paulrenzi/drone-detection-research/README.md

# trip/wire — low-cost acoustic drone detection

Published with GitHub Pages: https://paulrenzi.github.io/tripwire/

- `index.md` — overview and feasibility matrix
- `models/` — one page per sensor model (copy `models/_template.md` to add one)
- `research/` — cross-cutting research notes
- `changelog.md` — record rating changes and new research here
- `docs/PLAYBOOK-DRONE-DETECTION.md` — how the tripwire software is built and debugged (not published)

Built with Jekyll and the Just the Docs theme. Preview locally with `bundle exec jekyll serve` (optional) or just push — GitHub Pages builds it.

All content is compiled from public sources.
