paulrenzi/drone-detection-research/_handoff/2026-10-15-gpt61-cad-done.md

# Handoff: GPT-6.1's CAD run finished

Written at the commit that adds this file, whose parent is 6ab2442. 2026-10-15 ~22:40.
Supersedes the "IN PROGRESS" status in `2026-10-15-gpt61-cad-run.md`. Everything else there still holds.

## What happened

- Codex run PID 60296 (`gpt-6.1-sol`, effort `xhigh`, confirmed in `~/.codex/sessions/2026/10/15/rollout-...01a14247...jsonl`) ran 21:15 to 22:34 and ended `turn.completed`.
- `LAST_MESSAGE.md` was never written. Codex resolved `-o cad/gpt61/LAST_MESSAGE.md` against the wrong cwd ("system cannot find the path"). Its final message is the last `agent_message` in `run.jsonl`. **Next time, pass `-o` as an absolute path.**
- Its own report: 74/74 checks, 6/6 printed STEP/STL pairs validated, 17 renders. Dart 158.2 g, harness 183.5 g, 4 darts + harness 816.1 g.
- Paul said mid-run that "6.1 isn't working on this". The live process, log and file writes showed it was working. If he raises it again, ask what he was looking at; a `codex exec` run does not show in the Codex desktop app.

## Committed (explicit paths)

Scripts, `DESIGN.md`, `README.md`, `REVIEW.html`, `renders/` (17) and `out/` except four files over GitHub's 100 MB limit:
`out/assembly_carried.step`, `out/assembly_mid_release.step`, `out/assembly_stood.step` (244 MB each) and `out/bought_x500.step` (189 MB).
They are gitignored and regenerate with `build.py`. They exist only on Paul's PC.
Not committed: `sources/`, `cache/`, `vendor/`, `tmp/`, `run.*`.

## Open

- Paul has not reviewed the renders yet. Show them as they are; don't fix 6.1's work.
- The site is unchanged: `build-hardware.md` §1–2 still show the rejected v3/v2 renders. Ask Paul whether to replace or demote them.
