paulrenzi/drone-detection-research/_handoff/2026-10-15-gpt61-cad-run.md

# Handoff: the 3D models are being redone by GPT-6.1 (Codex agent)

HEAD at the time of writing: see the commit that adds this file (parent e75a807), 2026-10-15 ~21:20.
Supersedes `2026-10-15-build-pages-done.md`. Everything there about the hardware models is now superseded by the verdict below.

## Paul's verdict, settled (do not reopen)

- My CadQuery models (`cad/dart.py`, `harness*.py`, `v2.py`, `v3.py`) and their renders are **"total bullshit; nobody would build models like that."**
- **The concept is fine. The failure is the 3D modelling.** The parts were boxes and cylinders. Bought parts were blocks. The drone was not in the assembly, dimensions were guesses, and the "checks" only tested the model against itself.
- Paul wants **GPT-6.1 doing the CAD,** and said I didn't know how to ask it. The old ask was a single urllib API call, with no tools and my own design in the prompt, and it timed out.
- 🛑 **Don't re-pitch the concept or debate the CAD tool. Don't produce more Claude-built CAD.**

## What's live on the site (paulrenzi.github.io/drone-detection-research)

- `build-hardware.md` §1 is v3: three parts per dart, 15 parts per kit, ≈$50 parts list. It went live at e75a807 and was render-verified.
- §2 is v2 (its harness is still the "current" one), §3–4 are v1, §5 is TL-1, §6 is the parts list and §7 is "not designed yet".
- The renders on that page are the ones Paul rejected. **Nothing has been pulled from the site yet.** Ask Paul whether to demote or replace them once GPT-6.1's model exists.
- On cost, I told Paul honestly that it was cut by a fifth, not half. Cells are $20 of the $50. EVE 35V cells at $2.50 would halve it, but they were sold out at 18650batterystore and imrbatteries on 10-15.

## The GPT-6.1 run (IN PROGRESS at handoff)

- **How it's invoked:** Codex CLI bundled with the desktop app, signed in with Paul's ChatGPT account (not the paid API):
  `C:\Users\paulm\AppData\Local\OpenAI\Codex\bin\2e5e00daee91c61d\codex.exe exec -C C:\Users\paulm\drone-detection-research -c model_reasoning_effort='"xhigh"' -o cad/gpt61/LAST_MESSAGE.md --json "Read cad/gpt61/BRIEF.md and carry it out completely. Work only inside cad/gpt61/."`
  Config is in `~/.codex/config.toml`: model `gpt-6.1-sol`, approval `never`, sandbox `danger-full-access`.
- **The brief** is `cad/gpt61/BRIEF.md` (committed). It fixes the concept and asks for:
  - real bought-part models: X500 V2 frame, props, legs and rails; SG90; Heltec V3; INMP441; 18650;
  - properly modelled printed parts, with snap geometry, FDM clearances, wire channels and a serviceable pod;
  - the drone in the assembly, checked for interference in the carried, releasing and in-soil states;
  - mass and balance, STEP/STL exports and section renders, which it must inspect itself;
  - `DESIGN.md`.
- **Status:** started 21:15 as Codex process **PID 60296** (start time 9:15:44 PM). By 21:20 it had downloaded `x500v2-frame.step`, `heltec-v3-non-exact.step`, `X500-assembly.pdf` and `samsung-25r.pdf` into `cad/gpt61/sources/` (48 MB, gitignored), and had written probe and render scripts.
- **It's done when** `cad/gpt61/LAST_MESSAGE.md` exists, or `run.jsonl` contains `"turn.completed"`, `"turn.failed"` or `"type":"error"`. Progress is in `cad/gpt61/run.jsonl` (gitignored).
- **If the PC session died,** check whether PID 60296 is alive. If it isn't and there's no `LAST_MESSAGE.md`, rerun the command above; it reads the same brief.
- 🛑 **Never kill `codex.exe` by name.** The Codex/ChatGPT desktop app runs its own `codex.exe` backends from the same path. I killed three of them by accident on 10-15, which interrupted any desktop task running at the time; the app respawned them. Target only the PID of your own run.

## Next steps

1. When the run finishes, read `cad/gpt61/DESIGN.md` and **look at every render in `cad/gpt61/renders/`**. Show Paul the renders and the write-up **as they are**: don't polish them, and don't silently fix 6.1's work.
2. Commit 6.1's scripts, `out/` and renders by explicit path (not `sources/` or `run.*`), and push.
3. Ask Paul before touching the site: whether to replace §1–2's renders with 6.1's model, or demote the old ones.

## Still open from earlier (unchanged)

- Measure the X500 rail spacing, the SG90 shaft height above its tabs, the rod's real diameter, the cell's real diameter (25R is 18.4 mm), and the bare Heltec V3's sleep current on battery.
- Batear nonce-fix PR: outward-facing, needs Paul's OK.
- Offered but not done: retrieval and printed-drone cost sections, and stale X500 prices on `research/delivery-drone.md`.

## Rules that bit this session

- Playwright runs from the system `python`, not the cad venv.
- A heading id that starts with a digit needs `document.getElementById`, not a CSS `#` selector.
- kramdown renders `v2's` as `v2’s` (curly), so text checks must use the curly form.
- Pages build check: `gh api repos/paulrenzi/drone-detection-research/pages/builds/latest`. Verify by rendering `?cb=<sha>`.
