paulrenzi/drone-detection-research/cad/gpt61/LAST_MESSAGE-tail-fins.md

Completed inside `cad/gpt61/`; no commit or push. See [REVIEW.html](/C:/Users/paulm/drone-detection-research/cad/gpt61/REVIEW.html) and the rebuilt [print kit](/C:/Users/paulm/drone-detection-research/cad/gpt61/out/print-kit.zip).

- **Fins:** four PETG trapezoids on two bonded, keyed collars; 6.46 in root chord, 0.59 in exposed span, 0.047 in thick. Print without supports.
- **Estimated static margin:** 1.84 in / 1.25 body widths before; **3.06 in / 2.08 widths after**.
- **Mass and balance:** 5.91 oz per dart; balance point **10.891 in from the tip**. Four darts: 1.48 lb; with harness: **1.88 lb**. Dummy matches with 1.30 oz ballast.
- **Carriage:** retained flat at balance. Tilted alternatives interfere with the existing head support.
- **Validation:** **164/164 checks pass**, 14 printed export pairs validated, all 38 PNGs inspected. Updated STEP assemblies, GLBs, manifests and receipts; GLB validators report zero errors or warnings.

Estimated no-drag tilt from vertical:

| Drop | 5 mph | 10 mph | 15 mph |
|---|---:|---:|---:|
| 16 ft | 12.9° | 24.6° | 34.4° |
| 33 ft | 9.0° | 17.7° | 25.5° |
| 49 ft | 7.4° | 14.6° | 21.4° |

All requested CAD/package work is complete. Nothing has been printed, dropped or flown; controlled dummy drops must establish the actual fall behaviour.
