paulrenzi/drone-detection-research/cad/gpt61/LAST_MESSAGE-us-units.md

Completed entirely inside `cad/gpt61/`.

- Regenerated and inspected all **33 PNGs** at full size.
- Converted all requested documents to US units and fixed typography.
- **140/140 geometry checks**, **12/12 export checks** pass; four GLBs validate with zero errors or warnings.
- Rebuilt the print kit and refreshed receipts.

Geometry, cameras, colours and machine-readable values remain unchanged. Only required metric exceptions remain. No commit or push.

[Review gallery](/C:/Users/paulm/drone-detection-research/cad/gpt61/REVIEW.html) · [Print kit](/C:/Users/paulm/drone-detection-research/cad/gpt61/out/print-kit.zip)
