paulrenzi/drone-detection-research/cad/gpt61/LAST_MESSAGE-xiao.md

Completed inside `cad/gpt61/`: redesigned XIAO/Wio pod with USB/BOOT access, adjustable stake adapter, balanced inert dummy, and regenerated CAD, renders, documentation and web models.

- Dart: **147.93 g**, previously 158.16 g.
- Hanger: **254.44 mm from tip**.
- Harness: **183.48 g**; four-dart payload: **775.20 g**.
- Mic height: **500 mm**; dummy ballast: **36.82 g**.

All **140 geometry checks** and **12 STEP/STL export checks** pass. All **33 renders inspected**. Four GLBs validate with zero errors/warnings: dart **3.23 MB**, harness **4.13 MB**, aircraft **18.96 MB**, stake **3.22 MB**.

[Review gallery](C:/Users/paulm/drone-detection-research/cad/gpt61/REVIEW.html) · [Design and sources](C:/Users/paulm/drone-detection-research/cad/gpt61/DESIGN.md) · [Print kit](C:/Users/paulm/drone-detection-research/cad/gpt61/out/print-kit.zip)

Unverified dimensions remain marked **MEASURE**. Nothing printed, dropped or flown; no commit or push.
