paulrenzi/drone-detection-research/tools/laymodel/out/fibre-summary.md

## Fibre trunks and wider coverage (1000 lays each, GPS jammed, confirm)

| Case | Front darts | Relays | Planned | Planned sorties | Whole | Survives any one dart loss | Survives one fibre cut | Darts used | 9 in 10 | Sorties | Hours | Hops home, median / 9 in 10 | Cost of a lay | Worst warning, 10th pct |
|---|---|---|---|---|---|---|---|---|---|---|---|---|---|---|
| Last plan: radio trunks, +/-45 | 13 | 12 | 25 | 7 | 99% | 93% | - | 34.9 | 40 | 9.3 | 2.2 | 10 / 11 | $1309 | 58 s |
| Fibre trunks, +/-45 | 13 | 0 | 13 | 4 | 99% | 91% | 98% | 17.6 | 21 | 5.6 | 1.1 | 6 / 6 | $883 | 58 s |
| Radio trunks, +/-60 | 16 | 12 | 28 | 7 | 98% | 93% | - | 40.2 | 46 | 10.7 | 2.9 | 12 / 13 | $1506 | 58 s |
| **Fibre trunks, +/-60 (the plan)** | 16 | 0 | 16 | 5 | 98% | 91% | 98% | 22.2 | 26 | 7.1 | 1.4 | 7 / 8 | $1067 | 58 s |
| same, judged at +/-45 | 16 | 0 | 16 | 5 | 99% | 92% | 98% | 22.2 | 26 | 7.1 | 1.4 | 7 / 8 | $1067 | 58 s |
| compass 4 deg, not 2 | 16 | 0 | 16 | 5 | 89% | 82% | 97% | 22.7 | 27 | 7.2 | 1.5 | 7 / 8 | $1080 | none (a track no dart hears) |
| radio hop 800 ft, not 980 | 19 | 0 | 19 | 6 | 99% | 91% | 97% | 26.7 | 31 | 8.0 | 1.7 | 9 / 10 | $1236 | 58 s |
| landings 95% upright | 16 | 0 | 16 | 5 | 100% | 93% | 99% | 19.8 | 23 | 6.3 | 1.2 | 7 / 8 | $952 | 58 s |
| 1 fibre in 5 breaks while laid | 16 | 0 | 16 | 5 | 98% | 87% | 93% | 23.3 | 28 | 7.8 | 1.7 | 7 / 8 | $1152 | 58 s |
| 15 mph wind | 16 | 0 | 16 | 7 | 99% | 91% | 97% | 22.1 | 26 | 8.1 | 1.7 | 7 / 8 | $1059 | 58 s |
| Fibre trunks, +/-45, compass 4 deg | 13 | 0 | 13 | 4 | 92% | 83% | 97% | 17.9 | 22 | 5.7 | 1.1 | 6 / 6 | $895 | 56 s |
| Fibre trunks, +/-60, compass 4 deg, judged at +/-45 | 16 | 0 | 16 | 5 | 94% | 86% | 96% | 22.7 | 27 | 7.2 | 1.5 | 7 / 8 | $1080 | 57 s |
| Radio trunks, +/-45, compass 4 deg | 13 | 12 | 25 | 7 | 91% | 87% | - | 35.1 | 40 | 9.3 | 2.2 | 10 / 11 | $1315 | 56 s |
| Radio trunks, +/-60, compass 4 deg | 16 | 12 | 28 | 7 | 90% | 84% | - | 40.3 | 47 | 10.7 | 2.9 | 12 / 13 | $1512 | 54 s |
