paulrenzi/drone-detection-research/research/frontline-kit.md

---
title: What troops have, and what listening adds
parent: Research Notes
nav_order: 0.35
---

# What front-line troops actually have, and what listening adds
{: .no_toc }

<p class="vz-lede">What Ukrainian troops within about 12 mi of the line actually use against drones in 2025–2026, and what a cheap listener adds to each. <strong>Against fibre-optic FPVs, the real baseline is ears, eyes and a firearm.</strong></p>

### Against a fibre-optic FPV, what works

<div class="vz-tiles">
  <div class="vz-tile"><span class="vz-tile-q">Ears and eyes</span><span class="vz-tile-cost">the main detector today; ~5 s</span><span class="vz-chip vz-chip-open">partly</span></div>
  <div class="vz-tile"><span class="vz-tile-q">Radio detectors</span><span class="vz-tile-cost">blind: no radio link to hear</span><span class="vz-chip vz-chip-no">doesn't</span></div>
  <div class="vz-tile"><span class="vz-tile-q">Signature detectors</span><span class="vz-tile-cost">radio-based too</span><span class="vz-chip vz-chip-no">doesn't</span></div>
  <div class="vz-tile"><span class="vz-tile-q">Jammers</span><span class="vz-tile-cost">nothing to jam</span><span class="vz-chip vz-chip-no">doesn't</span></div>
  <div class="vz-tile"><span class="vz-tile-q">Shotguns and rifles</span><span class="vz-tile-cost">short range only</span><span class="vz-chip vz-chip-open">partly</span></div>
  <div class="vz-tile"><span class="vz-tile-q">Shooter teams</span><span class="vz-tile-cost">need to know where</span><span class="vz-chip vz-chip-open">partly</span></div>
  <div class="vz-tile"><span class="vz-tile-q">Net-guns</span><span class="vz-tile-cost">very close range</span><span class="vz-chip vz-chip-open">partly</span></div>
  <div class="vz-tile"><span class="vz-tile-q">AI turret</span><span class="vz-tile-cost">claimed; at the position only</span><span class="vz-chip vz-chip-done">works</span></div>
  <div class="vz-tile"><span class="vz-tile-q">Interceptor drones</span><span class="vz-tile-cost">no verified FPV kill</span><span class="vz-chip ">unknown</span></div>
  <div class="vz-tile"><span class="vz-tile-q">Nets and net tunnels</span><span class="vz-tile-cost">leaky; drones fly under</span><span class="vz-chip vz-chip-open">partly</span></div>
  <div class="vz-tile"><span class="vz-tile-q">Movement discipline</span><span class="vz-tile-cost">night, fog, on foot</span><span class="vz-chip vz-chip-open">partly</span></div>
  <div class="vz-tile"><span class="vz-tile-q">Acoustic sensors</span><span class="vz-tile-cost">makers' claims only</span><span class="vz-chip ">unknown</span></div>
</div>
<p class="vz-bar-note">From first-hand accounts, purchase volumes and our inference. No source ranks these against each other or says what share of units has each. Reviewed 2026-10-15.</p>

<div class="vz-cards">
  <div class="vz-card"><p class="vz-card-num">The gap</p><p>The most common warning device, the radio detector, can't hear a fibre-optic drone. Still open in 2026</p></div>
  <div class="vz-card"><p class="vz-card-num">The money</p><p>goes to interceptor drones, the most-ordered category in 2026, bought against recon drones and Shaheds, not attacking FPVs</p></div>
  <div class="vz-card"><p class="vz-card-num">Where we help most</p><p>Most FPVs fibre-optic, units moving in the open, no turret yet. Only the line gives a minute (inference)</p></div>
</div>

## The details

Each section opens for the full reasoning, numbers and sources.

<button type="button" class="layer-toggle" data-layers-toggle>Open all sections</button>

<details class="layer" id="the-short-version-in-full" markdown="block">
<summary><span class="layer-title">The opening, as first written</span><span class="layer-sub">What the page covers, and why no source ranks these measures</span></summary>

This page covers what Ukrainian troops within about 12 mi of the line actually use against FPV and recon drones in 2025–2026, as opposed to what is in catalogues. For each item, it asks what a cheap acoustic listener adds. Use it with [What the line gains in lives]({{ site.baseurl }}{% link research/lives-model.md %}): that page estimates the lives; this one says what the line is up against. Reviewed 2026-10-15.

{: .warning }
> **No source ranks these measures against each other.**
> - We found no soldier survey and no RUSI, ISW, CNA or IISS comparison of counter-FPV measures.
> - We found no figure for what share of units has any item.
> - The judgements below come from first-hand accounts, purchase volumes and our own inference, labelled as such.

</details>

<details class="layer" id="short-answer" markdown="block">
<summary><span class="layer-title">Short answer</span><span class="layer-sub">Ears and firearms, blind radio detectors, jamming losing ground, interceptors, AI turrets</span></summary>

- **Against fibre-optic FPVs, the real baseline is ears, eyes and a firearm.** A Ukrainian border guard spokesman said fibre-optic drones are detected "by ear and visually" and "You can only shoot it down" ([Gwara Media, Feb 2025](https://gwaramedia.com/en/border-guards-russian-troops-actively-use-fiber-optic-drones-resistant-to-jamming-north-of-kharkiv-oblast/)). A listener at the position competes first with a soldier's hearing, not with a product.
- **The most common warning device is blind to fibre-optic drones.** Radio detectors such as Chuyka and Tsukorok can't hear a drone with no radio link. This gap is still open in 2026.
- **Jamming is losing ground.** A brigade EW company commander: "Jamming no longer works", and against fibre-optic drones "There was, in fact, nothing to counter them" ([Euromaidan Press, Jun 2025](https://euromaidanpress.com/2025/06/26/is-the-electronic-warfare-era-over-a-frontline-ew-officers-story-of-ukraines-drone-tug-of-war)). So cueing jammers (the [MEDUSA]({{ site.baseurl }}{% link research/competitors.md %}#partners-and-the-budget-we-compete-for) pairing) is worth less each year.
- **The money is going to interceptor drones, not detection.** Interceptors were the most-ordered category on Ukraine's Brave1 Market in Jan–Sep 2026, out of more than 590,000 drones ordered. But they are bought against recon drones and Shaheds, not against FPVs attacking a position.
- **The nearest rival at a position is the AI turret.** It detects and tracks fibre-optic drones itself, and "more than 10 military units" had it by May 2026. Where it spreads, it covers the last seconds at the position. It does not give a minute's warning to people about to move.
- **Overall (inference):** the forward line's relative value is highest where three things hold:
  1. most FPVs are fibre-optic;
  2. units must move in the open;
  3. turrets have not arrived.

  A listener at the position adds least once a turret or a good sentry is there. A minute's warning of fibre-optic drones is offered by nothing else we found.

</details>

<details class="layer" id="the-inventory" markdown="block">
<summary><span class="layer-title">The inventory</span><span class="layer-sub">Every measure: how common, whether it works against fibre-optic FPVs, and what a listening line adds</span></summary>

Key: ✅ works, 🟡 partly, ❌ doesn't, ❔ unknown.

| What troops have | How common at the front | Against fibre-optic FPVs | Warning it needs or gives | What a listening line adds |
|---|---|---|---|---|
| **Ears and eyes** (sentries) | Universal | 🟡 the main detector today | Gives ~5 s at ~490 ft (unmeasured) | A position listener competes with this directly. The line gives a minute instead |
| **Radio detectors** (Chuyka, Tsukorok) | The most widely distributed warning device. Tsukorok aimed at "up to 10,000 detectors every month" in 2024 ([Foreign Policy](https://foreignpolicy.com/2024/08/05/ukraine-russia-war-drone-detectors-jamming-tsukorok/)). Share of units equipped: not found | ❌ "commonly used by units to warn them of FPVs", but cannot detect fibre-optic drones ([Kyiv Independent, May 2025](https://kyivindependent.com/as-russias-fiber-optic-drones-flood-the-battlefield-ukraine-is-racing-to-catch-up/)) | Gives ~1.5–2.5 min against radio FPVs | **The fibre-optic half.** A partner, not a rival: the [second box]({{ site.baseurl }}{% link research/competitors.md %}) |
| **Signature-reading detectors** | "the first Ukrainian device capable of distinguishing drone types" was only being tested in Jul 2026; Russian soldiers already carry Chinese "Bulat" detectors ([Euromaidan Press, Jul 2026](https://euromaidanpress.com/2026/07/15/you-cant-jam-what-you-cant-identify-ukraine-just-fielded-its-first-portable-drone-detector/)) | ❌ radio-based. Its tester also complains "the front is already saturated with video transmitters up to 8 GHz" | Radio warning only | Same as above |
| **Jammers** (trench, vehicle, position) | Many makers; EW added to the DOT-Chain Defence marketplace in Nov 2025, with nearly UAH 6 million ordered on the first day ([MoD](https://mod.gov.ua/en/news/frontline-units-to-receive-additional-electronic-warfare-assets-via-dot-chain-defence)) | ❌ "There was, in fact, nothing to counter them". Infantry kits "only partially solved the problem" (EW commander, 56th Brigade) | Needs a cue to switch on | A cue for radio drones that detectors miss. **Shrinking value** as fibre-optic and multi-band drones grow |
| **Shotguns and rifles** | Common. Troops are often issued "shot that is too fine to stop a heavy aerial target" | 🟡 only at short range. With heavier 15-inch FPVs, the safe distance is at least 130–160 ft, firing rifles "while remaining in cover" ([Militarnyi, Jun 2026](https://militarnyi.com/en/news/shotguns-ineffective-15-inch-fpv-drones/)) | Needs seconds | Seconds plus a direction, if a listener can give one ([localization]({{ site.baseurl }}{% link research/localization.md %})). A minute adds little |
| **Mobile shooter teams** | Used by some brigades. "when Russian drone operators spot these teams, they tend to avoid those areas" ([UNITED24, Oct 2025](https://united24media.com/war-in-ukraine/can-fiber-optic-drones-be-stopped-how-ukraine-faces-the-unjammable-threat-12502)) | 🟡 | Needs to know where drones fly | **Inference:** a line's record of where drones cross could show where to send teams. Not tested |
| **Net-guns** | "uncommon", a "last‑resort" weapon (same UNITED24 report) | 🟡 very close range | Needs seconds | ≈0 |
| **AI turret** (Brave1 participant) | "More than 10 military units", May 2026 ([MoD](https://mod.gov.ua/en/news/over-10-military-units-are-now-equipped-with-a-ukrainian-ai-powered-turret-capable-of-destroying-ua-vs-with-a-single-button-press)); no price published | ✅ claimed: it "autonomously detects, tracks, and calculates the flight path" of fibre-optic drones | Brings its own sensor | Little at the position. The line still warns people away from the turret |
| **Interceptor drones** | Most-ordered category on Brave1 Market, Jan–Sep 2026 ([MoD via migflug, Sep 2026](https://migflug.com/afterburner/?p=24873239)) | ❔ we found no verified interception of an attacking FPV | Needs a cue and lead time | A possible cue against recon drones (inference; T11 decides whether we hear them). Unproven against FPVs |
| **Nets, net tunnels, vehicle nets** | At "all positions" (93rd Brigade, UNITED24); 2,500 mi more road planned for 2026 | 🟡 leaky. "They burn and melt. 'Waiting' drones can also hide under the nets"; videos show fibre-optic drones "simply flying underneath the nets to hit Ukrainian vehicles" (Kyiv Independent) | None | Warning for whatever gets through. Nothing against drones already waiting under nets |
| **Movement discipline** (night, fog, on foot) | Universal. Logistics shifted to daytime, and more people move on foot because "Enemy drone operators are currently more focused on targeting vehicles" (UNITED24) | 🟡 | Hours | The go/no-go minute. **This is where the [lives estimate]({{ site.baseurl }}{% link research/lives-model.md %}) puts nearly all the value** |
| **Acoustic sensors** (Zvook NW0, Kara Dag) | Not found in front-line use; maker claims only. Kara Dag notes that most microphones struggle to tell drone noise from ambient sound beyond about 330 ft ([Euromaidan Press, Feb 2025](https://euromaidanpress.com/2025/02/03/russias-fiber-optic-drones-dodge-jamming-but-ukraine-hunts-them-with-infrared-and-sound/)) | ❔ claimed | Seconds at the position | Direct competitors ([competitor analysis]({{ site.baseurl }}{% link research/competitors.md %})) |

</details>

<details class="layer" id="what-this-means-for-listening-tech-inference" markdown="block">
<summary><span class="layer-title">What this means for listening tech (inference)</span><span class="layer-sub">Where a listener adds most and least</span></summary>

1. **There are two different products here.**
   - **A listener at the position** gives about 10 seconds. It competes with sentries' ears, and soon with AI turrets that carry their own sensors. Its edge is cost and never tiring.
   - **A forward line** gives about a minute. Nothing we found gives a minute's warning of fibre-optic FPVs.
2. **The gap is real and still open.** Radio detectors can't hear fibre-optic drones, jamming is failing against them, and nets leak. Every first-hand account ends at ears, eyes and a gun.
3. **Pairing with jammers is a fading benefit.** It still holds against radio FPVs, but the EW commander's verdict means the line should be sold on warning people, not on cueing jammers.
4. **Interceptors are where the budget is.** If a line can cue interceptors against recon drones, it is tied to the fastest-growing purchase. That depends on T11 (can we hear them) and on whether interceptor crews want an acoustic cue. Ask in T18.
5. **The buying route is open.** Brave1 Market averages eight days to deliver stocked items, and 180 brigades have guaranteed budgets on DOT-Chain Defence. Being listed does not guarantee anyone buys.

</details>

<details class="layer" id="what-we-could-not-find" markdown="block">
<summary><span class="layer-title">What we could not find</span><span class="layer-sub">The gaps in the evidence</span></summary>

- What share of units has any of these items.
- Per-brigade counter-drone spend.
- Prices for jammers, the AI turret and small radars.
- Any measured effect of a detector on casualties.
- Any soldier survey ranking what helps most.
- **A demand for small mobile radar.** A drone-unit commander reportedly asked for mobile radar every 1.2–2.5 mi along the line. We saw that only in search snippets. If true, small radar is the nearest rival for forward warning, and it may struggle against low-flying drones.

T18 should ask which of these a unit actually has and which it trusts.

</details>
