paulrenzi/drone-detection-research/research/existing-systems.md

---
title: Existing systems and benchmarks
parent: Research Notes
nav_order: 1
---

# Existing systems and benchmarks
{: .no_toc }

1. TOC
{:toc}

## Fielded low-cost acoustic networks

| System | Origin | Hardware | Scale | Cost per sensor | Notes |
|---|---|---|---|---|---|
| **Sky Fortress** | Ukraine | Phone + mic on ~6.6 ft pole; central fusion; tablets for fire teams | ~10k sensors (2024–25), ~14k by July 2025 | $400–1,000 | Whole network ~$5M. Fuses radar data. Lithuania contracted a pilot. |
| **Zvook** | Ukraine (Lviv) | Microcomputers on radio towers | Not disclosed | Not disclosed | Started as civilian volunteer project. Vehicle version tested at NATO BATT26 with Latvia. |
| **Drone Rada** (Mainline) | Lithuania | Volunteers' Android phones near windows | Target 10,000 participants (June 2026) | ~$0 to operator | Crowd-sourced; privacy-focused, minimal data. |

## Commercial acoustic sensors (comparators)

| Product | Origin | Claim | Notes |
|---|---|---|---|
| **Discovair G2** (Squarehead Technology) | Norway | Detects and tracks small drones up to several hundred yards, no line-of-sight needed | Large patented mic array; sold inside DroneShield and Hensoldt XPELLER counter-UAS systems. |
| Roke acoustic detection | UK | Array-based drone detection | Research/product line from a UK defence firm. |

{: .note }
> Squarehead is likely the "Norway" half of the original framing. A specific open-source Ukraine/Norway drone **sound library** has **not** been found yet — see [Datasets]({{ site.baseurl }}{% link research/datasets.md %}).

## Who is pushing for this

- **Gen. James Hecker, USAFE / NATO Allied Air Command** — publicly urged copying Ukraine's acoustic network (2024) and mentioned tethered aerostats.
- **Lt. Gen. Stephen Gainey, US Army SMDC** — cited as an advocate; evaluations at Ramstein and in Romania.
- **Lithuania, Latvia, Poland, Baltic states** — piloting acoustic networks after airspace violations.

## Sources

- [TWZ — Ukraine's acoustic network eyed by U.S.](https://www.twz.com/air/ukraines-acoustic-drone-detection-network-eyed-by-u-s-as-low-cost-air-defense-option)
- [Euromaidan Press — Lithuania selects Ukrainian tech](https://euromaidanpress.com/2025/07/29/lithuania-to-deploy-ukrainian-drone-detection-system-by-2026-after-russian-airspace-violations/)
- [Startup Estonia — Zvook at BATT26](https://ecosystem.startupestonia.ee/news/note/zvook-tests-vehicle-mounted-acoustic-drone-detector-at-nato-s-batt26)
- [LRT — Drone Rada](https://www.lrt.lt/en/news-in-english/19/2965205/lithuanian-startup-launches-open-source-network-to-detect-shahed-type-drones)
- [Hensoldt — XPELLER adds Squarehead Discovair](https://hensoldt.net/news/hensoldt-expands-xpeller-counter-uav-product-family)
- [DroneDJ — DroneShield + Squarehead](https://dronedj.com/2020/12/07/droneshield-squarehead-to-offer-counter-drone-solutions/)
- [Roke — acoustic drone detection](https://www.roke.co.uk/innovations/acoustic-drone-detection)
