paulrenzi/drone-detection-research/research/index.md

---
title: Research Notes
nav_order: 3
has_children: true
permalink: /research/
---

# Research Notes

Background that applies across all the sensor models: what already exists, the physics of range and cost, how positions are computed, parts, training data, military integration, and the rules that apply.

Add a new note by creating a Markdown file in `research/` with `parent: Research Notes` in its front matter.
