paulrenzi/drone-detection-research/assets/images/kit/camera-drone.jpg

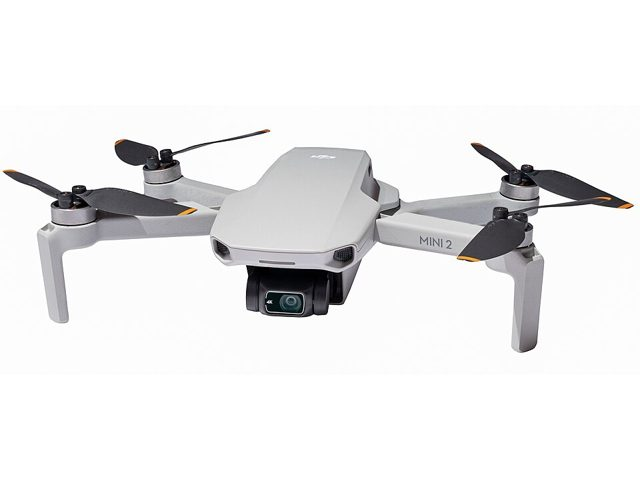
assets/images/kit/camera-drone.jpg
