paulrenzi/drone-detection-research/assets/images/kit/esp32-s3.jpg

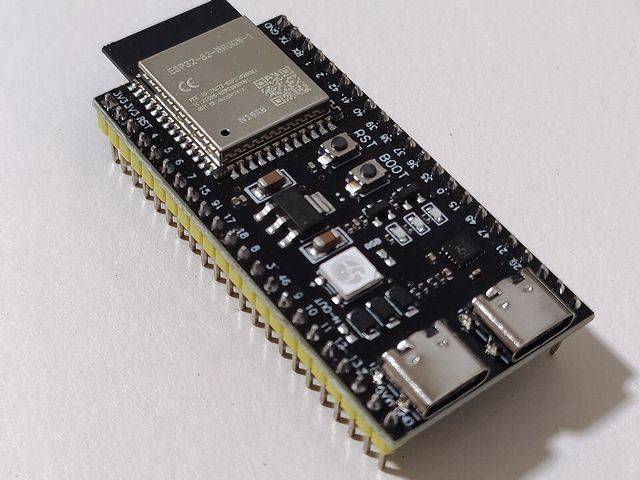
assets/images/kit/esp32-s3.jpg
