paulrenzi/drone-detection-research/assets/images/kit/fpv-drone.jpg

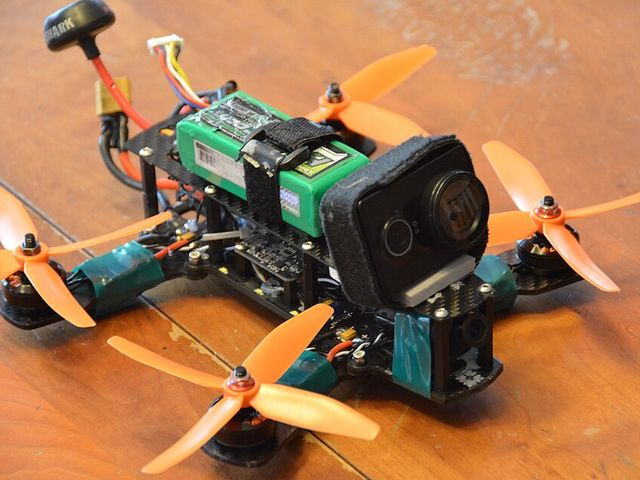
assets/images/kit/fpv-drone.jpg
