paulrenzi/drone-detection-research/assets/images/kit/lora-board.jpg

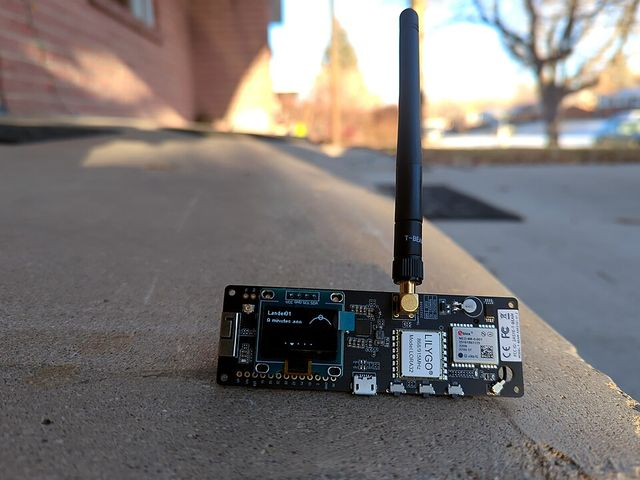
assets/images/kit/lora-board.jpg
