paulrenzi/drone-detection-research/assets/images/kit/microsd.jpg

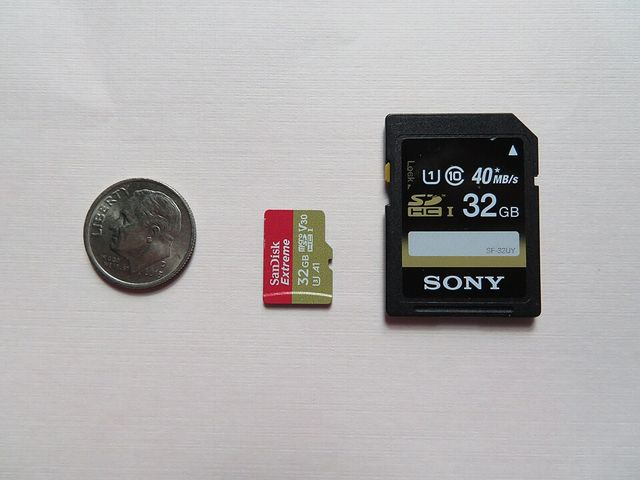
assets/images/kit/microsd.jpg
