paulrenzi/drone-detection-research/assets/images/kit/mics-breadboard.jpg

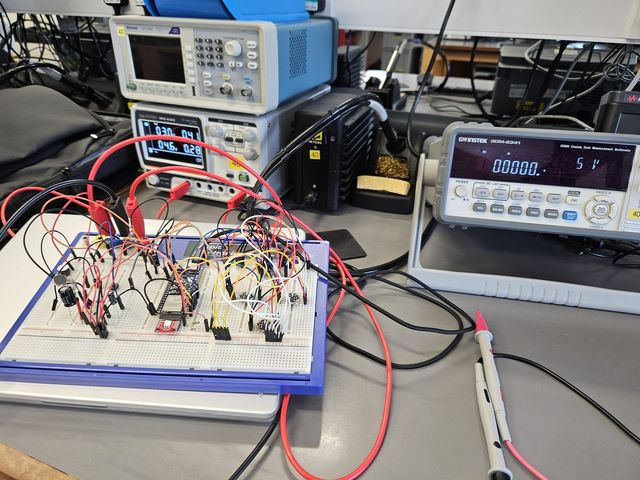
assets/images/kit/mics-breadboard.jpg
