paulrenzi/drone-detection-research/assets/images/kit/power-bank.jpg

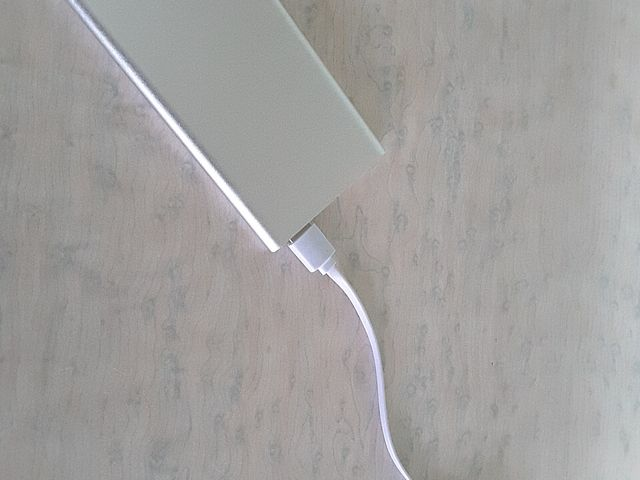
assets/images/kit/power-bank.jpg
