paulrenzi/drone-detection-research/assets/images/kit/tripod.jpg

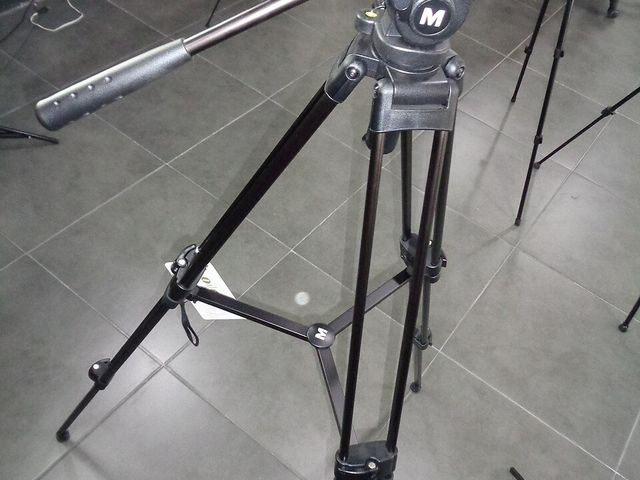
assets/images/kit/tripod.jpg
