paulrenzi/drone-detection-research/assets/images/kit/windscreen.jpg

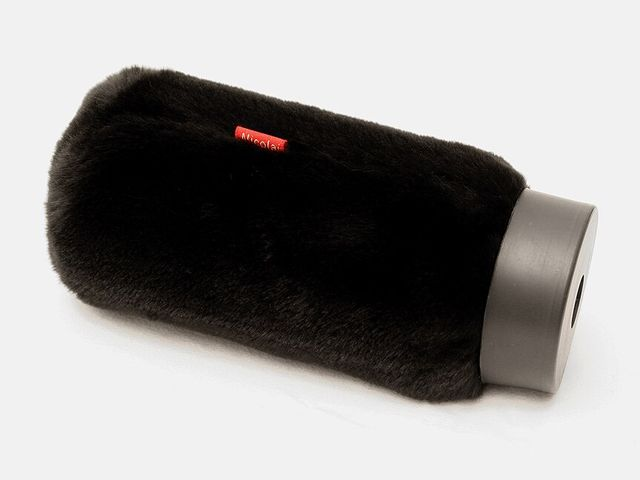
assets/images/kit/windscreen.jpg
