paulrenzi/drone-detection-research/assets/video/lay-net-poster.png

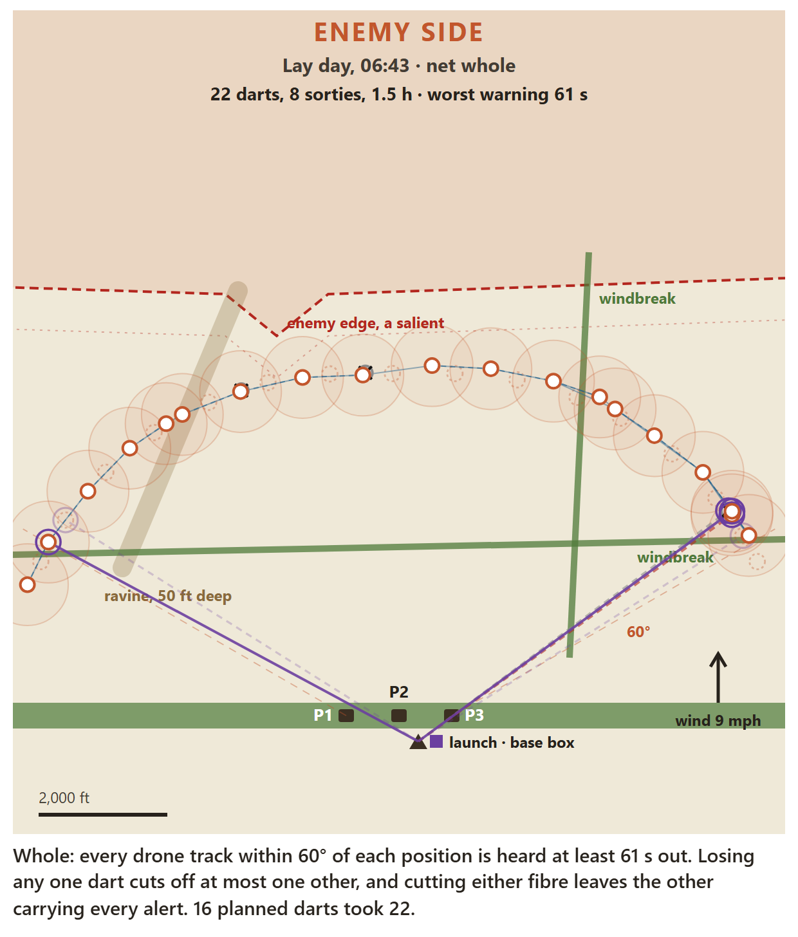
assets/video/lay-net-poster.png
