paulrenzi/drone-detection-research/cad/gpt61/renders/aircraft_exploded.png

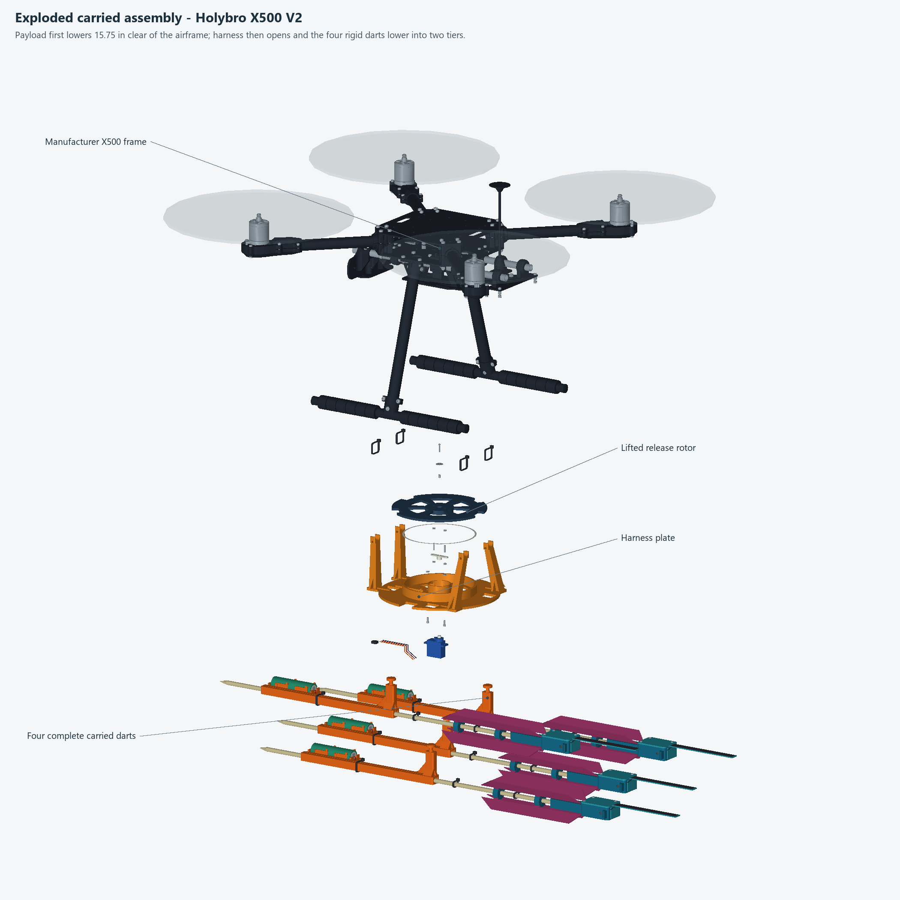
cad/gpt61/renders/aircraft_exploded.png
