paulrenzi/drone-detection-research/cad/gpt61/renders/bought_servo.png

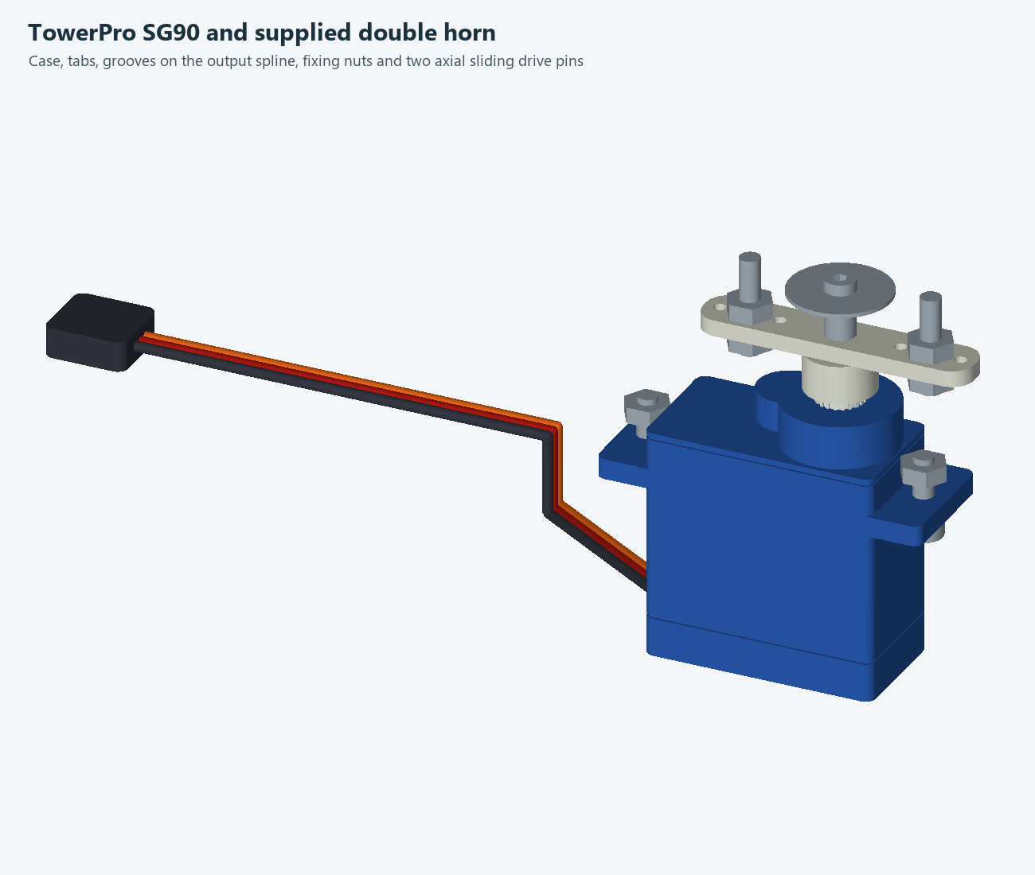
cad/gpt61/renders/bought_servo.png
