paulrenzi/drone-detection-research/cad/gpt61/renders/bought_xiao_wio.png

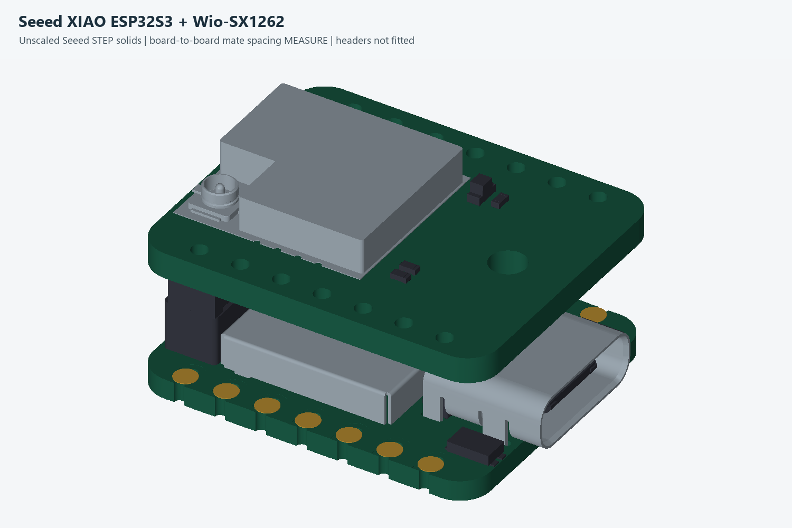
cad/gpt61/renders/bought_xiao_wio.png
