paulrenzi/drone-detection-research/cad/gpt61/renders/dart_exploded.png

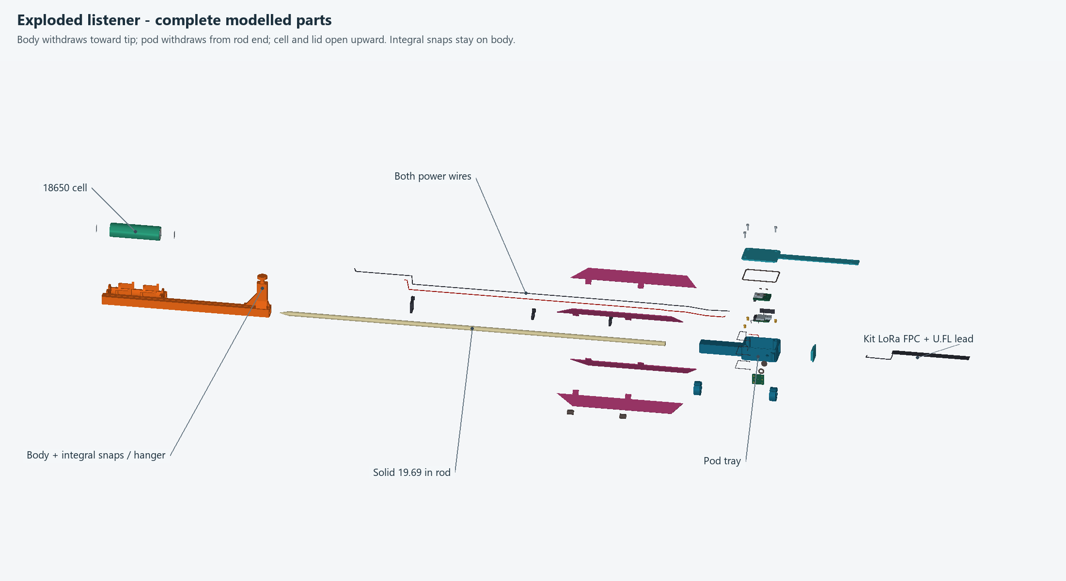
cad/gpt61/renders/dart_exploded.png
