paulrenzi/drone-detection-research/cad/gpt61/renders/dart_exploded_pod.png

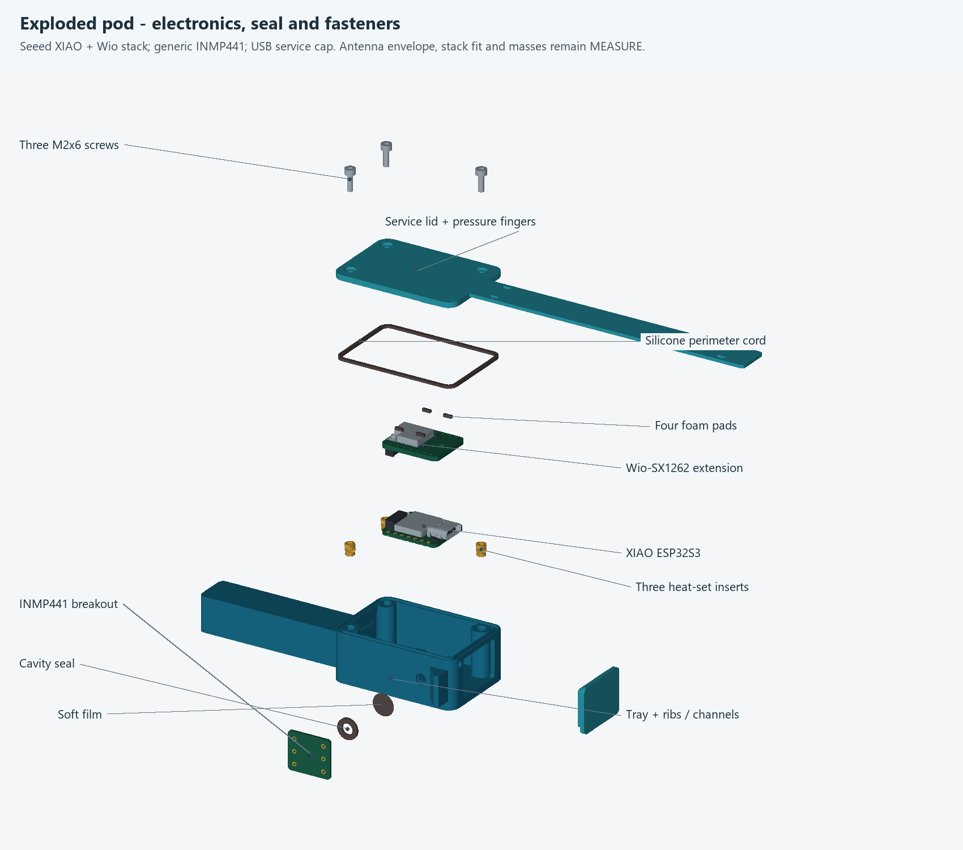
cad/gpt61/renders/dart_exploded_pod.png
