paulrenzi/drone-detection-research/cad/gpt61/renders/dart_fins_detail.png

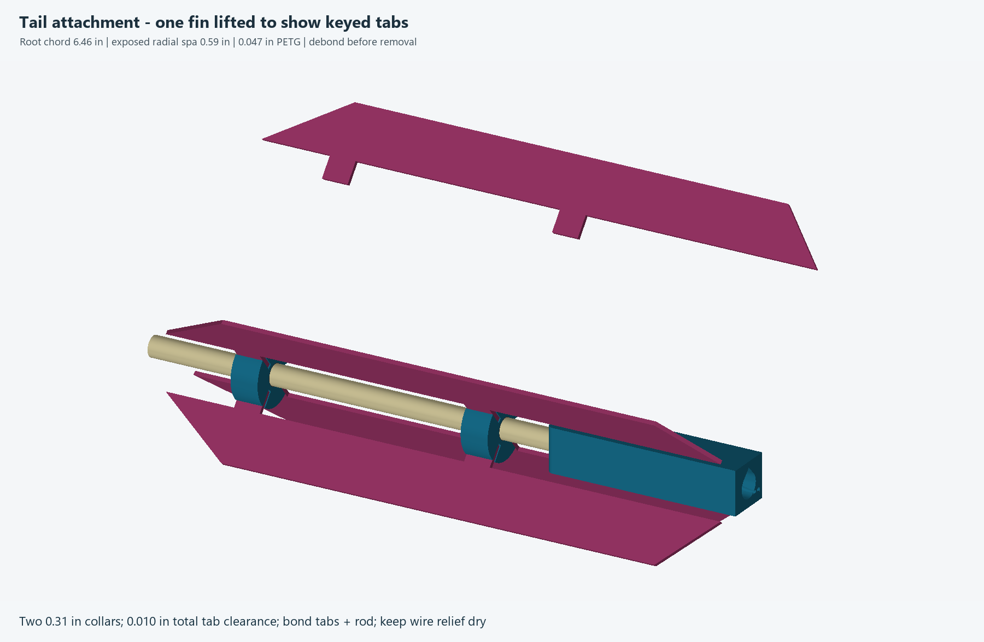
cad/gpt61/renders/dart_fins_detail.png
