paulrenzi/drone-detection-research/cad/gpt61/renders/dart_stood.png

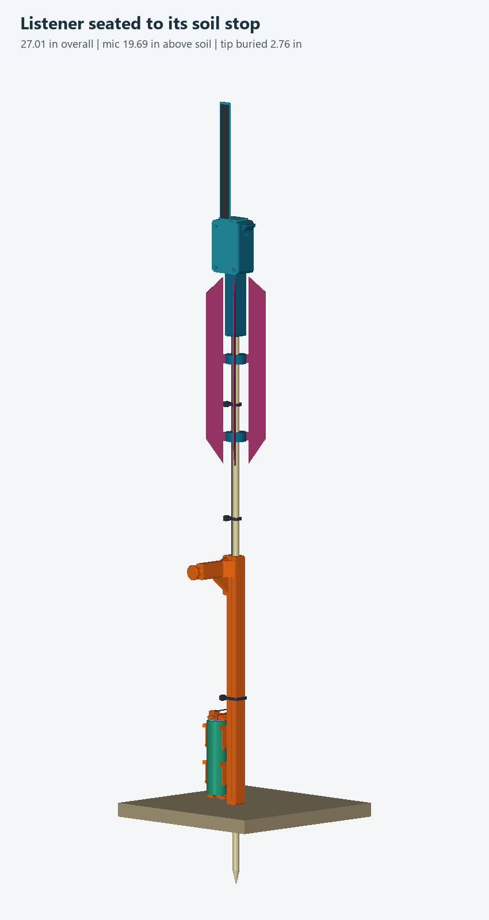
cad/gpt61/renders/dart_stood.png
