paulrenzi/drone-detection-research/cad/gpt61/renders/dummy_ballast_detail.png

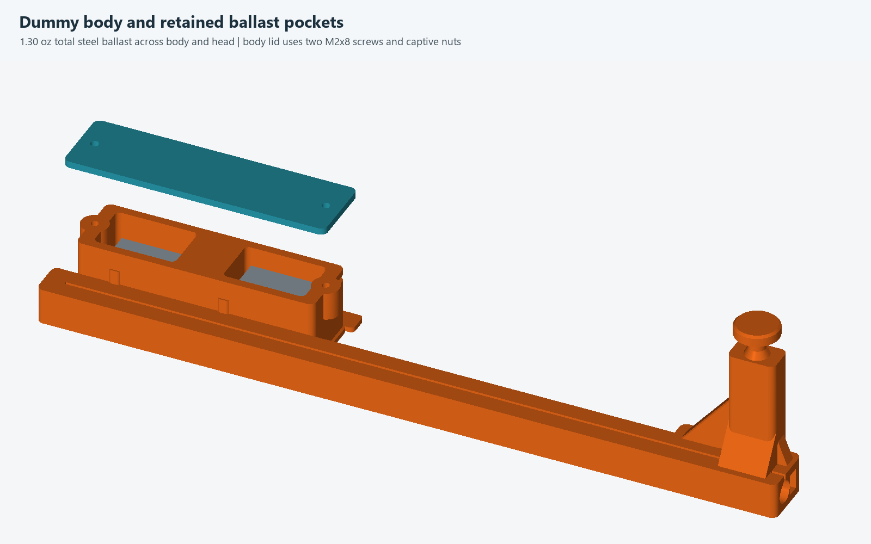
cad/gpt61/renders/dummy_ballast_detail.png
