paulrenzi/drone-detection-research/cad/gpt61/renders/harness_exploded.png

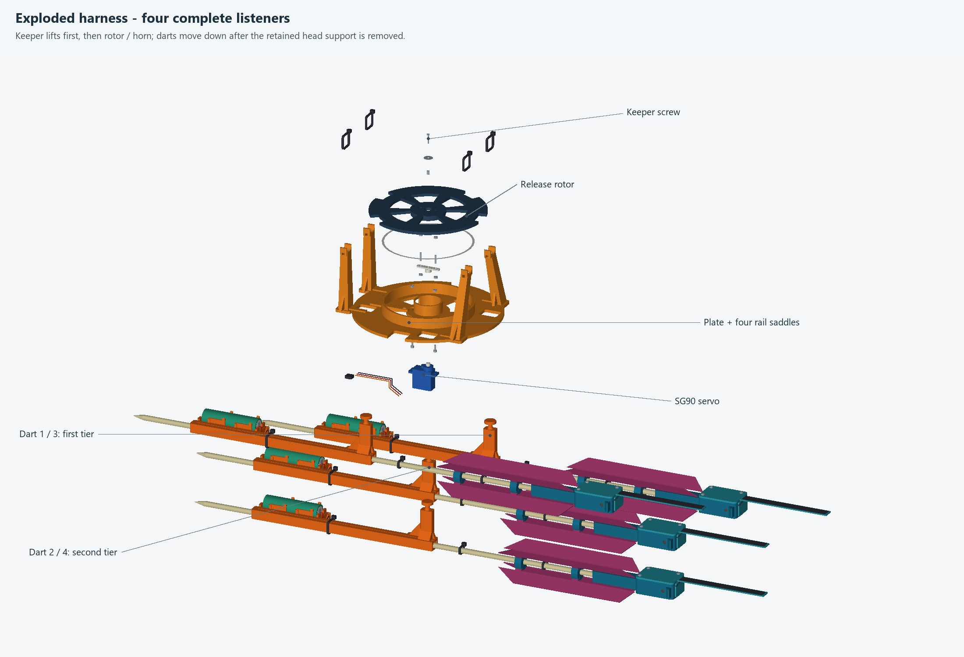
cad/gpt61/renders/harness_exploded.png
