paulrenzi/drone-detection-research/cad/gpt61/renders/harness_exploded_detail.png

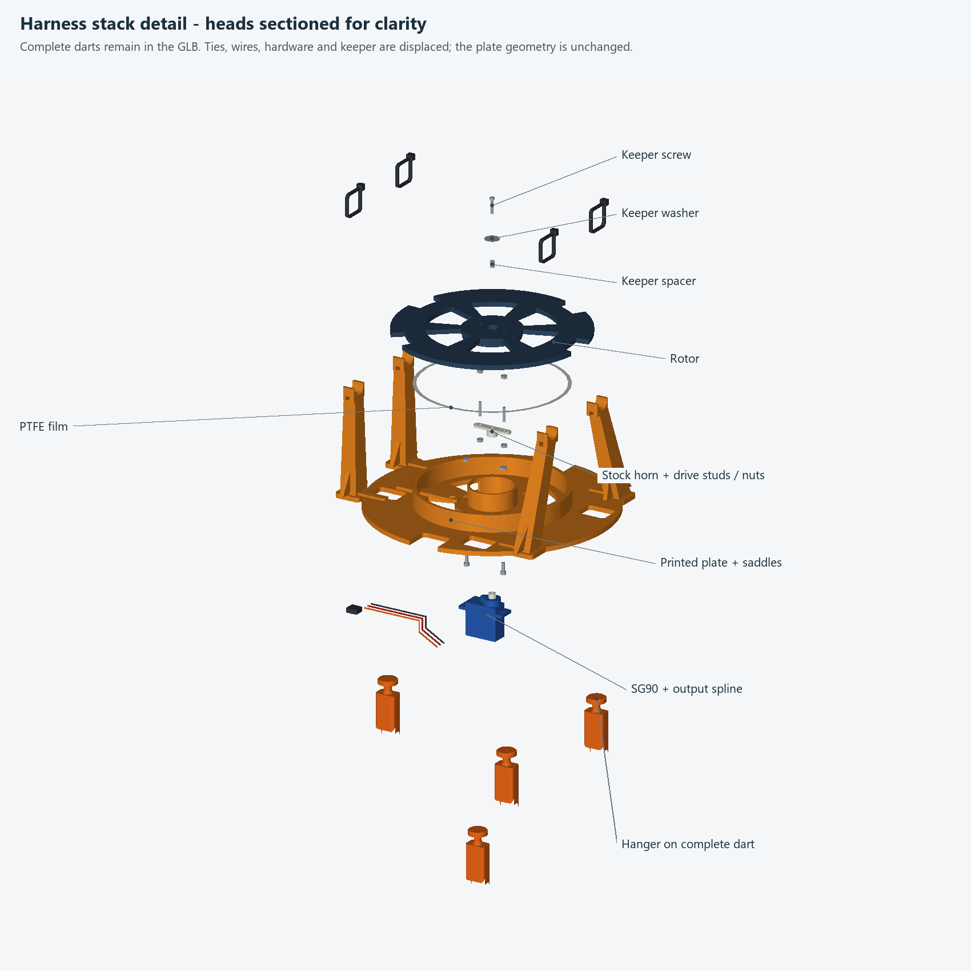
cad/gpt61/renders/harness_exploded_detail.png
