paulrenzi/drone-detection-research/cad/gpt61/renders/pod_exploded.png

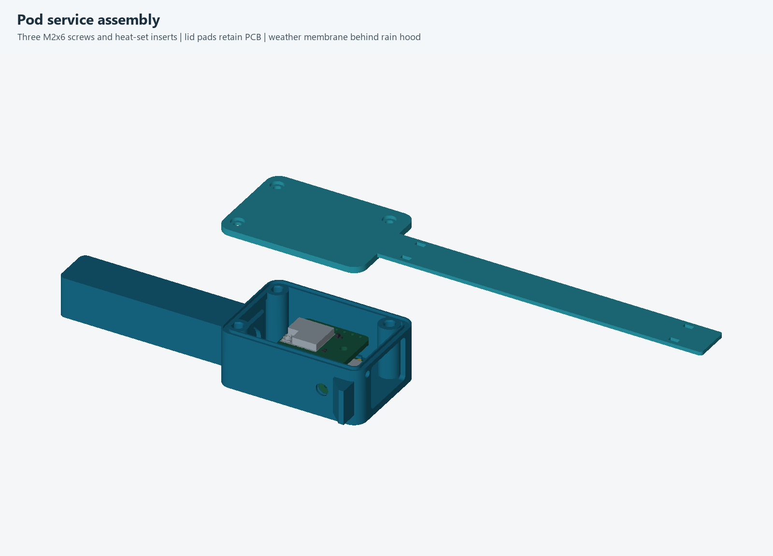
cad/gpt61/renders/pod_exploded.png
