paulrenzi/drone-detection-research/cad/gpt61/renders/pod_usb_access.png

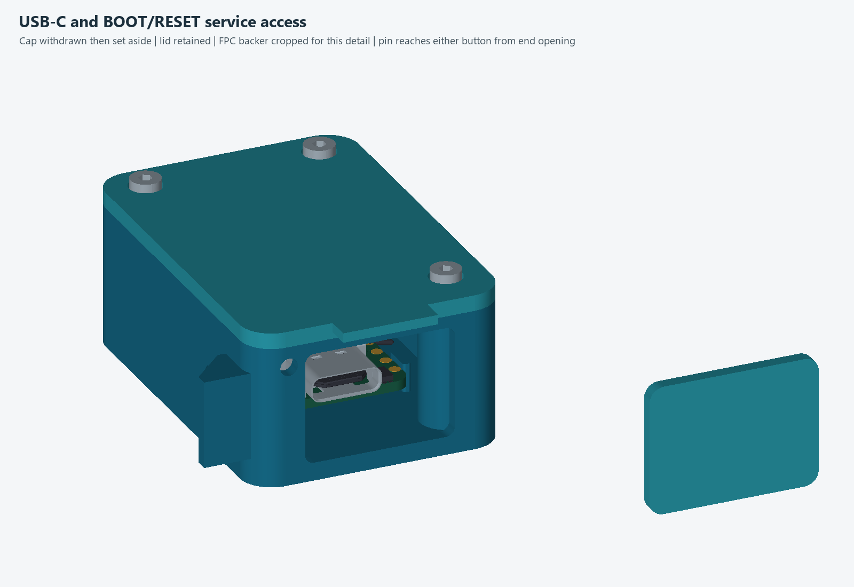
cad/gpt61/renders/pod_usb_access.png
