paulrenzi/drone-detection-research/cad/gpt61/renders/release_detail.png

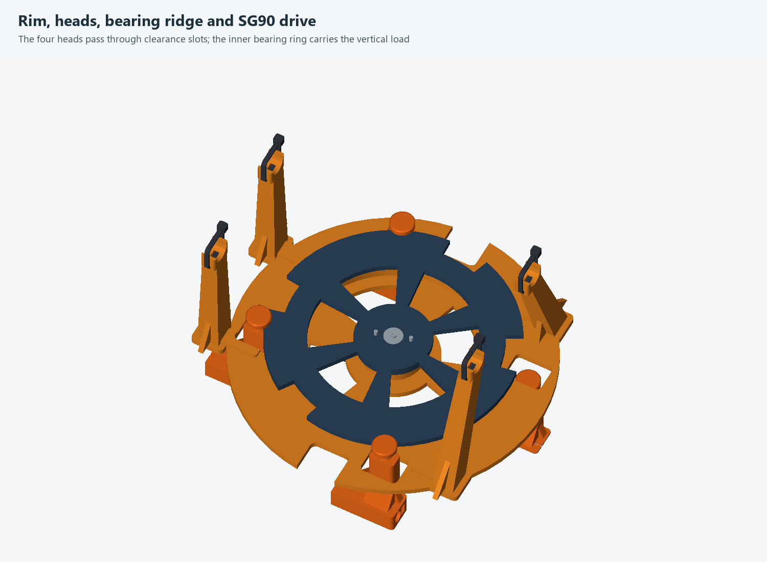
cad/gpt61/renders/release_detail.png
