paulrenzi/drone-detection-research/cad/gpt61/renders/section_body.png

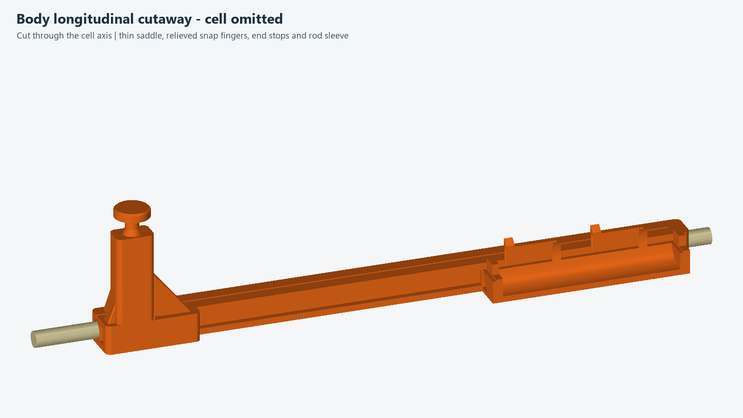
cad/gpt61/renders/section_body.png
