paulrenzi/drone-detection-research/cad/gpt61/renders/section_body_snap.png

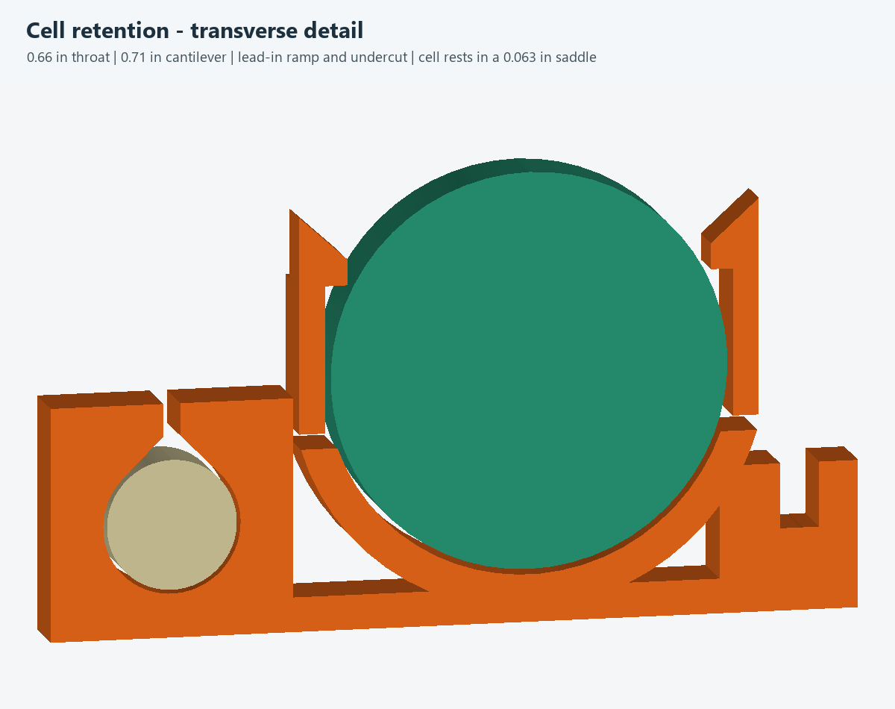
cad/gpt61/renders/section_body_snap.png
