paulrenzi/drone-detection-research/cad/gpt61/renders/section_pod.png

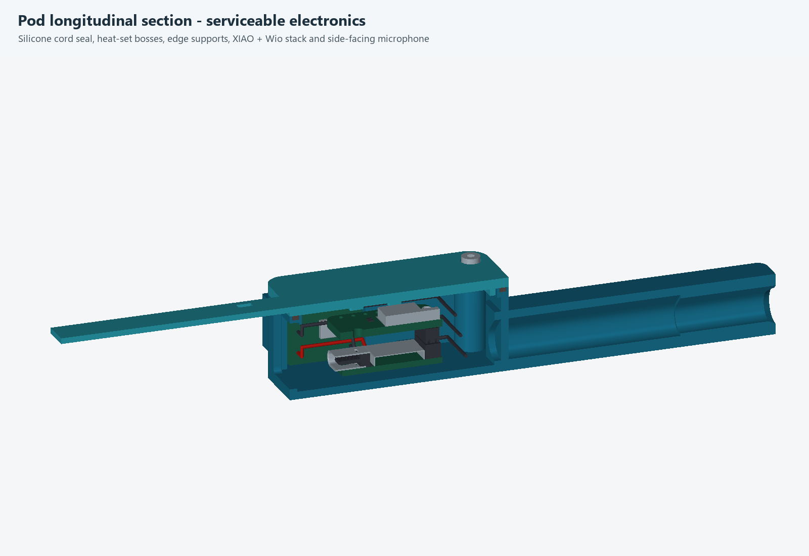
cad/gpt61/renders/section_pod.png
