paulrenzi/drone-detection-research/cad/gpt61/renders/stake_clamp_detail.png

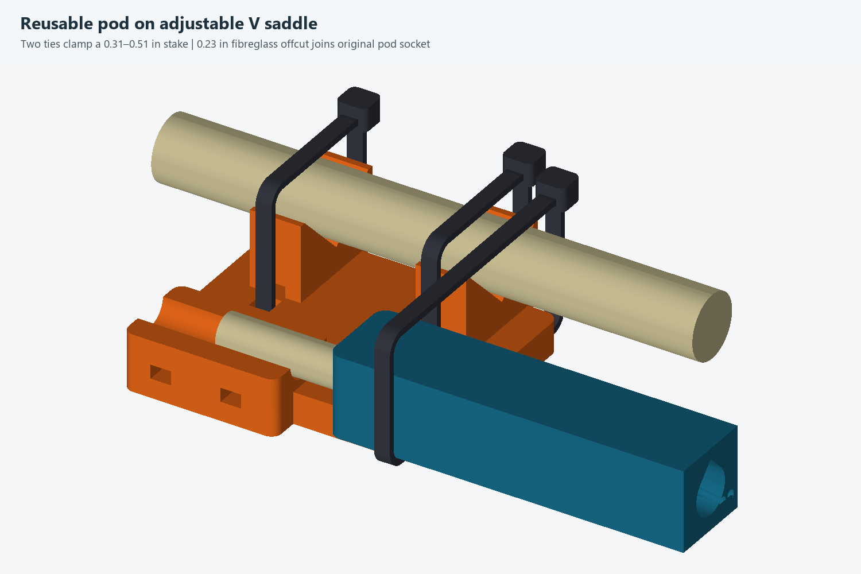
cad/gpt61/renders/stake_clamp_detail.png
