paulrenzi/drone-detection-research/costs.md

---
title: Projected costs
nav_primary: 2.2
---

# Projected costs
{: .no_toc }

<p class="vz-lede">What one unit's package costs us at three scales, what it costs to keep up, and what it sells for with our markup. <strong>The drone is about half the package; solar sets the yearly bill.</strong></p>

<div class="stats">
  <div class="stat"><p class="stat-num">$2,900</p><p class="stat-label">one unit's package, small batch (est.); $3,510 at today's prices</p></div>
  <div class="stat"><p class="stat-num">22</p><p class="stat-label">darts used per lay, 4 of them tips with fibre</p></div>
  <div class="stat"><p class="stat-num">$1.6–6.3k</p><p class="stat-label">a year to keep it up with solar: 2–4 winter re-lays (est.)</p></div>
  <div class="stat"><p class="stat-num">$6.3–7.8k</p><p class="stat-label">the package's price: darts +200–300%, the drone kit +30%</p></div>
</div>

### What's in the package

<div class="vz-bars">
  <div class="vz-bar-row"><span class="vz-bar-label">Prototype</span><span class="vz-bar-track"><span class="vz-bar vz-seg-darts" style="width:33.2%" title="$1,166"></span><span class="vz-bar vz-seg-tips" style="width:16.9%" title="$592"></span><span class="vz-bar vz-seg-box" style="width:5.1%" title="$180"></span><span class="vz-bar vz-seg-drone" style="width:44.8%" title="$1,573"></span></span><span class="vz-bar-val">$3,510</span></div>
  <div class="vz-bar-row"><span class="vz-bar-label">Small batch (est.)</span><span class="vz-bar-track"><span class="vz-bar vz-seg-darts" style="width:23.5%" title="$825"></span><span class="vz-bar vz-seg-tips" style="width:14.6%" title="$512"></span><span class="vz-bar vz-seg-box" style="width:4.8%" title="$170"></span><span class="vz-bar vz-seg-drone" style="width:39.8%" title="$1,397"></span></span><span class="vz-bar-val">$2,900</span></div>
  <div class="vz-bar-row"><span class="vz-bar-label">Production (est.)</span><span class="vz-bar-track"><span class="vz-bar vz-seg-darts" style="width:15.0%" title="$528"></span><span class="vz-bar vz-seg-tips" style="width:11.1%" title="$388"></span><span class="vz-bar vz-seg-box" style="width:3.4%" title="$120"></span><span class="vz-bar vz-seg-drone" style="width:29.2%" title="$1,024"></span></span><span class="vz-bar-val">$2,060</span></div>
  <p class="vz-bar-note vz-legend"><span class="vz-key vz-seg-drone"></span>delivery drone and kit <span class="vz-key vz-seg-darts"></span>22 darts <span class="vz-key vz-seg-tips"></span>4 tip darts <span class="vz-key vz-seg-box"></span>base box and wire</p>
</div>

### A year of upkeep, per unit

<div class="vz-bars">
  <div class="vz-bar-row"><span class="vz-bar-label">Solar, 4 winter re-lays <em>(the plan)</em></span><span class="vz-bar-track"><span class="vz-bar vz-bar-us" style="width:7.9%"></span><span class="vz-bar vz-bar-us-light" style="width:7.5%"></span></span><span class="vz-bar-val">$3.3–6.3k</span></div>
  <div class="vz-bar-row"><span class="vz-bar-label">Solar, 2 winter re-lays</span><span class="vz-bar-track"><span class="vz-bar vz-bar-them" style="width:3.9%"></span><span class="vz-bar vz-bar-them-light" style="width:3.7%"></span></span><span class="vz-bar-val">$1.6–3.2k</span></div>
  <div class="vz-bar-row"><span class="vz-bar-label">Solar and a second cell, 0–1 re-lays <em>(option)</em></span><span class="vz-bar-track"><span class="vz-bar vz-bar-them" style="width:2.1%"></span><span class="vz-bar vz-bar-them-light" style="width:2.0%"></span></span><span class="vz-bar-val">$0–1.7k</span></div>
  <div class="vz-bar-row"><span class="vz-bar-label">No solar, 4-week cells</span><span class="vz-bar-track"><span class="vz-bar vz-bar-them" style="width:25.6%"></span><span class="vz-bar vz-bar-them-light" style="width:24.4%"></span></span><span class="vz-bar-val">$10.6–20.6k</span></div>
  <div class="vz-bar-row"><span class="vz-bar-label">No solar, 2-week cells</span><span class="vz-bar-track"><span class="vz-bar vz-bar-them" style="width:51.3%"></span><span class="vz-bar vz-bar-them-light" style="width:48.7%"></span></span><span class="vz-bar-val">$21.2–41.3k</span></div>
  <p class="vz-bar-note">Darts aren't recovered: a net is re-laid when its cells run flat, about 22 darts and 7 sorties. Dark: production prices; light: up to prototype prices. Repairs between re-lays aren't included. Winter sunlight (T12) is the biggest unknown in the budget.</p>
</div>

<p class="vz-done"><span class="vz-chip vz-chip-done">checked</span> prototype prices are real listings · <span class="vz-chip vz-chip-open">est.</span> small-batch and production prices are our estimates until a supplier quotes</p>

## The details

Each section opens for the full reasoning, numbers and sources.

<button type="button" class="layer-toggle" data-layers-toggle>Open all sections</button>

<details class="layer" id="the-short-version-in-full" markdown="block">
<summary><span class="layer-title">The opening, as first written</span><span class="layer-sub">What the package covers, and which prices are checked</span></summary>

What one unit's package costs us at three scales, what it costs to keep up, and what it sells for once our markup is added. The package is everything a unit needs to lay and run the net on [How it works]({{ site.baseurl }}{% link models/line-layout.md %}), a front row of darts with two FPV fibres home: the darts, the tip darts, the base box and its wire, and the drone that lays them, outfitted as the [lay model]({{ site.baseurl }}{% link models/line-layout.md %}#laying-the-net) requires.

**Prototype prices are checked listings.** Small-batch and production prices are our estimates, marked "est.", until a supplier quotes.

</details>

<details class="layer" id="short-answer" markdown="block">
<summary><span class="layer-title">Short answer</span><span class="layer-sub">The package, fibre, the price, solar, roads and the next lever, in six bullets</span></summary>

- **One unit's package costs us about $3,510 today,** about $2,900 in a small batch and about $2,060 in production. That is 22 darts, 4 tip darts with their fibre, a base box wired to the positions, and a delivery drone with its navigation and confirm kit, 6 packs and a 2-channel charger. Every dart carries a small solar panel and a 4-mic array that takes its own bearing.
- **Fibre made it smaller.** A lay takes about 22 darts, against about 35 on radio trunks: 16 planned on real ground, plus about 6 for bad landings, short hops and broken fibres. The drone is now about half the package.
- **The price is our cost plus our markup:** +200–300% on the darts, tip darts, base box and wire, which are ours, and +30% on the off-the-shelf drone kit. The package sells for about $6,340–7,840 in a small batch, about $2,110–2,610 per position.
- **Solar makes re-lays a winter job.** A dart's panel covers its daily use from March to October, so cells run flat only in midwinter. We plan on 4 winter re-lays a year, 2 if winters are kind: about $1,600–6,300 a year per unit at our cost, against about $10,600–20,600 at four-week cells without solar. A second cell in every dart might cut winter re-lays to 0–1 ([below](#keeping-it-up)). How much a panel collects in a Ukrainian winter (T12) is now the biggest number in the budget.
- **A road costs more than a position.** Guarding 4 mi of supply road takes a package of about $6,500–7,900 and about $20–30k a year with solar, $5,000–7,300 a mile ([below](#guarding-a-road)).
- **Landing reliability (T10) is the next lever:** at 95% upright instead of 85%, each lay uses about 2 fewer darts.

</details>

<details class="layer" id="per-component" markdown="block">
<summary><span class="layer-title">Per component</span><span class="layer-sub">Every part of a dart, a tip dart, the base box and the drone, priced at three scales</span></summary>

| Component | Prototype: retail, hand-built | Small batch: ~500 darts (est.) | Production: 5,000+ darts, custom board (est.) |
|---|---|---|---|
| Processor and radio | XIAO ESP32S3 + Wio-SX1262 kit, [$15.97](https://store.rokland.com/products/seeed-studio-xiao-esp32s3-wio-sx1262-kit-for-meshtastic-lora) | $13–15, bulk kits | $8–12: one board with an ESP32-S3 ($4–10) and an SX1262 ([Hardware]({{ site.baseurl }}{% link research/hardware.md %})) |
| Microphone array: 4 analog MEMS mics on the fin tips, about 4 in apart, an ES7210 4-channel audio chip and a compass chip, so each dart takes its own bearing (est.) | ~$20: a JLCPCB-assembled audio board and 4 mic boards, about $15 (est.), and a QMC5883L compass breakout, [$4.95](https://www.digikey.co.uk/en/products/detail/canaduino/26656/21737038) | ~$6–8: ES7210 [$0.86](https://www.lcsc.com/product-image/C365743.html), mics about $0.15–0.36 each ([Goertek S15OT421, LCSC](https://datasheet.lcsc.com/lcsc/2101201914_Goertek-S15OT421-005_C2684419.pdf)), compass [$1.28](https://lcsc.com/product-detail/Hall-Sensor_QST-QMC5883L_C976032.html), plus leads to the fins and assembly | ~$3–4: the same chips at 1,000+ (ES7210 $0.43, compass $0.66, mics under $0.20), on the board |
| Tilt sensor: a 3-axis accelerometer | ~$5, a LIS3DH breakout (est.) | ~$2 | ~$1, on the board |
| 18650 cell | $4.99 ([Samsung 25R](https://www.18650batterystore.com/products/samsung-25r-18650)) | $3–4 | $2.50–3.50: EVE cells at $2.50, when in stock |
| Rod, printed body and fins | $2.60: rod $1.10 ([10-pack, $11](https://www.amazon.com/dp/B0FNZQLH1P)) plus about $1.50 of PETG, wire and screws | $2 | $1–1.50, moulded |
| Windscreen, foam | $0.50 ([10-pack, $4.99](https://www.amazon.com/dp/B07X4VKKQ7)) | $0.50 | $0.30–0.50 |
| Solar: a 2.4 × 2.4 in epoxy panel facing up on the pod, and a charger chip that stops charging below 32°F (est.) | ~$4: panel about $1.30–3.30 ([Kunkune, £1–2.55](https://kunkune.co.uk/shop/uncategorized/small-solar-epoxy-panel-polycrystalline-solar-panel)), charger chip about $0.50 | ~$3 | ~$2 |
| Assembly and test | not counted: our time | $5: 15 minutes at $20 an hour | $2–3 |
| **Dart** (every dart now has the mic array, a tilt sensor and a solar panel, so any dart can stand in anywhere) | **~$53** | **~$35–40** | **~$20–28** |
| Tip dart's extra: about 1.2 mi of FPV fibre on a spool, a small laser and its driver (est.) | ~$95: fibre about $65–95 at $55–80 a mile, spool, laser and driver ~$10 | ~$90 | ~$75 |
| **Tip dart** (a dart plus the above, about 10 oz) | **~$148** | **~$128** | **~$97** |
| *Option, not in the totals:* a second 18650 cell and holder in every dart, for the winter (est.) | ~$5.50 | ~$4 | ~$3 |
| **Base box** (a dart's board receiving only, two light detectors, box and two fibre connectors, est.) | ~$70 | ~$60 | ~$40 |
| **Wire to the positions** (about 2,300 ft of twisted pair, a serial line chip at each end, a USB adapter for each phone or tablet, est.) | ~$110 | ~$110 | ~$80 |
| Delivery drone: X500 V2 with Pixhawk 6X, GPS and telemetry radio | [$946](https://pyrodrone.com/products/holybro-x500-v2-pixhawk-development-kit-with-the-pixhawk-6x-standard-m10-gps-915mhz-telemetry-radio) | ~$850, a dealer discount | ~$550: a smaller printed ArduPilot quad with the same electronics ($400–700) |
| Harness for 4 darts: printed plate and rotor, one release servo | ~$5 ([servo 2-pack, $4.99](https://www.amazon.com/dp/B0DFKPVRC2), plus filament) | ~$5 | ~$5 |
| Optical flow and 39 ft lidar in one sensor: terrain following, release height, navigation with GPS jammed | [MicoAir MTF-01P, $41.99](https://pyrodrone.com/collections/all-products/products/micoair-mtf-01p-optical-flow-12m-range-2in1-sensor) | ~$40 | ~$35 |
| Confirm radio: a receive-only dart board on a Pixhawk serial port | ~$20: the dart kit plus an antenna | ~$22 | ~$14 |
| Flight packs, 4S 5,000 mAh, six | ~$420 (~$70 each, est.) | ~$360 | ~$300 |
| Chargers: two channels | ~$120: two [ISDT 608AC at $59.99](https://www.buddyrc.com/products/isdt-608ac-ac-battgo-smart-battery-charger) | ~$100 | ~$100 |
| Insulated pack bag | ~$20 (est.) | ~$20 | ~$20 |

**Fibre is now the tip's biggest cost,** and its price is rising. Bare bend-insensitive single-mode fibre (G.657.A2), the kind FPV spools use, was quoted at $33–35 a km in March 2026, about $53–56 a mile. Ready-wound 50 km spools went from about $300 to about $2,500 over the year, about $80 a mile, as AI data centres took the same fibre ([DroneXL](https://dronexl.co/2026/05/11/ukraine-fiber-optic-spool-price-ai-data-center-demand/)). Retail 10 km FPV spools are listed at about €200 ([Elfcams](https://www.elfcams.com/us/product/29204)), about $37 a mile. We plan on $55–80 a mile. **The laser is cheap:** the 1310 nm laser in fibre-to-the-home modems comes already joined to a lead of the same fibre, and is listed at $5–9, buy-one minimum ([GoldSupplier](https://www.goldsupplier.com/provide/p100619675.html), one listing, unconfirmed).

The small batch costs about the same per dart as the prototype because it pays for assembly. Bulk pricing saves about what the labour adds. The phone or tablet that shows the alarm is the unit's own Android phone, so it is not in the package. The tip dart, the base box and the wire are a design, not yet built ([the fibres and the base box]({{ site.baseurl }}{% link models/line-layout.md %}#the-fibres-and-the-base-box)); their prices are estimates in every column.

</details>

<details class="layer" id="one-units-package" markdown="block">
<summary><span class="layer-title">One unit's package</span><span class="layer-sub">Darts planned and used, the package at three scales, and what solar and fibre changed</span></summary>

The lay model plans **16 darts** on its example sector, all in the front row, 2 of them tips. That is 1 more than open ground needs, because a hop that crosses a windbreak is shorter. Laying them takes **about 22 darts, and 26 in 9 lays out of 10**, because the drone confirms every link and re-drops darts that land badly or out of reach, and a tip whose fibre breaks is laid again. The package carries 22 darts and 4 tip darts.

| Part of the package | Prototype | Small batch (est.) | Production (est.) |
|---|---|---|---|
| 22 darts | $1,166 | $825 | $528 |
| 4 tip darts | $592 | $512 | $388 |
| Base box and the wire to the positions | $180 | $170 | $120 |
| Delivery drone, harness, navigation and confirm kit, 6 packs, 2 chargers, pack bag | $1,573 | $1,397 | $1,024 |
| **Package: our total cost** | **~$3,510** | **~$2,900** | **~$2,060** |

Darts are costed at the middle of each range. **What the lay model added to the drone:** the flow-and-lidar sensor ($42), the confirm radio ($20), 4 more packs and a second charger ($340) and a pack bag ($20), about $420 in all. A unit that already flies an ArduPilot quad can take the package without the drone and its packs: darts, tip darts, base box and wire, harness, flow sensor and confirm radio, about $1,570 in a small batch.

**What solar and the fibre price changed:** solar adds about $3 a dart in a small batch, and the fibre's rise adds about $28 a tip dart. Together they put about $180 on the package, and they cut the yearly bill by two-thirds ([below](#keeping-it-up)).

**What the mic array changed:** four mics, an audio chip and a compass in place of one mic add about $5.50 a dart in a small batch and about $2 in production, about $145 on a small-batch package. At prototype prices it is about $18 a dart, because the audio board is ordered a few at a time. The three extra mics wake only when the first hears a drone, so the daily power budget is unchanged (est.).

**What fibre changed:** the last plan, radio trunks, carried 40 darts and 3 receivers for about $2,620 in a small batch, and still needed about $60–100 of forward roots on fibre to survive the unit's own jammers. Fibre to the front row drops 12 relay darts and the receivers, adds 4 tip darts, a base box and a wire, and needs nothing more for our own jammers.

</details>

<details class="layer" id="keeping-it-up" markdown="block">
<summary><span class="layer-title">Keeping it up</span><span class="layer-sub">Re-lays, solar through a Donetsk winter, repairs, and what T10 and T12 decide</span></summary>

Darts aren't recovered. Every net is re-laid when its cells run down, and darts lost to shelling are replaced. **A re-lay is about 22 darts and 7 sorties:** about 20 darts and 2.6 tip darts on average. The drone comes home, except about 0.15 times a lay, at the model's guess of 2% lost per sortie. The base box and the wire stay.

**Solar sets how often.** A dart listens all the time to relay its neighbours, about 105 mAh a day. A 2.4 in panel lying flat on its pod collects about that much in November and more from March to October, but only about half of it in December and two-thirds in January (PVGIS sunlight records for Donetsk oblast, 2015–2020, est.). Over November to January a dart falls about 3,200 mAh short, more than its cell holds, so the net still goes flat in midwinter. Snow, shade in tree belts and frost, when the charger must not charge, make it worse.

| Power | Re-lays a year | Our cost at prototype (~$1,590 a re-lay) | Our cost in production (~$810 a re-lay, est.) |
|---|---|---|---|
| **Solar, 4 winter re-lays (the plan)** | 4 | **~$6,350** | **~$3,260** |
| Solar, 2 winter re-lays | 2 | ~$3,170 | ~$1,630 |
| Solar and a second cell in every dart (option) | 0–1 | ~$0–1,710 | ~$0–880 |
| No solar, 4-week cells | 13 | ~$20,600 | ~$10,600 |
| No solar, 2-week cells | 26 | ~$41,300 | ~$21,200 |

A re-lay's cost is about 22 darts, plus 0.15 of a drone (about $140 at prototype prices, $80 in production), plus about $2 of pack wear. **Repairs between re-lays** cost one dart each, about $35–40, or one tip dart, about $128, plus about $0.30 of pack wear a sortie; up to 4 darts go on one sortie ([When it breaks]({{ site.baseurl }}{% link models/line-layout.md %}#when-it-breaks)). With solar, losses to shelling are a bigger share of the bill than before.

**A second cell could end winter re-lays (an option, not in the package).** Over November to January a dart falls about 3,200 mAh short, and one 18650 holds about 2,500. A second cell and holder, about $3–5.50 a dart and 1.6 oz, doubles that to about 5,000 mAh, or about 3,500–4,000 mAh if the cells keep 70–80% of their capacity in the cold (est.). That just covers the shortfall on paper, so the net might need 0–1 winter re-lays, and the yearly bill becomes mostly darts lost to shelling, which this table doesn't price for a position. It adds about $80–145 to a package. Not yet checked: the heavier dart (4.5 oz to about 6.1 oz) in the lay model, its fit in the 3D model, and whether the margin holds through a real winter.

None of this is measured. T12 now has two halves: how long a cell lasts, and how much a panel collects through a winter, with the cold-charging cutoff. It is the biggest number in the whole budget. **T10 is next:** each dart that lands upright instead of tilted saves one re-drop, and at 95% upright a lay uses about 20 darts instead of 22, about $300 a year at small-batch prices and 4 re-lays.

</details>

<details class="layer" id="guarding-a-road" markdown="block">
<summary><span class="layer-title">Guarding a road</span><span class="layer-sub">A road's package and a year's bill, posts alone or with the fence</span></summary>

From the [route model]({{ site.baseurl }}{% link models/route-guard.md %}), run on two invented 4 mi roads. Small-batch costs to us (est.). A **post** is about $49 and keeps a single mic, since it only has to hear a landing close by: the dart's board, 4 cells, a 2 ft whip, a stake and a 1 W solar panel tilted toward the sun. The drone is the position package's, with 6 more packs and 2 more charger channels so a fence goes in in a day. The fence comes home on FPV fibre: every 2 mi a **tip dart** (about $122) sends its alerts down a fibre to a post, which carries a **fibre end** (a light detector, connector and box, about $20, est.).

| | Road along the front | Road toward the front |
|---|---|---|
| **Package:** 25 posts, 50 or 80 air-dropped darts, 9 or 11 tip darts, 5 or 7 fibre ends, 14 receivers (12 vehicles, 2 checkpoints), the outfitted drone with 12 packs and 4 charger channels | **~$6,520** | **~$7,940** |
| Cable and a hooded lamp on every post (proposed, [why]({{ site.baseurl }}{% link models/route-guard.md %}#jamming-and-a-wire-along-the-road)) | ~$800 | ~$800 |
| One re-lay of the fence: about 46 or 76 darts (6 or 9 of them tip darts), 0.3–0.6 of a lost drone, pack wear | ~$2,550 | ~$4,140 |
| **A year with solar, 4 winter re-lays:** no post cell swaps, repairs between re-lays and cut fibres | **~$20,100** | **~$29,600** |
| A year with solar, 2 winter re-lays | ~$15,000 | ~$21,300 |
| A year without solar, four-week cells: 13 re-lays, post cells every 16 weeks | ~$46,400 | ~$70,200 |
| **A mile a year with solar, 4 winter re-lays** | **~$5,000** | **~$7,300** |
| Package at our markup: +200–300% on ours, +30% on the drone kit | ~$16,400–21,100 | ~$20,700–26,700 |

- **Solar cut the bill by more than half.** Re-lays fall from 13 a year to 2–4, and posts stop needing cell swaps: a post's tilted 1 W panel collects about twice its daily use even in December, and its 4 cells hold about 100 days in reserve (est.).
- **Repairs are now half the bill,** about $9,900–13,100 a year: darts and posts lost to shelling, and cut fibres. Battery life no longer dominates; losses do, and those guesses (0.5% of darts and 1% of posts a day) are now the numbers to check.
- **The fence is 81–87% of the bill.** Lost posts are the rest.
- **Fibre made it cheaper.** Each fibre replaces about 5 relay darts. Its price rose in 2026, but at $55–80 a mile it is still the cheaper trunk.
- **Cut fibres are a running cost:** at a guessed 1% of days each, about 18–26 new tip darts a year, about $2,600–3,800.
- **The drone is the hidden cost again:** at 2% lost per sortie, a re-lay loses about $270–500 of drone.
- **Posts only,** with no fence: about $1,530 for 25 posts and 14 receivers, and about $3,800 a year, all of it posts lost (about $940 a mile). It hears drones land by the road but gives only 4–9 s of warning of a strike.
- **Zvook's NW0** is pitched for roads at 1,300–2,000 ft spacing, which is about 11–17 sensors on 4 mi, about $9–16k before power, with no fence ([competitors]({{ site.baseurl }}{% link research/competitors.md %})).

</details>

<details class="layer" id="pricing-our-cost-plus-markup" markdown="block">
<summary><span class="layer-title">Pricing: our cost plus markup</span><span class="layer-sub">Darts at +200–300%, the drone kit at +30%: the package, a re-lay pack and a first year</span></summary>

**Two markups.** The darts, tip darts, base box and wire are ours, and nothing cheap on sale does what they do, so they carry **+200–300%**: two-thirds to three-quarters of their price is margin. The drone kit is an off-the-shelf X500 with its packs and chargers, which a buyer can price-check at $946, so it carries **+30%**.

| What a unit buys | Our cost, small batch | Price at +200% | Price at +300% |
|---|---|---|---|
| **Package:** 22 darts, 4 tip darts, base box and wire, outfitted drone | ~$2,900 | **~$6,340** | **~$7,840** |
| Per position, 3 to a package | ~$970 | ~$2,110 | ~$2,610 |
| Package without the drone and packs | ~$1,570 | ~$4,610 | ~$6,120 |
| **Re-lay pack:** 20 darts and 3 tip darts | ~$1,130 | **~$3,400** | **~$4,540** |
| One dart / one tip dart | ~$35–40 / ~$128 | ~$105–120 / ~$384 | ~$140–160 / ~$512 |

| What a unit buys | Our cost, production | Price at +200% | Price at +300% |
|---|---|---|---|
| **Package** | ~$2,060 | **~$4,440** | **~$5,480** |
| Package without the drone and packs | ~$1,090 | ~$3,180 | ~$4,210 |
| **Re-lay pack:** 20 darts and 3 tip darts | ~$770 | **~$2,310** | **~$3,080** |

**What the market charges, for comparison** (all from [the competitor analysis]({{ site.baseurl }}{% link research/competitors.md %})):

- **DroneAlert:** about $211 per LoRa acoustic module (seller's claims, out of stock).
- **Chuyka 3.0 radio detector:** $584 for defence buyers, $701 with VAT. Its maker calls it the most-requested item units buy with e-points.
- **Zvook NW0:** about $834–950 per sensor, plus 15–18 W of power.

At these markups the package is about $2,110–2,610 per position, two to three NW0s, for about a minute of warning instead of seconds. A dart at $105–160 still sells for less than one DroneAlert module. We have no figures for what any competitor's parts cost, so their margins are unknown.

**A unit's first year** with solar is the package plus 3 winter re-lays, with about half a replacement drone in them: about **$17,100 at +200% and $22,000 at +300%** (small batch). If winters need only 2 re-lays (the package plus 1), about $9,900–12,500. With a second cell in every dart, if it ends winter re-lays, about $6,650–8,260 plus repairs; with one re-lay, about $10,500–13,300. Without solar, at four-week cells, about $49,000–64,000. **At these markups re-lays are most of what a unit pays**, so the second cell and T12 matter more to a buyer than they did at 50%. Quote the range, as [the competitor analysis]({{ site.baseurl }}{% link research/competitors.md %}#how-to-position) recommends.

**Sell like Chuyka:** a defence price without VAT with an end-user certificate, a Brave1 Market listing, then e-point eligibility.

Every cost here except the prototype column is an estimate, and every yearly figure rests on an unmeasured battery life and winter solar harvest, an assumed landing rate, and guessed loss rates for darts, posts, fibres and drones.

</details>
