paulrenzi/drone-detection-research/cad/gpt61/out/dummy_assembled.step

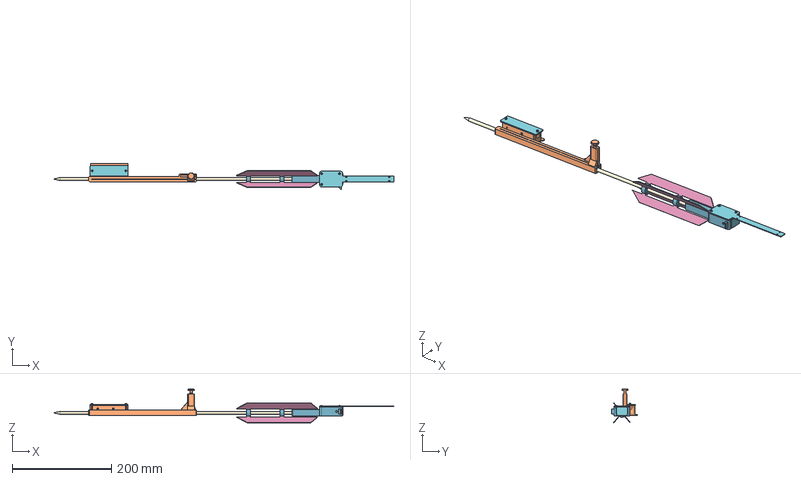
[picture p29: CAD file, 2026-10-21]
cad/gpt61/out/dummy_assembled.step
686.0 x 53.1 x 68.3 mm
dummy_body
dummy_lid
dummy_head_insert
rod
pod_shell
pod_lid
usb_cap
tail_fin_1
tail_fin_2
tail_fin_3
tail_fin_4
tail_collar_1
tail_collar_2
tail_bond
pod_insert_0
pod_M2x6_0
pod_insert_1
pod_M2x6_1
pod_insert_2
pod_M2x6_2
perimeter_silicone_seal
dummy_nut_77
dummy_M2x8_77
dummy_nut_145
dummy_M2x8_145
ballast_body_front
ballast_body_rear
ballast_head_front
ballast_head_rear
