paulrenzi/drone-detection-research/cad/gpt61/out/plate.step

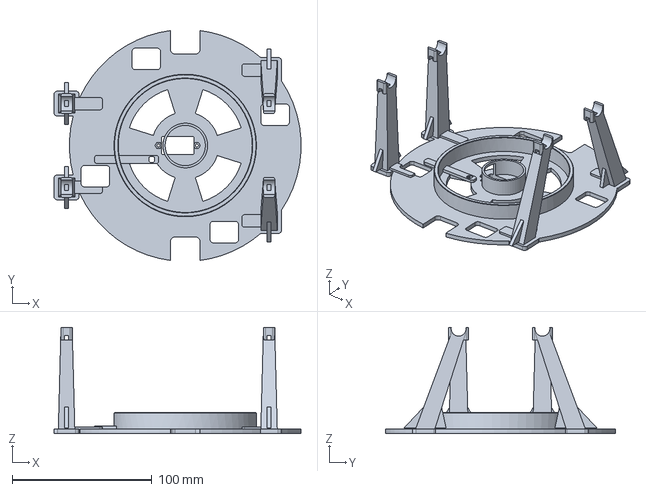
[picture p30: CAD file, 2026-10-21]
cad/gpt61/out/plate.step
176.9 x 164.7 x 76.2 mm
