paulrenzi/drone-detection-research/cad/out/v3_dart_body.step

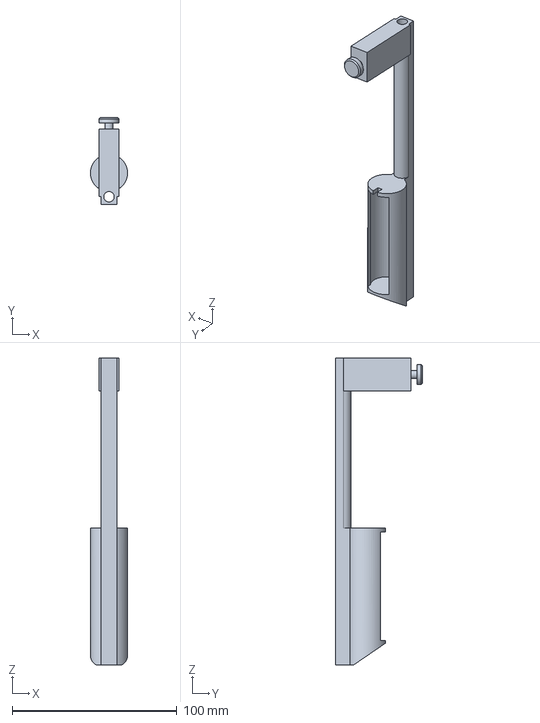
[picture p31: CAD file, 2026-10-16]
cad/out/v3_dart_body.step
22.6 x 52.9 x 186.4 mm
