paulrenzi/drone-detection-research/cad/gpt61/out/dummy_lid.step

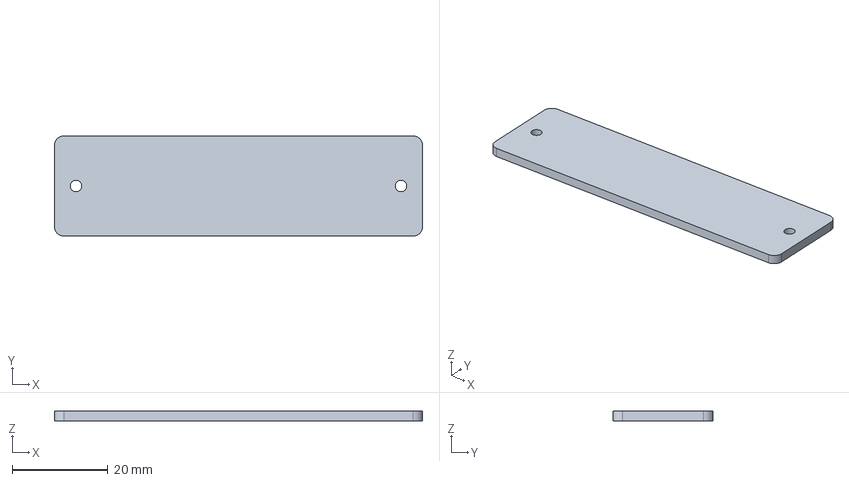
[picture p32: CAD file, 2026-10-21]
cad/gpt61/out/dummy_lid.step
77.0 x 21.0 x 2.00 mm
