paulrenzi/drone-detection-research/cad/out/v3_dart_pod.step

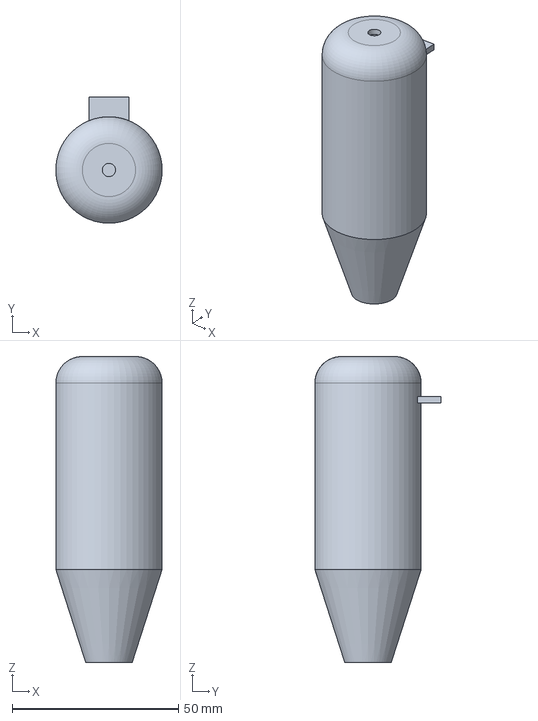
[picture p33: CAD file, 2026-10-16]
cad/out/v3_dart_pod.step
32.0 x 38.0 x 92.0 mm
