paulrenzi/drone-detection-research/cad/gpt61/out/usb_cap.step

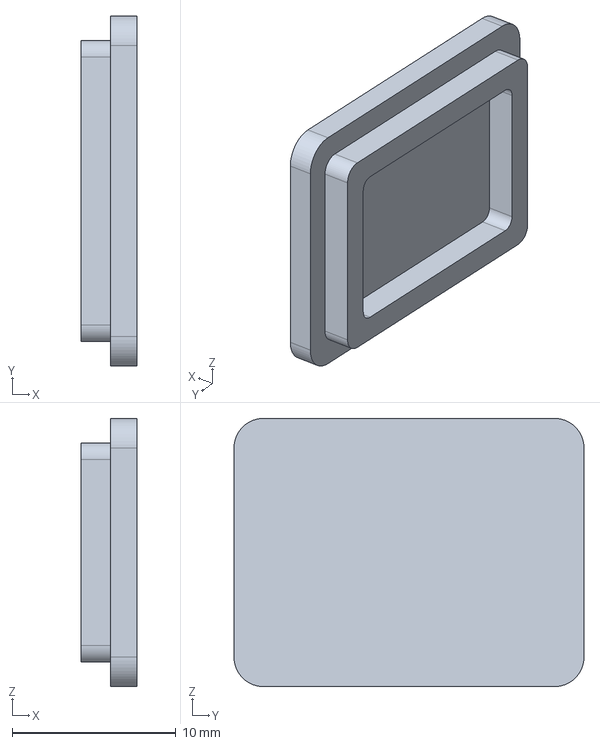
[picture p34: CAD file, 2026-10-21]
cad/gpt61/out/usb_cap.step
3.40 x 21.4 x 16.4 mm
