paulrenzi/drone-detection-research/cad/out/v2_dart_clip.step

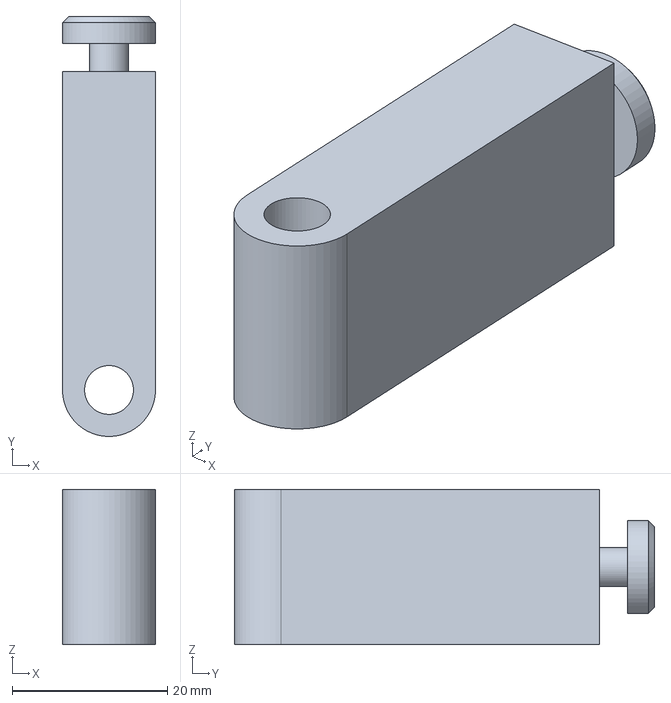
[picture p35: CAD file, 2026-10-16]
cad/out/v2_dart_clip.step
12.0 x 54.1 x 20.0 mm
