paulrenzi/drone-detection-research/cad/gpt61/out/bought_rod.step

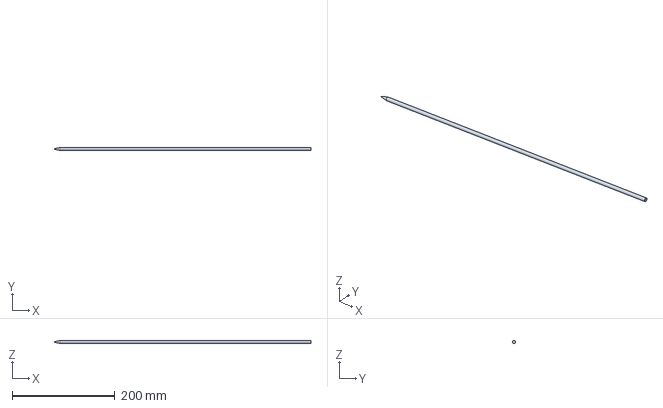
[picture p36: CAD file, 2026-10-21]
cad/gpt61/out/bought_rod.step
500.0 x 6.00 x 5.99 mm
