paulrenzi/drone-detection-research/cad/gpt61/out/bought_SG90.step

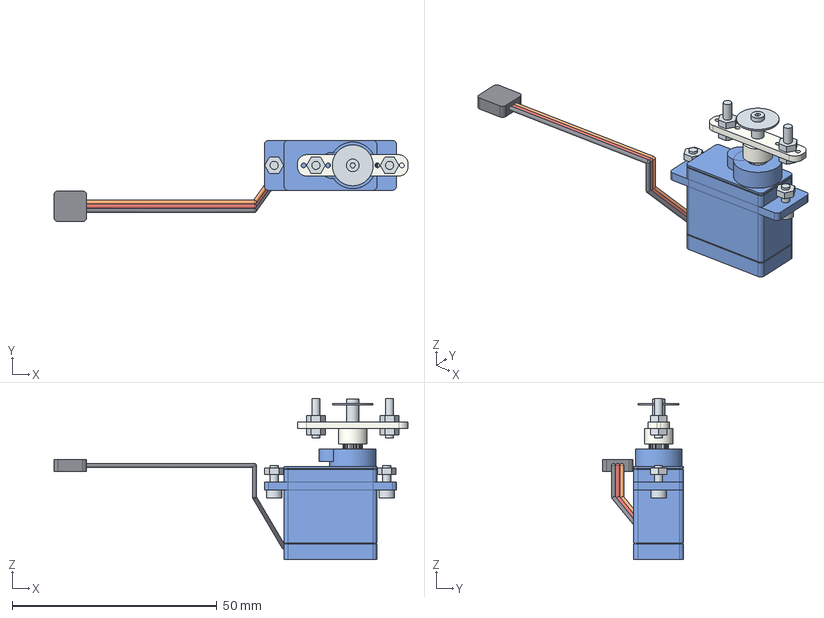
[picture p37: CAD file, 2026-10-21]
cad/gpt61/out/bought_SG90.step
86.5 x 19.9 x 39.4 mm
SG90_case_tabs
SG90_output_spline
SG90_stock_double_horn
SG90_spline_screw
rotor_keeper_spacer
rotor_keeper_washer
drive_pin_-9.0
drive_pin_lower_nut_-9.0
drive_pin_upper_nut_-9.0
drive_pin_9.0
drive_pin_lower_nut_9.0
drive_pin_upper_nut_9.0
servo_mount_nut_-1
servo_M2x6_-1
servo_mount_nut_1
servo_M2x6_1
servo_lead_0
servo_lead_1
servo_lead_2
servo_JR_plug
