paulrenzi/drone-detection-research/cad/out/v2_plate.step

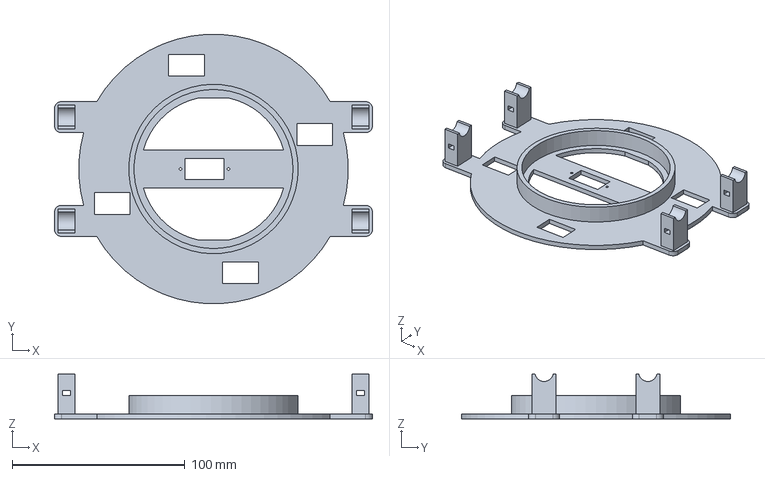
[picture p38: CAD file, 2026-10-16]
cad/out/v2_plate.step
184.0 x 155.8 x 26.0 mm
