paulrenzi/drone-detection-research/cad/gpt61/out/pod_shell.step

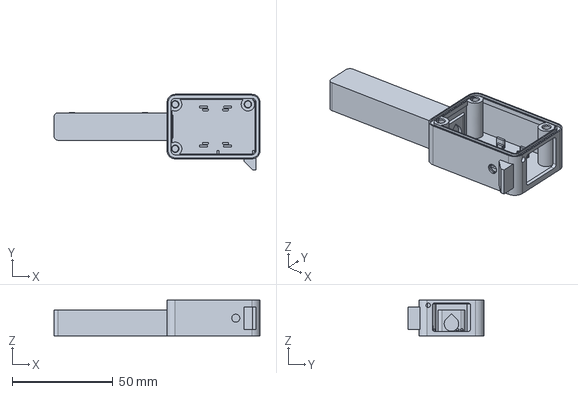
[picture p39: CAD file, 2026-10-21]
cad/gpt61/out/pod_shell.step
102.0 x 37.4 x 17.8 mm
