paulrenzi/drone-detection-research/cad/gpt61/out/bought_inmp441.step

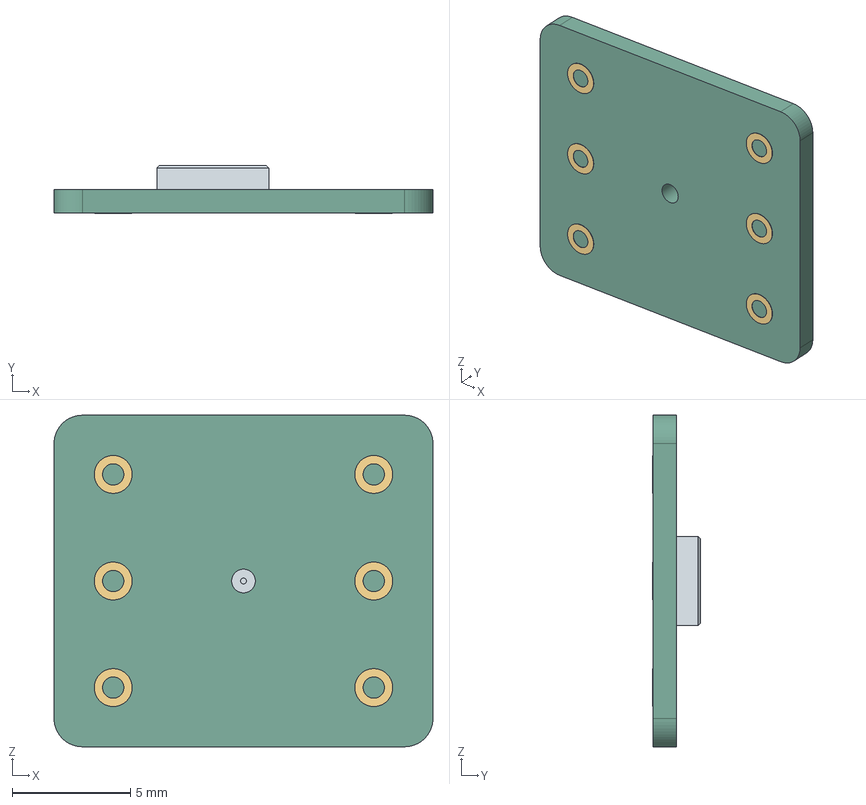
[picture p40: CAD file, 2026-10-21]
cad/gpt61/out/bought_inmp441.step
16.0 x 2.02 x 14.0 mm
mic_pcb
INMP441_can
mic_pad_-5.5_-4.5
mic_pad_-5.5_0
mic_pad_-5.5_4.5
mic_pad_5.5_-4.5
mic_pad_5.5_0
mic_pad_5.5_4.5
