paulrenzi/drone-detection-research/cad/out/v2_rotor.step

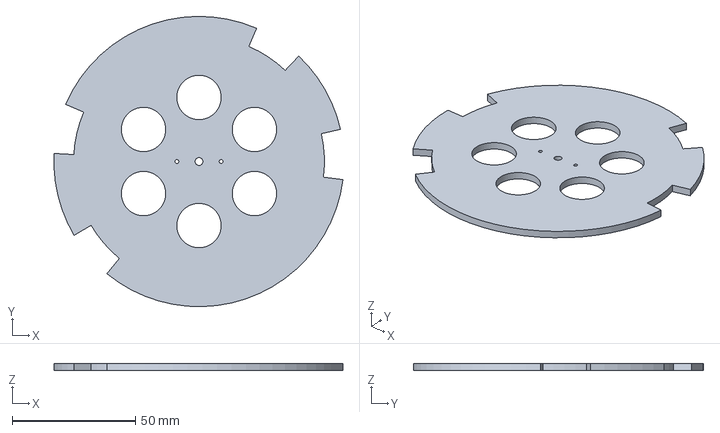
[picture p41: CAD file, 2026-10-16]
cad/out/v2_rotor.step
117.3 x 117.8 x 3.00 mm
