paulrenzi/drone-detection-research/cad/gpt61/out/body.step

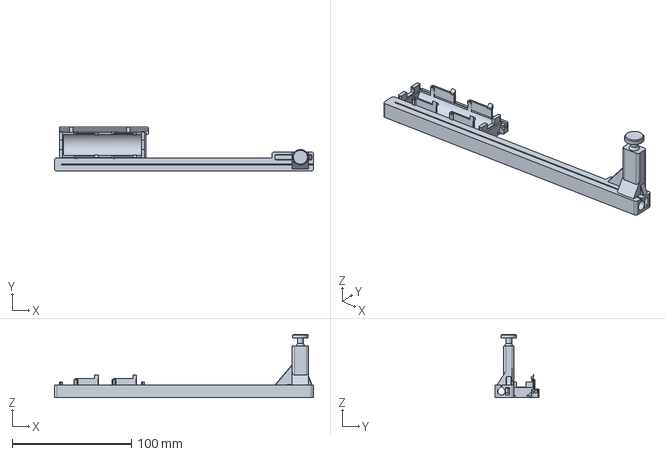
[picture p42: CAD file, 2026-10-21]
cad/gpt61/out/body.step
217.6 x 37.3 x 53.2 mm
