paulrenzi/drone-detection-research/cad/out/harness_simple_plate.step

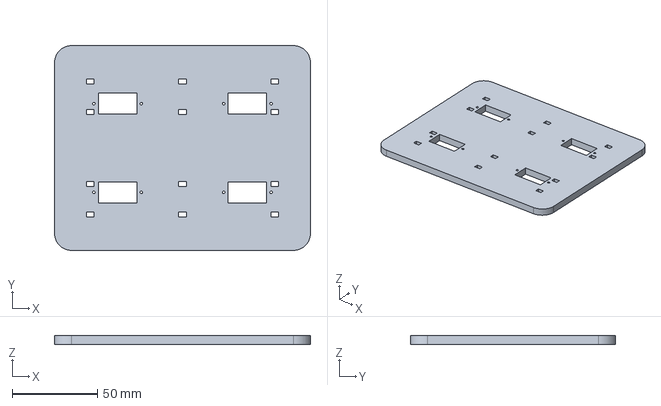
[picture p43: CAD file, 2026-10-16]
cad/out/harness_simple_plate.step
150.0 x 120.0 x 5.00 mm
