paulrenzi/drone-detection-research/cad/out/dart_cap.step

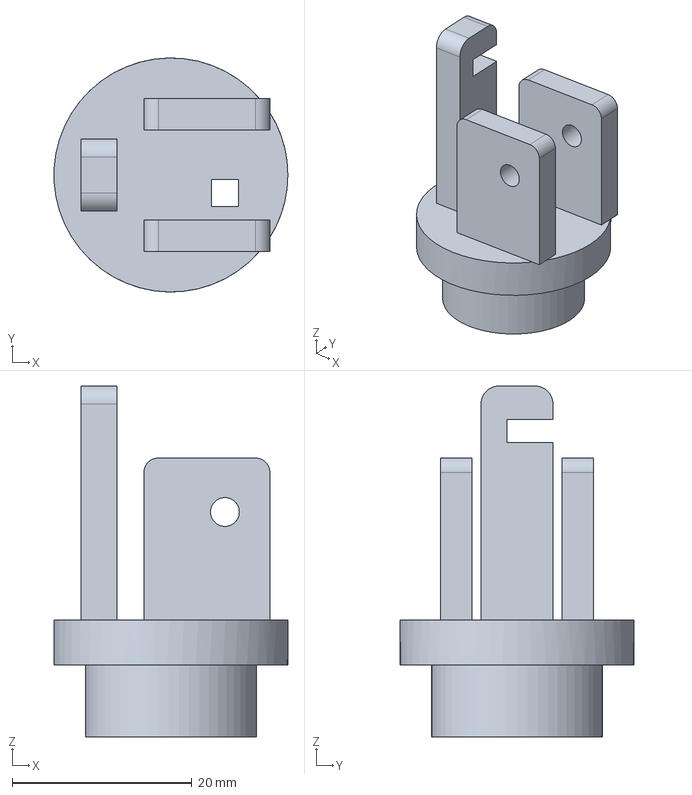
[picture p44: CAD file, 2026-10-16]
cad/out/dart_cap.step
26.0 x 26.0 x 39.0 mm
