paulrenzi/drone-detection-research/cad/gpt61/out/pod_lid.step

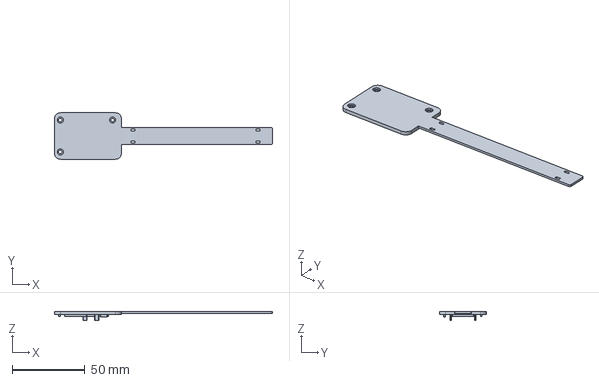
[picture p45: CAD file, 2026-10-21]
cad/gpt61/out/pod_lid.step
150.0 x 32.0 x 5.90 mm
