paulrenzi/drone-detection-research/cad/out/harness_plate.step

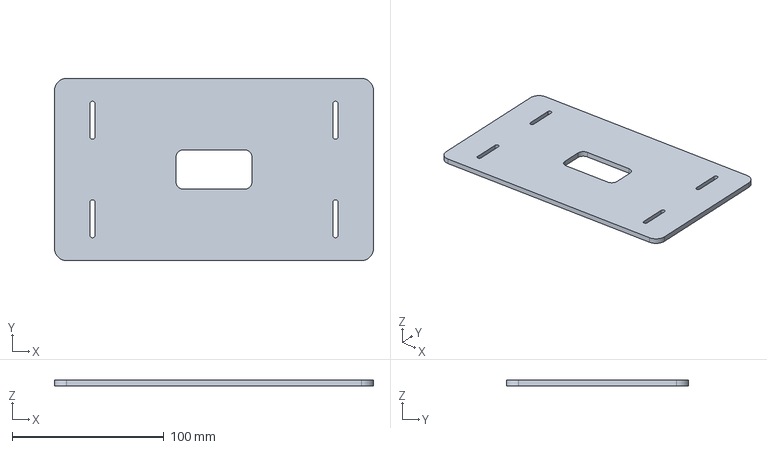
[picture p46: CAD file, 2026-10-15]
cad/out/harness_plate.step
210.0 x 120.0 x 4.00 mm
