paulrenzi/drone-detection-research/cad/gpt61/out/tail_collar.step

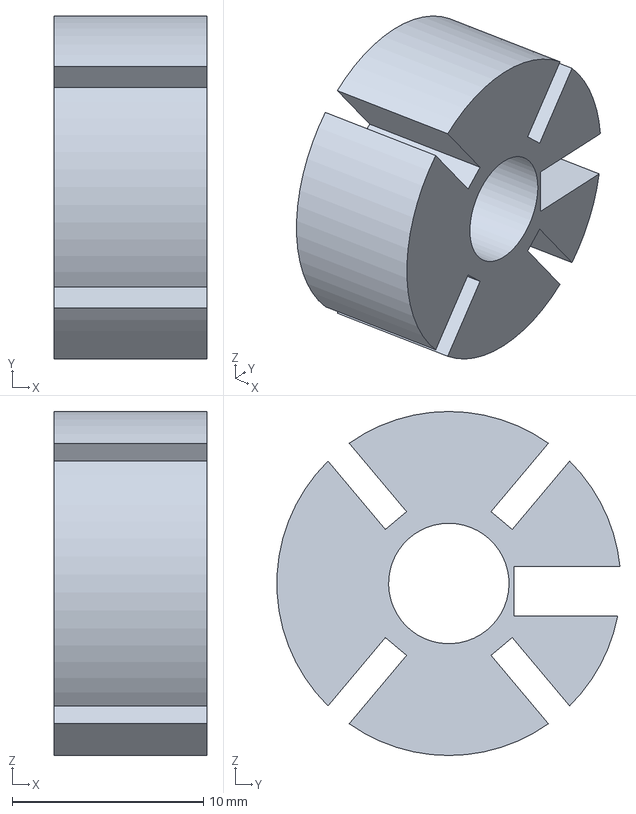
[picture p47: CAD file, 2026-10-21]
cad/gpt61/out/tail_collar.step
8.00 x 17.9 x 18.0 mm
