paulrenzi/drone-detection-research/cad/out/dart_hinge.step

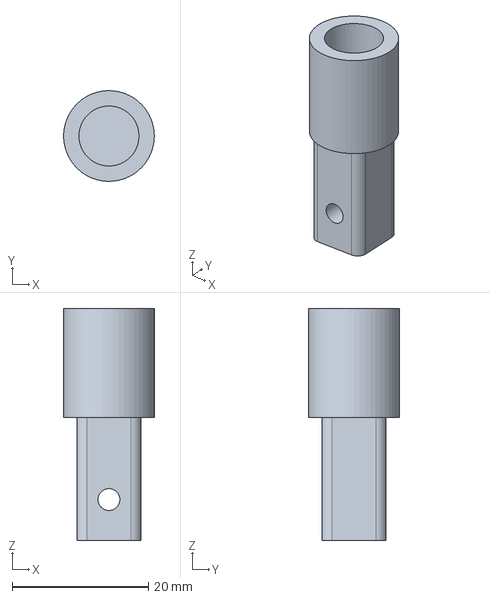
[picture p48: CAD file, 2026-10-15]
cad/out/dart_hinge.step
13.3 x 13.3 x 34.0 mm
