paulrenzi/drone-detection-research/cad/gpt61/out/fit_coupon.step

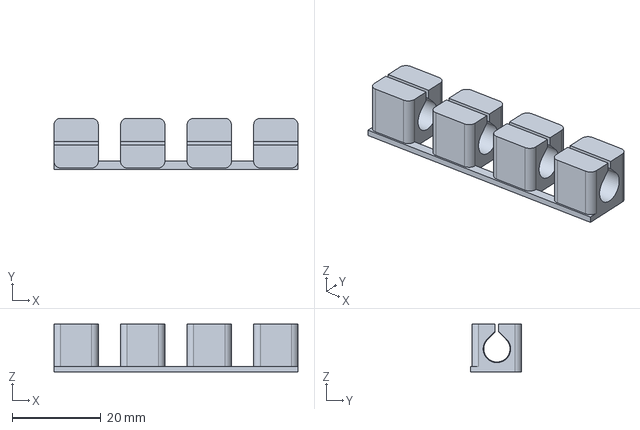
[picture p49: CAD file, 2026-10-21]
cad/gpt61/out/fit_coupon.step
55.0 x 11.6 x 10.8 mm
