paulrenzi/drone-detection-research/cad/out/harness_saddle.stl

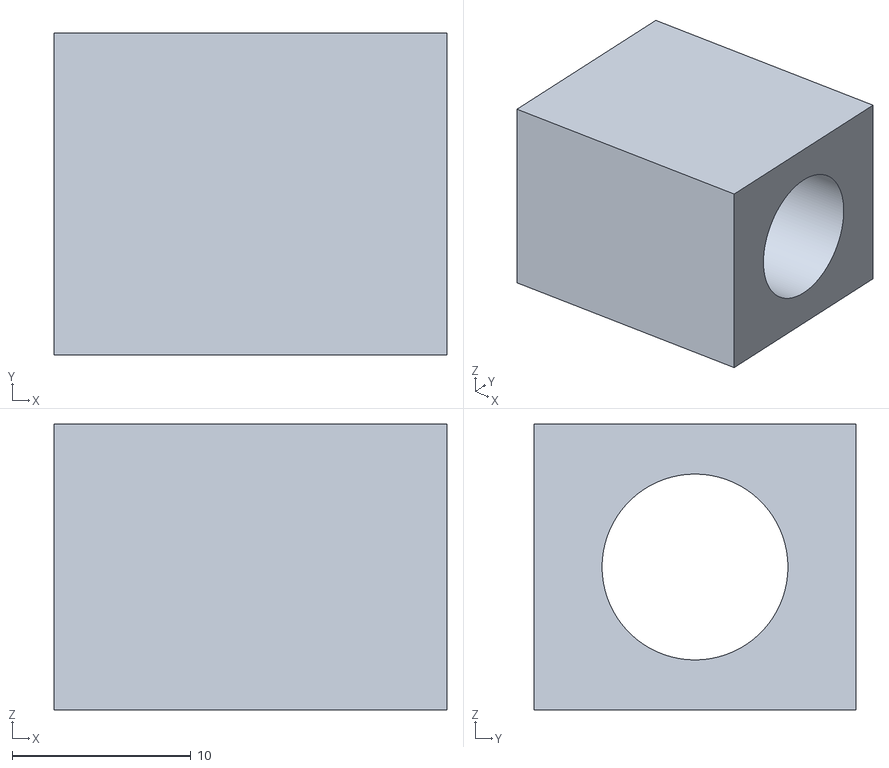
[picture p50: CAD file, 2026-10-15]
cad/out/harness_saddle.stl
22.0 x 18.0 x 16.0
