paulrenzi/drone-detection-research/cad/gpt61/out/bought_18650.step

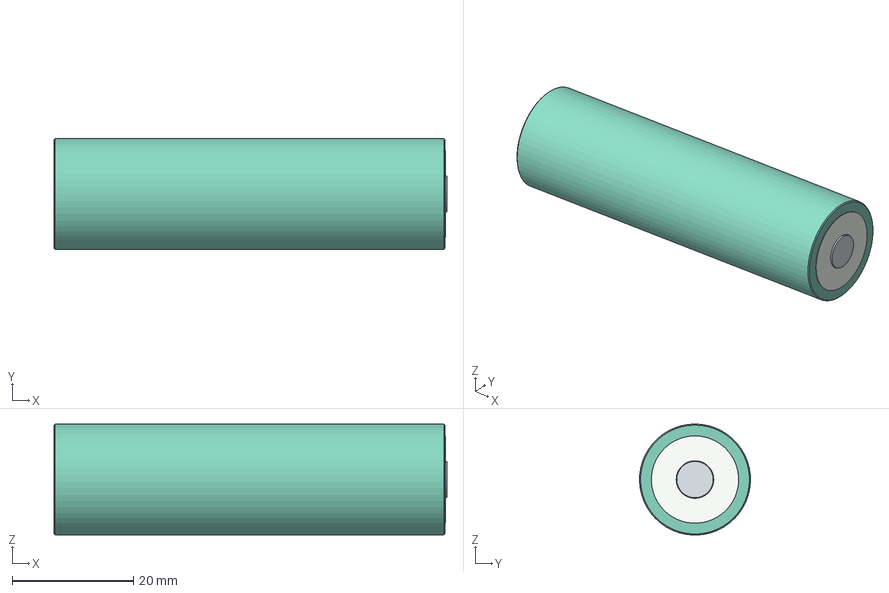
[picture p51: CAD file, 2026-10-21]
cad/gpt61/out/bought_18650.step
64.8 x 18.3 x 18.3 mm
cell_wrap
positive_terminal
positive_insulator
