paulrenzi/drone-detection-research/cad/out/quad_hull.step

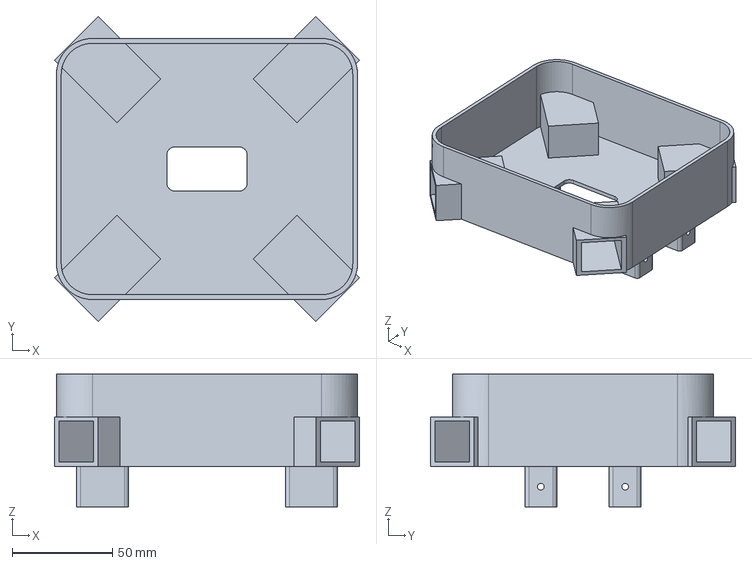
[picture p52: CAD file, 2026-10-15]
cad/out/quad_hull.step
151.9 x 151.9 x 66.0 mm
