paulrenzi/drone-detection-research/cad/out/harness_release_block.stl

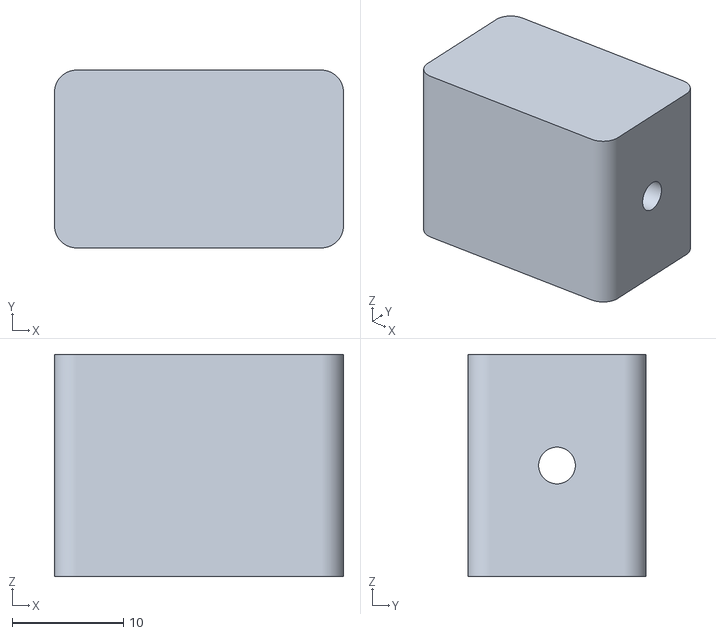
[picture p54: CAD file, 2026-10-15]
cad/out/harness_release_block.stl
26.0 x 16.0 x 20.0
