paulrenzi/drone-detection-research/cad/gpt61/out/tail_fin.step

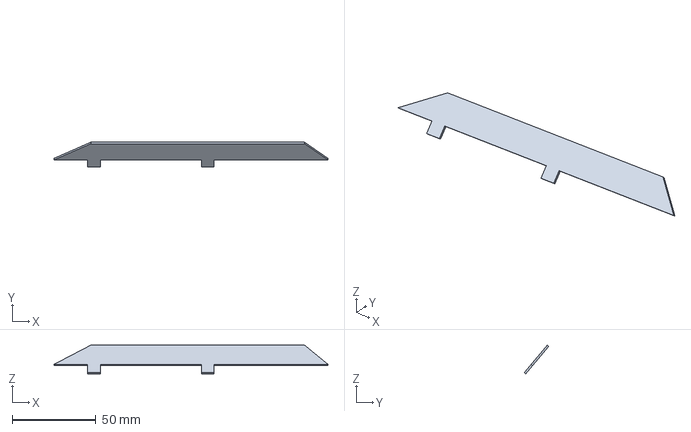
[picture p55: CAD file, 2026-10-21]
cad/gpt61/out/tail_fin.step
164.0 x 14.7 x 17.2 mm
