paulrenzi/drone-detection-research/cad/out/dart_body.step

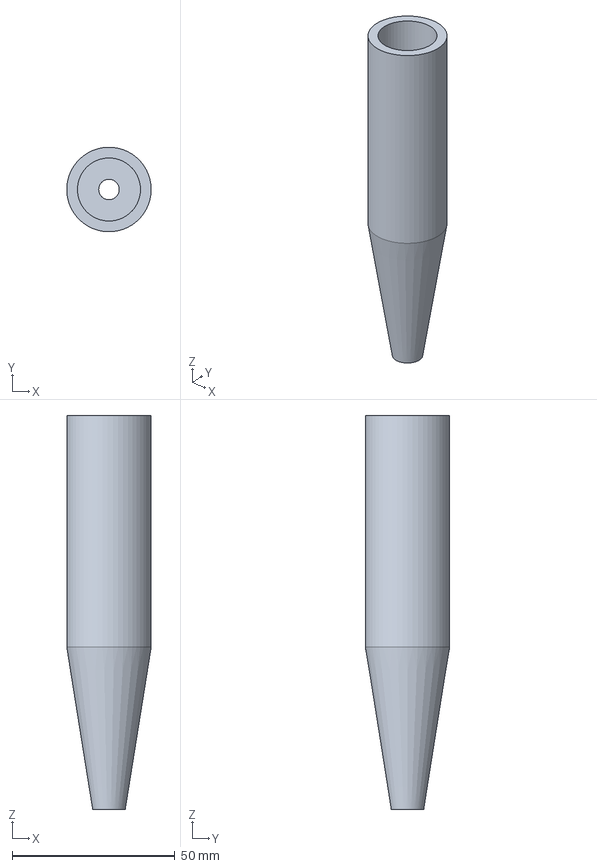
[picture p56: CAD file, 2026-10-15]
cad/out/dart_body.step
26.0 x 26.0 x 121.2 mm
