paulrenzi/drone-detection-research/cad/gpt61/out/rotor.step

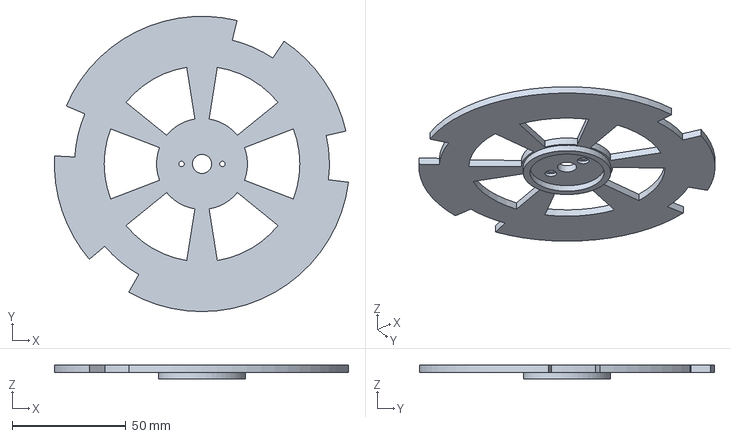
[picture p57: CAD file, 2026-10-21]
cad/gpt61/out/rotor.step
129.2 x 129.8 x 6.00 mm
