paulrenzi/drone-detection-research/cad/out/quad_arm.step

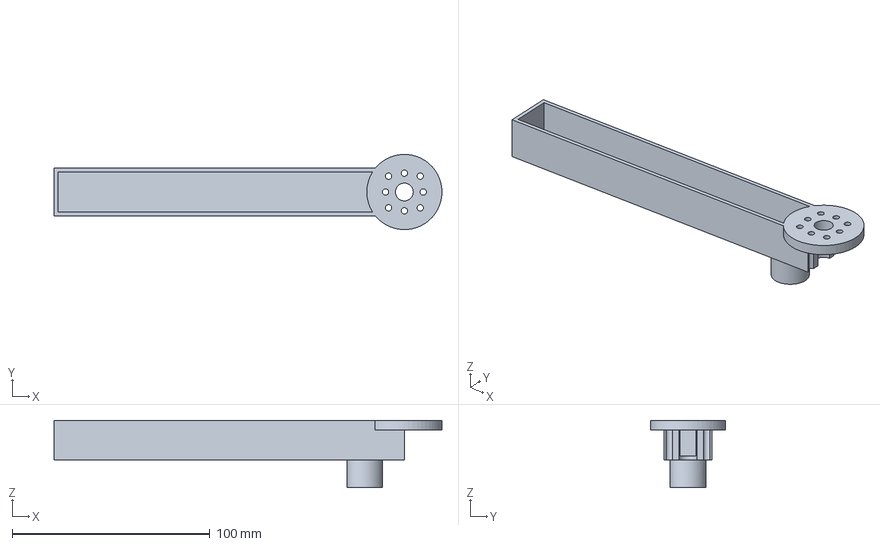
[picture p58: CAD file, 2026-10-15]
cad/out/quad_arm.step
196.0 x 38.0 x 34.0 mm
