paulrenzi/drone-detection-research/cad/gpt61/out/dummy_head_insert.step

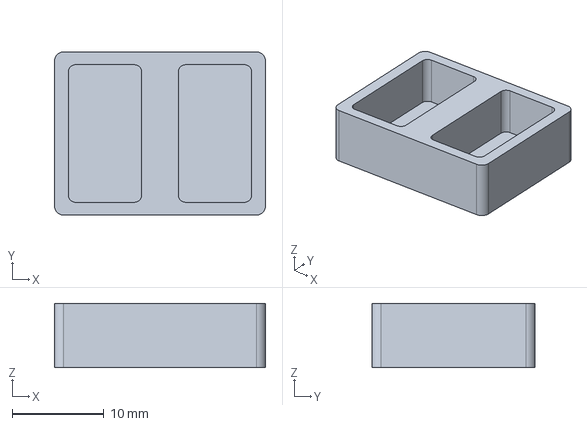
[picture p59: CAD file, 2026-10-21]
cad/gpt61/out/dummy_head_insert.step
23.0 x 17.8 x 7.00 mm
