paulrenzi/drone-detection-research/cad/out/quad_leg.step

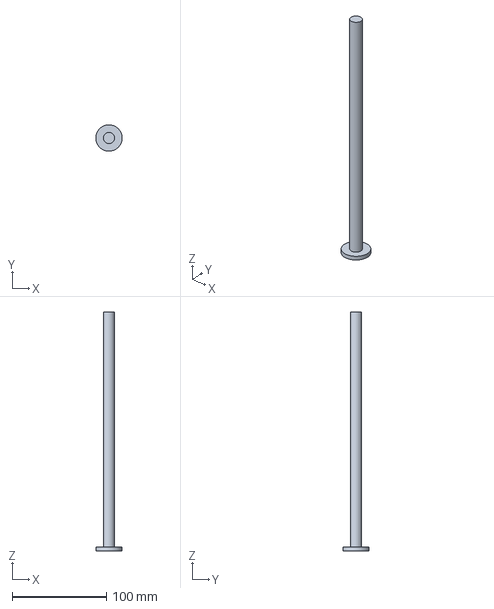
[picture p60: CAD file, 2026-10-15]
cad/out/quad_leg.step
28.0 x 28.0 x 254.0 mm
