paulrenzi/drone-detection-research/cad/gpt61/out/bought_xiao_wio_stack.step

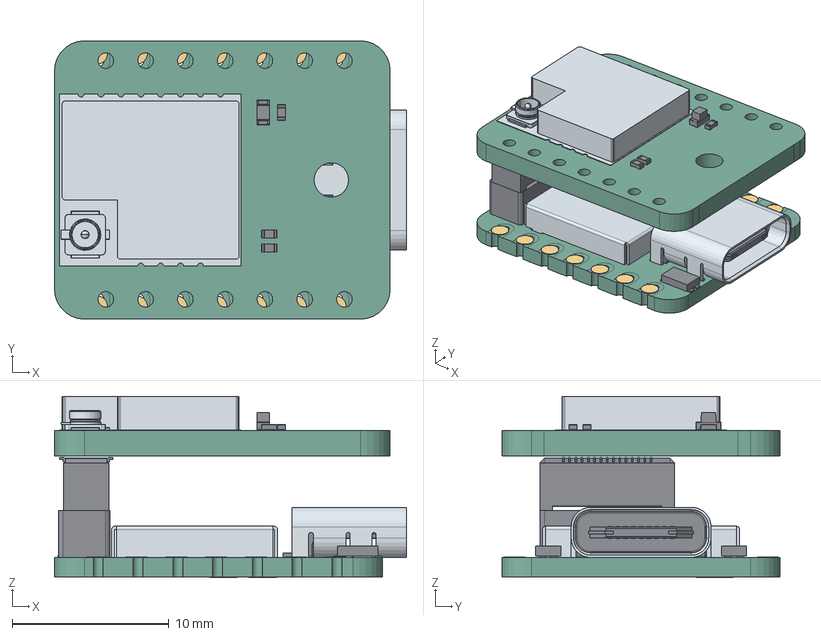
[picture p61: CAD file, 2026-10-21]
cad/gpt61/out/bought_xiao_wio_stack.step
22.5 x 17.8 x 11.6 mm
xiao_oem_00
xiao_oem_01
xiao_oem_02
xiao_oem_03
xiao_oem_04
xiao_oem_05
xiao_oem_06
xiao_oem_07
xiao_oem_08
xiao_oem_09
xiao_oem_10
xiao_oem_11
xiao_oem_12
xiao_oem_13
xiao_oem_14
xiao_oem_15
xiao_oem_16
xiao_oem_17
xiao_oem_18
xiao_oem_19
xiao_oem_20
xiao_oem_21
xiao_oem_22
xiao_oem_23
xiao_oem_24
xiao_oem_25
xiao_oem_26
xiao_oem_27
xiao_oem_28
xiao_oem_29
xiao_oem_30
xiao_oem_31
xiao_oem_32
xiao_oem_33
xiao_oem_34
xiao_oem_35
xiao_oem_36
wio_oem_00
wio_oem_01
wio_oem_02
wio_oem_03
wio_oem_04
wio_oem_05
wio_oem_06
wio_oem_07
wio_oem_08
xiao_B2B_mate
xiao_castellation_-8.1_0
xiao_castellation_-8.1_1
xiao_castellation_-8.1_2
xiao_castellation_-8.1_3
xiao_castellation_-8.1_4
xiao_castellation_-8.1_5
xiao_castellation_-8.1_6
xiao_castellation_8.1_0
xiao_castellation_8.1_1
xiao_castellation_8.1_2
xiao_castellation_8.1_3
xiao_castellation_8.1_4
xiao_castellation_8.1_5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
