paulrenzi/drone-detection-research/cad/out/dart_pod.step

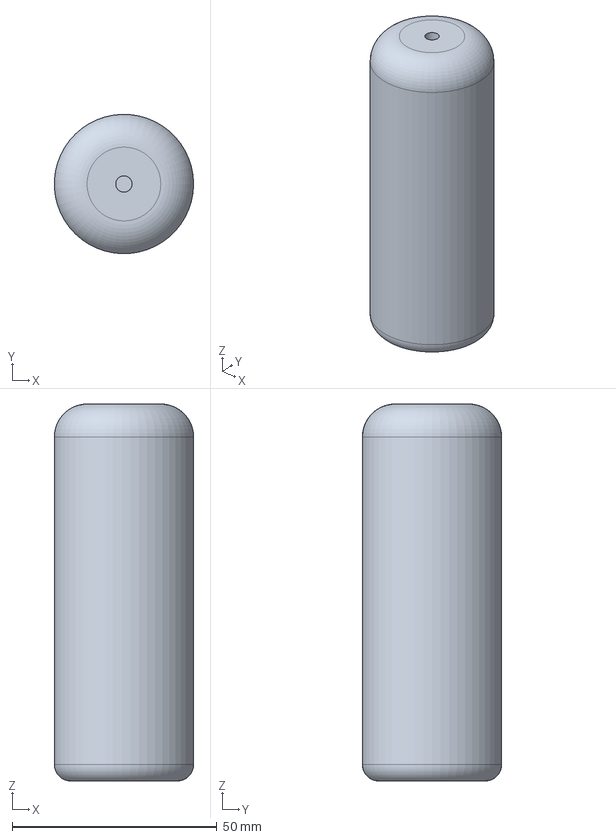
[picture p62: CAD file, 2026-10-15]
cad/out/dart_pod.step
34.0 x 34.0 x 92.0 mm
