paulrenzi/drone-detection-research/cad/gpt61/out/stake_cell_holder.step

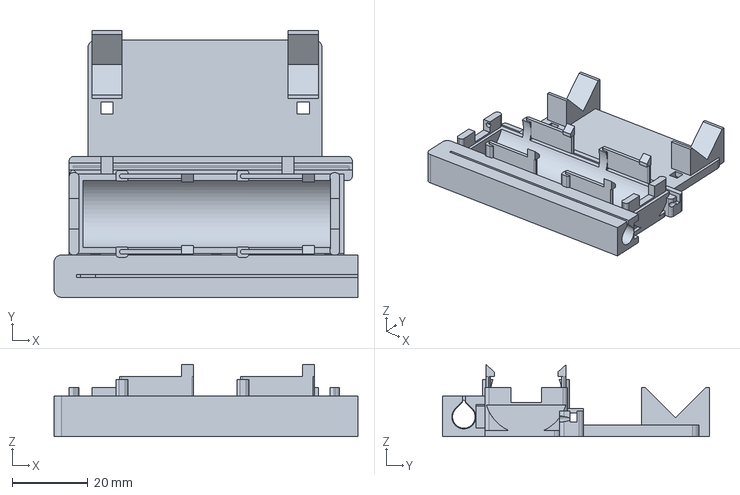
[picture p63: CAD file, 2026-10-21]
cad/gpt61/out/stake_cell_holder.step
80.5 x 70.6 x 19.1 mm
