paulrenzi/drone-detection-research/cad/gpt61/out/stake_adapter.step

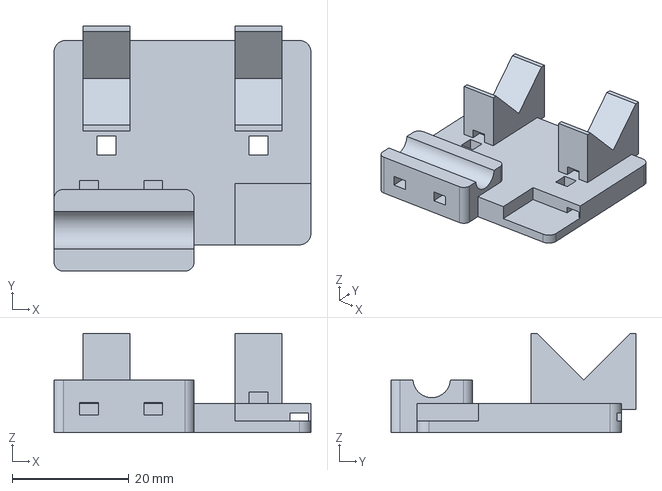
[picture p64: CAD file, 2026-10-21]
cad/gpt61/out/stake_adapter.step
44.0 x 42.0 x 17.0 mm
