paulrenzi/drone-detection-research/(list of files, cad)

Other CAD files:
cad/gpt61/out/dummy_body.step
cad/gpt61/out/body.stl
cad/gpt61/out/dummy_body.stl
cad/gpt61/out/dummy_head_insert.stl
cad/gpt61/out/dummy_lid.stl
cad/gpt61/out/fit_coupon.stl
cad/gpt61/out/plate.stl
cad/gpt61/out/pod_lid.stl
cad/gpt61/out/pod_shell.stl
cad/gpt61/out/rotor.stl
cad/gpt61/out/stake_adapter.stl
cad/gpt61/out/stake_cell_holder.stl
cad/gpt61/out/tail_collar.stl
cad/gpt61/out/tail_fin.stl
cad/gpt61/out/usb_cap.stl
cad/out/dart_body.stl
cad/out/dart_cap.stl
cad/out/dart_hinge.stl
cad/out/dart_pod.stl
cad/out/harness_plate.stl
cad/out/harness_simple_plate.stl
cad/out/quad_arm.stl
cad/out/quad_hull.stl
cad/out/quad_leg.stl
cad/out/v2_dart_body.step
cad/out/v2_dart_body.stl
cad/out/v2_dart_clip.stl
cad/out/v2_dart_pod.step
cad/out/v2_dart_pod.stl
cad/out/v2_plate.stl
cad/out/v2_rotor.stl
cad/out/v3_dart_body.stl
cad/out/v3_dart_pod.stl
