paulrenzi/drone-detection-research/build-hardware.md

---
title: "Build: hardware"
nav_order: 1.6
nav_tripwire: 6
---

# Build: hardware, the dart, the harness and a printed carrier
{: .no_toc }

<p class="vz-lede">Printable designs for the <a href="{{ site.baseurl }}{% link models/tripwire.md %}">tripwire</a>: <strong>a dart of three parts</strong> that sticks point-first in soil, and a <strong>one-servo harness</strong> that drops four of them from an X500.</p>

<figure class="vz-figure">
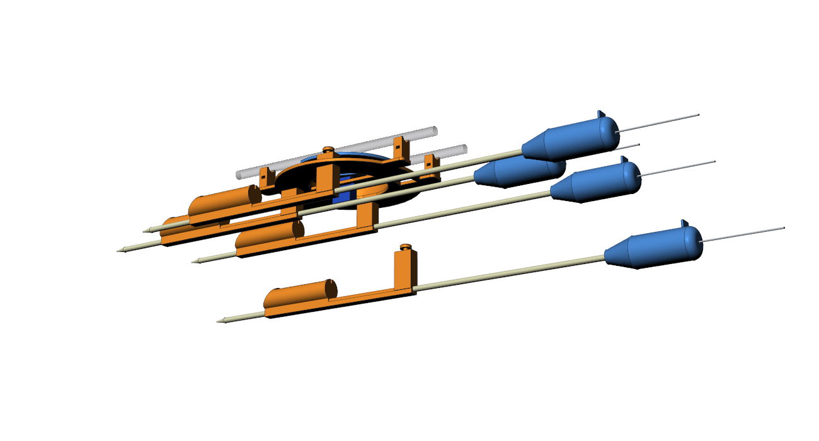
[picture p65: assets/images/build/v3-harness.png]
Four v3 darts under the X500's rails on the v2 plate and rotor; one dart is falling

<figcaption>Four v3 darts on the harness under an X500, the first one falling. A render from the CAD; never printed or flown.</figcaption>
</figure>

<div class="stats">
  <div class="stat"><p class="stat-num">3 parts</p><p class="stat-label">a dart: fibreglass rod, printed body, head pod</p></div>
  <div class="stat"><p class="stat-num">≈ $50</p><p class="stat-label">parts for 4 darts and the harness, prices checked 2026-10-15</p></div>
  <div class="stat"><p class="stat-num">~1.7 mi</p><p class="stat-label">out with 4 darts on an X500 (est.)</p></div>
  <div class="stat"><p class="stat-num">0</p><p class="stat-label">printed or flown yet: version 0 designs</p></div>
</div>

### The dart, standing in soil

<div class="vz-cards vz-2">
  <div class="vz-card" style="display:flex;gap:14px;align-items:flex-start">
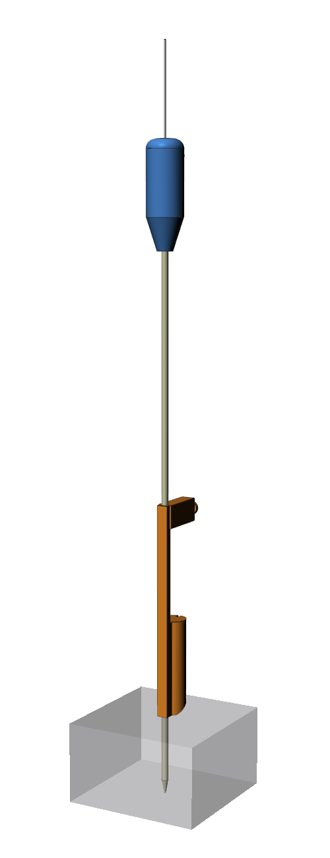
[picture p66: assets/images/build/v3-dart.png]
v3 dart standing in soil: rod tip in the ground, orange body up to the hanger post, blue head pod with its whip at the top
    
    <div>
      <p class="vz-card-num">~4.5 oz</p>
      <p><strong>Rod</strong> is spike, spine and mast. <strong>Body</strong> holds the cell near the tip and the hanger post at the balance point. <strong>Head pod</strong> holds the board, mic and whip about 20 in up.</p>
    </div>
  </div>
  <div class="vz-card">
    <p class="vz-card-num">Which design is current</p>
    <p><span class="vz-chip vz-chip-done">current</span> <strong>v3 dart</strong>: 3 parts, a 4-dart kit is 15 parts</p>
    <p><span class="vz-chip vz-chip-done">current</span> <strong>v2 harness</strong>: one plate, one rotor, one servo</p>
    <p><span class="vz-chip vz-chip-open">option</span> <strong>TL-1</strong>: a fully printed quad, about 8 oz lighter</p>
    <p><span class="vz-chip">superseded</span> <strong>v1</strong>: folding mast, four servos; kept as a fallback</p>
  </div>
</div>

<p class="vz-done">A newer, detailed model built from manufacturer CAD, with a 3D viewer, is on <a href="{{ site.baseurl }}{% link build-3d.md %}">Build: 3D models</a>. Software: <a href="{{ site.baseurl }}{% link build-software.md %}">Build: software</a>.</p>

## The details

Each section opens for the full reasoning, numbers and sources.

<button type="button" class="layer-toggle" data-layers-toggle>Open all sections</button>

<details class="layer" id="the-short-version-in-full" markdown="block">
<summary><span class="layer-title">The designs, as first listed</span><span class="layer-sub">The page's original opening, the 3D-model note and the version-0 warning</span></summary>

Printable designs for the [tripwire]({{ site.baseurl }}{% link models/tripwire.md %}):

- **v3, the current design:** each dart is a fibreglass rod, one printed body and a head pod: 3 parts. It hangs from v2's one-servo harness unchanged. A 4-dart kit has 15 parts against v2's 27, and the parts list is about $50 against $63.
- **v2:** the one-rod dart with a separate clip, a zip tie and foam. Its harness is still the current one.
- **v1, superseded:** a folding-mast dart and a four-servo harness, kept below for its drop-test questions and as a fallback.
- **A fully printed carrier quad (TL-1):** built round the X500's electronics.

{: .note }
> **A newer, detailed model of the dart and harness** is on [Build: 3D models]({{ site.baseurl }}{% link build-3d.md %}): built by GPT-6.1 from manufacturer CAD and datasheets, with a 3D viewer and exploded views. It is built round the Seeed XIAO ESP32S3 + Wio-SX1262 kit we bought, and adds a hand-placed stake mount and a weighted drop-test dummy. It keeps this page's concept. The renders below are the earlier hand-built models.

Software: [Build: software]({{ site.baseurl }}{% link build-software.md %}).

{: .warning }
> **Version 0 designs, never printed or flown.** Dimensions from datasheets are sourced; masses, flight times and impact figures are estimates from the models and labelled as such. Parts marked *measure* in [`cad/params.py`](https://github.com/paulrenzi/tripwire/blob/main/cad/params.py) must be checked with calipers before printing.

</details>

<details class="layer" id="short-answer" markdown="block">
<summary><span class="layer-title">Short answer</span><span class="layer-sub">v3 dart, v2 harness and TL-1 side by side: parts, mass, hover, reach</span></summary>

| | v3 dart | v2 X500 harness | Printed TL-1 quad |
|---|---|---|---|
| Printed parts | 2 (body, head pod) | 2 (plate, rotor) | Hull, 4 arms, 4 legs |
| Mass (est.) | ~4.5 oz each, with an 18650 cell | ~2.8 oz with its one servo | ~13.4 oz frame, against 1.3 lb for the X500 frame ([Holybro](https://holybro.com/products/px4-development-kit-x500-v2)) |
| Hover time with 4 darts (est.) | n/a | **11.3–11.8 min** (v1: 9–10) | 11.5–12 min with v1 darts |
| Reach with 4 darts (est.) | n/a | **~1.68–1.74 mi out** (v1: 2.2–2.3) | ~1.7–1.8 mi out with v1 darts |
| Fits the Vyper's 9.6 × 9.6 × 10.2 in bed | Yes | Yes | Yes, every part |

- **An X500 carries four v3 darts about 1.7 mi out,** the same as v2: the dart weighs about the same. Lines 1.9–2.5 mi out need fewer darts per sortie, a bigger pack, or a fixed-wing. That is T13's question, now with numbers to test against.
- **The printed quad wins on mass, not money.** The frame cost saving is small, as [the tripwire says]({{ site.baseurl }}{% link models/tripwire.md %}#why-3d-print-the-drones-and-the-nodes). But an estimated ~8.1 oz lighter frame is worth about 2.5 more minutes of hover with four darts, and the dart bay is built into the hull.
- **Print the dart first.** It is needed for T10 (drop test), T11 (range at 1.6–3.3 ft) and T12 (battery), whichever drone carries it.

</details>

<details class="layer" id="the-printer-and-the-cad" markdown="block">
<summary><span class="layer-title">The printer and the CAD</span><span class="layer-sub">An Anycubic Vyper printing PETG, and CadQuery scripts for every part</span></summary>

- **Printer: Anycubic Vyper.** Build volume 9.6 × 9.6 × 10.2 in, nozzle up to 500 °F, bed up to 230 °F. Officially it prints PLA, PETG, TPU, ABS and wood fill ([spec, via 3DSourced](https://www.3dsourced.com/3d-printer-reviews/anycubic-vyper-test-review-specs/)). It has no enclosure, so print in **PETG**: it tolerates sun and heat better than PLA and prints well without an enclosure (inference). Carbon-filled nylon and ASA, the usual next step for arms, warp without an enclosure and need a hardened nozzle. That is a second printer, needed only after the prototype stage.
- **CAD: CadQuery,** text-based and in Python. Every model is a script in [`cad/`](https://github.com/paulrenzi/tripwire/tree/main/cad) that reads its dimensions from one file, `cad/params.py`, so a change shows up as a readable diff. Each run writes STL (for slicing), STEP (for any other CAD tool) and the PNG renders on this page, and prints bed-fit checks, masses and the flight-time table. Install: `python -m venv cad-env` then `cad-env/Scripts/pip install cadquery`. Run `python v2.py`, `dart.py`, `harness_simple.py` or `quad.py` from `cad/`.

</details>

<details class="layer" id="1-v3-three-parts-per-dart" markdown="block">
<summary><span class="layer-title">1. v3: three parts per dart</span><span class="layer-sub">Rod, body and pod; what changed from v2, and what to check</span></summary>

Four v3 darts under the X500's rails on the v2 plate and rotor: each dart is a fibreglass rod with one long orange printed body, holding the cell near the tip and the hanger post at the balance point, and a blue head pod at the back; one dart is falling

<p style="display:flex;gap:1rem;align-items:flex-end;flex-wrap:wrap">
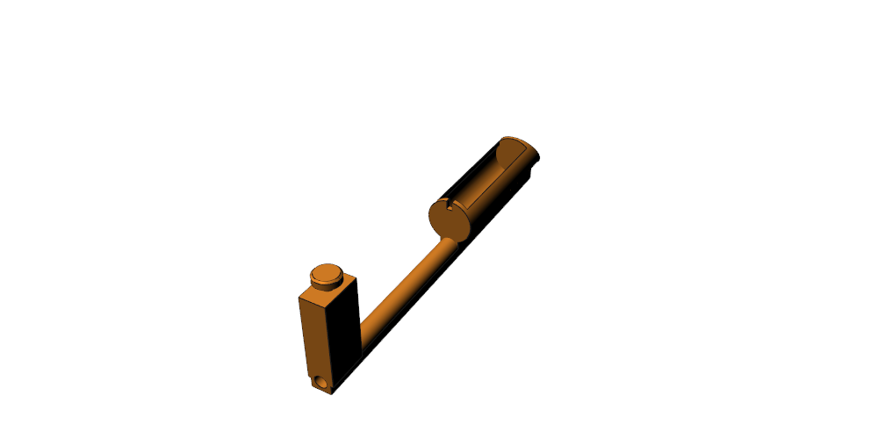
[picture p67: assets/images/build/v3-body.png]
The v3 body as printed, lying on its flat underside: an open cell cradle at one end, a sleeve along the rod, and the hanger post with its round head at the other end

v3 dart standing in soil: bare rod tip in the ground, the orange body from the surface up to the hanger post, and the blue head pod with its whip at the top
</p>

*Top: four darts on v2's harness, with the first one falling. Left: the body as it prints, cradle open on top. Right: a dart in soil.*

**v3 changes only the dart.** v2's plate, rotor and servo carry it as they are: the hanger head is the same round head on the same radius. The model reruns v2's checks with v3 darts: each dart stays on the rim until its own step, drops at it, and nothing collides at any angle.

**Each dart is a rod, one printed body and the head pod.**

- **The body is one print: nose, cell cradle, sleeve and hanger.** The 18650 presses down into an open cradle whose lips are 0.62 in apart, narrower than the 0.73 in cell, so it snaps in and the cradle wraps 251° round it. That replaces v2's zip tie. A sleeve runs back along the rod to the hanger post, which the model places at the balance point, 9.7 in from the tip. That replaces v2's separate clip, which had to be glued at a measured spot.
- **No foam.** The mic looks out of a side port under a small printed hood on the pod.
- **It prints lying on its flat underside,** post and cradle opening up, with no supports. It is 7.3 in long and weighs about 0.78 oz (estimate).

| | v2 | **v3** |
|---|---|---|
| Parts per dart | 6 (rod, body, clip, pod, foam, zip tie) | **3 (rod, body, pod)** |
| Parts in a 4-dart kit with the harness | 27 | **15** |
| Glue joints set at a measured spot | 1 per dart (clip at the balance point) | **0** |
| Dart mass (est.) | ~4.4 oz | ~4.5 oz |
| Parts to buy for 4 darts and the harness | ≈ $63 | **≈ $50** |

**What it costs in performance:**

- **It still rides flat and must turn point-down as it falls** (T10). The balance point is 44% of the length from the tip, against v2's 45%.
- **No windscreen** means more wind noise. T11 should measure with and without foam. If foam is needed, it's $0.50 a dart and one part back.
- **The balance point is fixed in the print.** If the real board and wiring weigh more or less than the estimates, the dart hangs slightly nose- or tail-low; the plate slot keeps the post upright. The fix is to weigh one assembled dart, put the masses into `v3.py` and reprint the body.
- **The cradle has to hold the cell at landing.** The impact pushes the cell into the solid nose wall, not out through the snap, but T10 should check it.
- **Samsung 25R cells hold 2,500 mAh against the P28A's 2,800,** about 11% less battery, for $1 less each. The Samsung 35E holds 3,500 mAh for $5.99.

**Why the cost fell by a fifth, not by half.** The cells are $20 of the $50, and filament, rods and servos come in packs bigger than one kit needs. Per 4-dart re-lay, the bill is about $26.50: cells $20, rods $4.40 and about $2 of filament (estimates from the model's masses), against about $33 for v2. **The rest of the cost is the cells.** EVE 35V cells (3,500 mAh) were listed at $2.50–2.99 but were sold out on 2026-10-15 at both [18650 Battery Store](https://18650batterystore.com/products/eve-35v-18650-3500mah-10a-battery) and [IMR Batteries](https://imrbatteries.com/products/eve-35v-18650-3500mah-10a-battery). In stock, they would bring a re-lay to about $16.50 (half of v2's) and the parts list to about $40.

**Wiring and mission:** as v2: Pixhawk AUX 1, one `DO_SET_SERVO` step per dart.

*Measure before printing:* as v2, plus the cell's real diameter. The snap needs the lips narrower than the cell, and the 25R measures 0.72 in, not 18.6.

</details>

<details class="layer" id="2-v2-one-rod-one-servo" markdown="block">
<summary><span class="layer-title">2. v2: one rod, one servo</span><span class="layer-sub">The rotor harness that still carries v3, and the flat-carried dart</span></summary>

v3 keeps v2's plate, rotor and servo as they are; only the dart changed. v2's dart is the fallback if the snap cradle or the fixed hanger position fails.

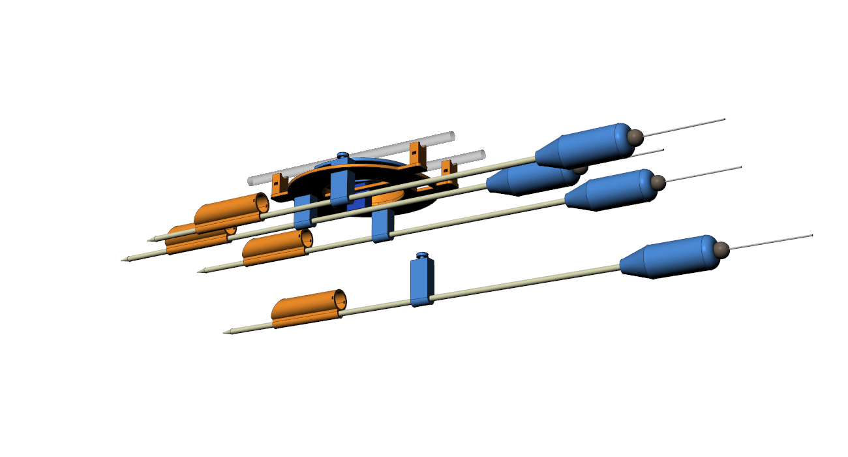
[picture p68: assets/images/build/v2-harness.png]
v2 harness under the X500's two rails: a round printed plate with a dark rotor on top, four darts lying flat beneath it, each a long fibreglass rod with an orange cell body near the tip, a blue clip near the middle and a blue head pod at the back; one dart is falling


<p style="display:flex;gap:1rem;align-items:flex-end;flex-wrap:wrap">
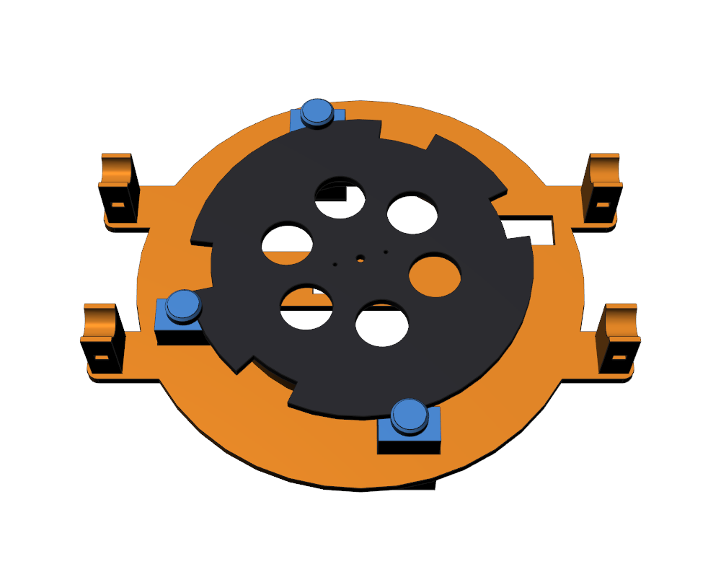
[picture p69: assets/images/build/v2-rotor.png]
Top of the plate: the dark rotor with four gaps in its rim; three clip heads rest on the rim, and the fourth slot is empty because its dart has dropped through the gap

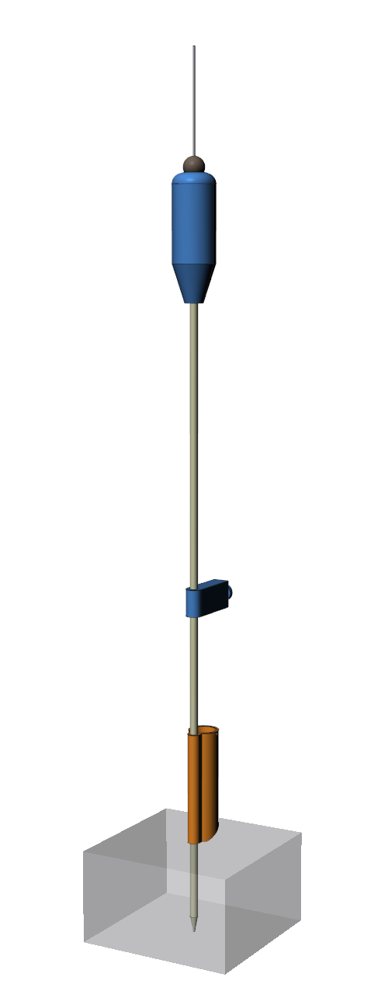
[picture p70: assets/images/build/v2-dart.png]
v2 dart standing in soil: bare rod tip in the ground, orange cell body at the surface, blue clip halfway up, blue head pod with foam and whip at the top

</p>

*Top: four darts under the X500's rails, with the first one falling. Left: the rotor after the first step; that dart's slot is empty. Right: a dart in soil, about 20 in to the mic.*

**The dart is one rod with three printed parts on it.** A single 0.24 × 20 in solid fibreglass rod is the spike, the spine and the mast.

- **Body:** slides on from the tip and holds the 18650 low, next to the rod, 2.8 in back from the point. A zip tie through the back closes the cell bay. Soil stops at the body, so at most 2.8 in of rod goes in.
- **Clip:** slides on and is glued where the dart balances, about 10 in from the tip (model). It is the hanger: a post with a round head.
- **Head pod:** a thin printed shell on the rod's top end, holding the board upright (a Heltec V3 in this design; the [3D model]({{ site.baseurl }}{% link build-3d.md %}) uses the XIAO kit), with the mic under foam and the whip out of the top.

**The harness is one plate, one rotor and one servo.**

- The plate sits on two printed posts zip-tied to the X500's rails. Each dart's clip comes up through a slot in it.
- The clip's round head rests on the rim of a printed rotor, which is screwed to the servo horn. A printed ring on the plate carries the rotor, so the darts' weight goes into the plate, not the servo.
- **The rim has one gap per dart, each at a different angle.** The servo turns 16° per step. Each step brings exactly one gap under its dart's head, and that dart drops through its slot. The model checks every angle from rest to 64°: each dart stays on the rim until its own step and is free at it, and nothing collides at any angle.
- The inner pair drops first, one each side, then the outer pair, so the load stays balanced.
- **To load,** turn the rotor to 64° and fit the last dart, then step back to 48°, 32° and 16° for the third, second and first, then to rest. No gap passes a loaded head on the way down.

**What v2 removed:**

| | v1 | **v2** |
|---|---|---|
| Printed parts per dart | 4 (body, cap, hinge, pod) | **3 (body, clip, pod)** |
| Other parts per dart | steel spike, 4 pole sections, shock cord, spring, bolt, nut, fur | **1 fibreglass rod, foam, zip tie** |
| Joints that must move in flight, per dart | 5 (hinge + 4 pole joints) | **0** |
| Harness | plate + 4 servos | **plate + rotor + 1 servo** |
| Servo outputs on the Pixhawk | 4 | **1** |
| Parts in a 4-dart kit, excluding cells and electronics | 61 | **27** |
| Dart mass (est.) | ~6.9 oz | **~4.4 oz** |
| Darts hang below the rail axis | ~8.6 in: needs 2.4–3.1 in leg extensions | **~2.8 in: stock legs** |
| Parts to buy for 4 darts and the harness | ≈ $139 | **≈ $63** |

**What it costs in performance:**

- **The mic sits lower,** about 19 in above soil if the body reaches the ground, against about 31 in for v1. That is still inside the 1.6–3.3 ft T11 tests, at its bottom edge. A 17 in rod (the cheaper alternative below) gives about 17 in.
- **Foam instead of fur** means more wind noise. A fur cover can be added later for about $2 each.
- **The darts ride flat, so each one must turn point-down as it falls.** The cell sits forward and the pod and foam drag at the back. The balance point is 45% of the length from the tip, which should make it fall like a shuttlecock or lawn dart (inference). Whether it turns in 16–49 ft of fall is now T10's first question. If it doesn't, hang the clip a little ahead of the balance point so the dart leaves the drone nose-down.
- **One rotor drives all four darts,** so if it jams, the rest of that sortie's darts stay on. With v1, a stuck servo cost one dart. Bench-test it: 50 load-and-release cycles with 4.6 oz dummies, then a shake test.
- **The footprint is longer:** the darts are about 30 in long with the whip, so they likely reach past the props fore and aft (estimate; Holybro doesn't publish the overall length). They ride about 2.8 in under the rails.

**Wiring and mission:** one output, Pixhawk AUX 1, with `SERVO9_FUNCTION = 0`. Each drop point gets a `DO_SET_SERVO` (183) with p1 = 9 and p2 = that step's PWM. On an SG90's roughly 1,000–2,000 µs span for 180° (typical; calibrate on the bench), 16° is about 180 µs, so steps are about rest + 180, 360, 540 and 720 µs.

*Measure before printing:* how high the SG90's shaft stands above its tabs, which sets the rotor height (sand the ring to match), the rail spacing, and the rod's real diameter.

</details>

<details class="layer" id="3-v1-dart-folding-mast-superseded-by-v2" markdown="block">
<summary><span class="layer-title">3. v1 dart: folding mast (superseded by v2)</span><span class="layer-sub">Kept for its drop-test questions and as a fallback</span></summary>

v1 is kept because its drop-test questions still apply to v2, and as a fallback if a flat-carried dart won't turn point-down.

<p style="display:flex;gap:1rem;align-items:flex-end;flex-wrap:wrap">
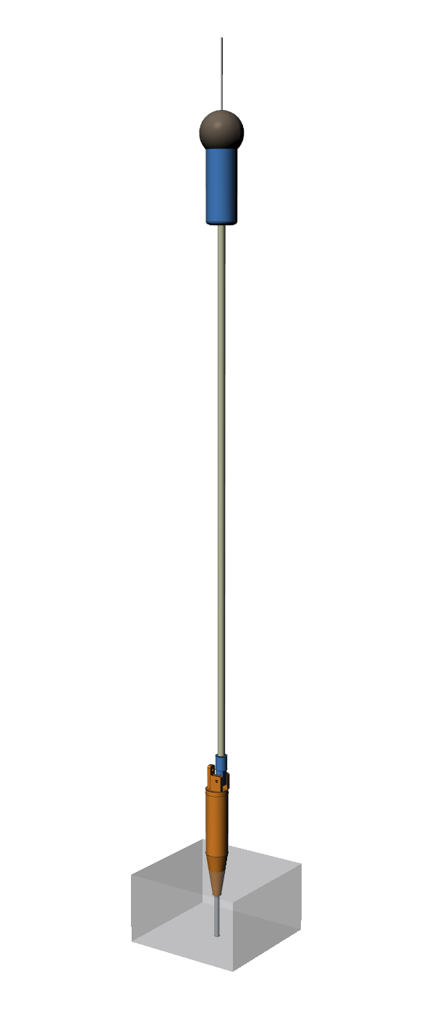
[picture p71: assets/images/build/dart-deployed.png]
Dart deployed: steel spike and cone in the soil, cell body, hinge, mast, head pod with fur and whip at about 31 in

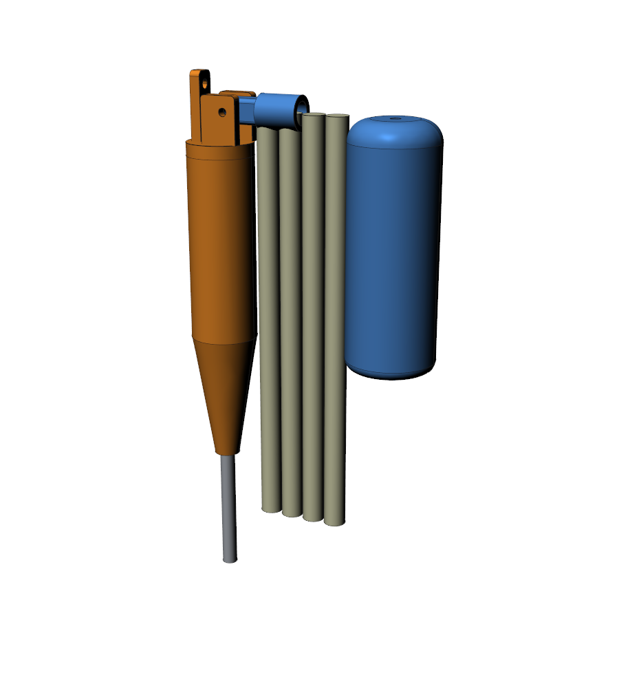
[picture p72: assets/images/build/dart-stowed.png]
Dart stowed: mast folded flat at the hinge, four pole sections and the head pod alongside the body

</p>

*Left: deployed, with the grey block marking soil. Right: stowed for carrying, 3.9 × 1.3 × 8 in.*

**How it works:**

1. It hangs upright, spike down, by the **tongue** on its cap. A steel pin from the harness passes through the tongue.
2. The pin pulls and the dart falls point-first. The **4 mast sections**, shock-corded like a tent pole, snap together, and an elastic band or torsion spring at the **hinge** swings the mast upright.
3. The **0.24 in steel spike** and the printed cone go into the soil. The cell sits low, so the dart is nose-heavy. The fur-covered head at the top adds drag, acting like a shuttlecock's feathers to keep it point-down (inference; T10 tests it).
4. The **head pod** holds the board, microphone and antenna together at about 31 in. Only two power wires run down the mast to the cell. The mic is out of the grass, and the antenna is at the height T9 assumes.

| Part | Choice | Why |
|---|---|---|
| Spike | 0.24 in steel rod, 4.3 in, 2 in exposed, epoxied into the cone | A printed tip blunts in hard soil. The steel puts mass forward |
| Body | Printed cone + 18650 bay, 1 in across | Thin for penetration; the cell is the heaviest part, so it goes low |
| Cell | One 18650 (~1.6 oz, est.) | About 3,000 mAh in the space of a thumb. Its cost is set by battery life ([T12]({{ site.baseurl }}{% link research/open-questions.md %})) |
| Mast | 0.16 × 6.3 in shock-corded fibreglass tent-pole sections, 0.33 in | Folds to the body's length and self-assembles when released. Spare sections are cheap |
| Hinge | Printed socket on an M3 bolt between two ears on the cap | Folds flat for carrying, upright when deployed. Spring force to be set by test |
| Head pod | Printed, 1.3 × 3.6 in. Heltec V3 (1.98 × 1.00 × 0.40 in, [Heltec](https://wiki.heltec.org/docs/devices/open-source-hardware/esp32-series/lora-32/wifi-lora-32-v3/)) standing upright, mic at the top under fur, whip out the top | Mic and antenna both high; a custom board later shrinks the pod |

**Estimated mass:** about 6.9 oz. Printed parts are ~2.6 oz at a 60% fill estimate; steel 0.85 oz, poles 1 oz, cell 1.6 oz, board, mic, fur and wire about 0.81 oz. The pod is the easiest saving: a custom board and a 1S pouch cell could bring it to 4.2–5.3 oz (estimate).

**Not yet known (estimates, to be measured in [T10]({{ site.baseurl }}{% link research/open-questions.md %})):**

| Question | Estimate | How T10 settles it |
|---|---|---|
| Drop height | 16–49 ft above ground | Drop from 10, 16, 33 and 49 ft onto pasture, ploughed field, packed track and mud |
| Impact speed | Up to ~22 mph from 16 ft and ~38 mph from 49 ft, before drag (free fall, √(2gh)) | Phone slow-motion video beside a marked pole |
| Impact energy | ~7 ft·lb from 16 ft, ~21 ft·lb from 49 ft, at 6.9 oz | Count cracked caps and pods per height |
| Spike depth | Steel plus most of the cone in soft soil; little in packed track | Measure each drop; record upright or not |
| Does the mast deploy in a 1–2 s fall? | Unknown | Video; if not, deploy on impact instead (a pin knocked out by the landing) |
| No drop-deployed sensor with published drop figures was found | The Vietnam-era ADSID dart used a steel spike and a drag plate, but its patent gives no drop height ([US3984804A](https://patents.google.com/patent/US3984804A)) | |

</details>

<details class="layer" id="4-v1-harness-four-servos-superseded-by-v2" markdown="block">
<summary><span class="layer-title">4. v1 harness: four servos (superseded by v2)</span><span class="layer-sub">One servo per dart, kept as a fallback</span></summary>

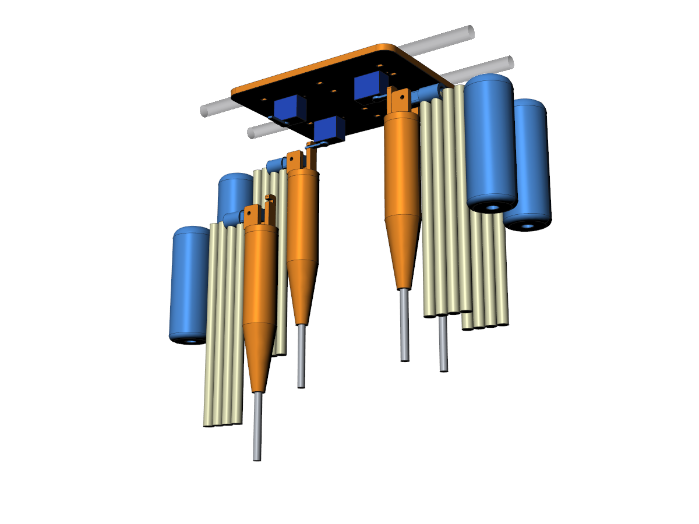
[picture p73: assets/images/build/harness-simple.png]
One printed plate zip-tied under the X500's two rails, four SG90 servos dropped into pockets, four darts hanging upright; the front-left dart is falling after its servo turned


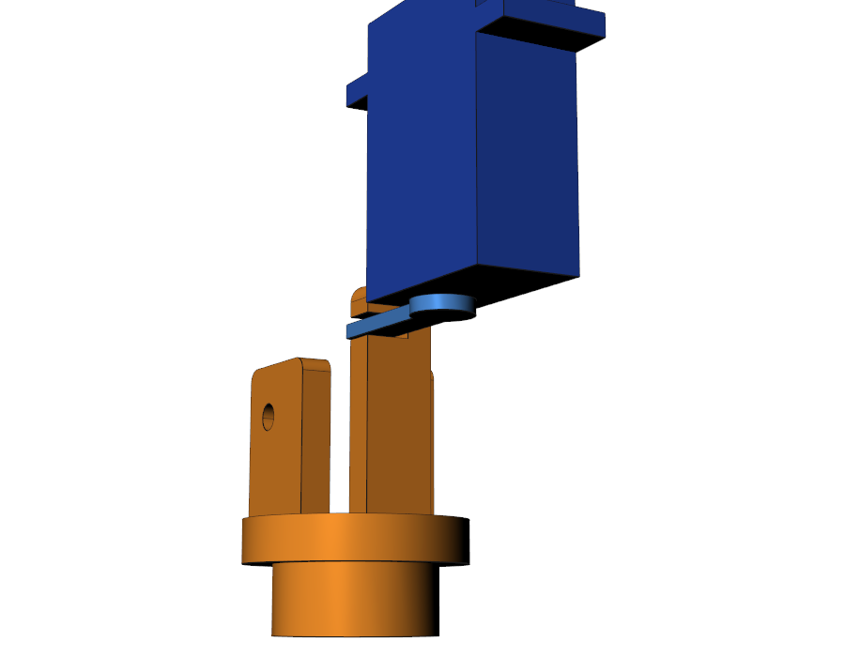
[picture p74: assets/images/build/harness-simple-latch.png]
Close-up: the servo horn arm passes through the side-open notch in the dart's tongue


**Why the X500:** it is the site's pick ([delivery drone]({{ site.baseurl }}{% link research/delivery-drone.md %}#recommended-prototype)). It runs ArduPilot, has spare servo outputs, carries a 2.2–3.3 lb payload (Holybro's two pages disagree, [product](https://holybro.com/products/px4-development-kit-x500-v2), [docs](https://docs.holybro.com/drone-development-kit/px4-development-kit-x500v2.md)), and has **two 0.39 in payload rails, 9.8 in long**, under the body.

**v1: the servo horn is the latch.** One printed part, four servos, zip ties.

- **One 5.9 × 4.7 × 0.2 in plate** (~2.2 oz, est.), zip-tied to both rails through long slots, which absorbs the unpublished rail spacing.
- **Four SG90s** (0.87 × 0.46 × 1.2 in, 0.32 oz, [datasheet](https://www.friendlywire.com/projects/ne555-servo-safe/SG90-datasheet.pdf)) drop into pockets shaft-down, held by their own tab screws.
- **Each dart's tongue has a side-open notch.** The servo's stock horn arm passes through it, and the dart hangs on the arm.
- **To release, the horn turns 90°** and the arm swings out of the open side. The model checks the latched arm sits in the notch and the sweep clears the tongue at every angle from 0° to 90°, on all four servos.
- **Wired to Pixhawk 6C AUX 1–4,** each with `SERVOx_FUNCTION = 0`, and fired by `DO_SET_SERVO` at its drop point ([ArduPilot](https://ardupilot.org/copter/docs/common-servo.html); mission format on the [software page]({{ site.baseurl }}{% link build-software.md %}#i5-mission-file-mission-tooling--drone)).
- **Darts hang upright with heads outboard,** so each falls point-first.

| | v0 pin-puller | **v1 horn latch** |
|---|---|---|
| Printed parts | 13 (plate, 4 saddles, 4 caps, 4 blocks) | **1** |
| Other hardware | 4 pins, 4 pushrods, 8+ M3 bolts | **zip ties** |
| Failure points per dart | servo, pushrod, pin bore | **servo** |
| Harness mass (est.) | ~5.3 oz | **~3.5 oz** |

**Risk to bench-test:** the horn is held only by the servo's gears. Shake the loaded airframe by hand, then fly once with dummy darts, before trusting it in flight. If it slips, the v0 pin-puller (`cad/harness.py`) is the fallback.

**Load:** 4 × ~6.9 oz darts + ~3.5 oz harness ≈ **1.9 lb** (estimate), inside Holybro's 2.2–3.3 lb.

**One fix the model found:** the hanging darts reach about **8.6 in below the rails**, about 1.7 in lower than the X500's stock feet (8.5 in gear, [Holybro](https://holybro.com/products/px4-development-kit-x500-v2); rail height below the plate estimated). The drone needs **leg extensions of about 2.4–3.1 in** to take off and land with darts on. Holybro doesn't publish the leg tube size, so those aren't modelled yet. *Measure the legs.*

**Bench checks before flying:** each pin releases under a 7.1 oz load at the servo's commanded PWM; no pin releases while the airframe is shaken by hand; a pin with no dart doesn't jam; SITL fires the same mission ([software page]({{ site.baseurl }}{% link build-software.md %}#test-harness)).

</details>

<details class="layer" id="5-a-fully-printed-carrier-tl-1" markdown="block">
<summary><span class="layer-title">5. A fully printed carrier: TL-1</span><span class="layer-sub">A printed quad with a dart bay, and its payload and flight time</span></summary>

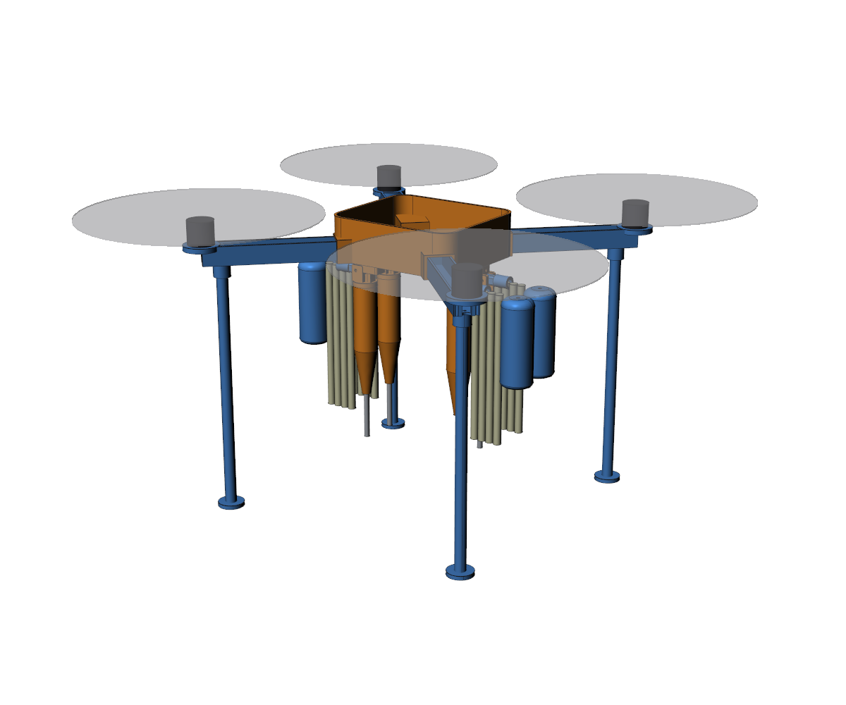
[picture p75: assets/images/build/quad-tl1.png]
Printed quad TL-1: orange hull with built-in dart bay, four blue printed arms and tall legs, 10 inch prop discs, four darts hanging under the hull


**Design rule: print the frame, buy everything that spins or thinks.** The X500 kit's motors (2216 KV920), 10-inch props, Pixhawk 6C, GPS and 4S pack move across unchanged. Only the frame changes.

| Part | Size | Notes |
|---|---|---|
| Hull | 5.9 × 5.1 × 1.8 in, 0.094 in walls | One print. The four release blocks are printed into its floor, the same pattern as the X500 plate. Flight controller and wiring inside; lid not drawn |
| Arms ×4 | 7.7 × 0.94 × 0.79 in box section | Printed flat, slide into corner sockets. Motor pad drilled for 16 × 16 and 0.75 × 0.75 in patterns (the X500's motor mounts, [Holybro](https://holybro.com/products/px4-development-kit-x500-v2)) |
| Legs ×4 | 0.47 in tube, 9.8 in, with a foot | Tall enough to clear hanging darts. **Meant to break before an arm does:** a leg is a 30-minute reprint |
| Wheelbase | 18 in | 10-inch props are about 13 in apart between neighbouring motors, so they clear |

**Estimated frame mass ~13.4 oz** (CAD volume × PETG density × 0.75 fill), against 1.3 lb for the X500 frame. A printed frame flexes more than carbon. Arm stiffness and vibration at the flight controller are the first things to check, through ArduPilot's vibration logs.

### Payload and flight time (estimates)

Hover power for fixed props grows with mass to the power 1.5, by momentum theory. The anchor is Holybro's **18 minutes' hover with no payload on a 4S 5,000 mAh pack** ([Holybro](https://holybro.com/products/px4-development-kit-x500-v2)). Holybro doesn't publish the X500's all-up weight with that pack, so it is bracketed at **3.5–4 lb** (our estimate). Reach assumes 22 mph, a 20% reserve and an out-and-back flight. Hover is the slower case, since forward flight usually costs a little less.

| Carrier | Darts | All-up (kg) | Hover (min) | Line reachable, km out |
|---|---|---|---|---|
| **X500 + v2 harness, v2 darts** | 2 | 1.93–2.13 | 13.6–14.0 | 3.3–3.4 |
| **X500 + v2 harness, v2 darts** | 3 | 2.06–2.26 | 12.3–12.8 | 3.0–3.1 |
| **X500 + v2 harness, v2 darts** | 4 | 2.18–2.38 | 11.3–11.8 | 2.7–2.8 |
| X500 + v0 harness, v1 darts | 2 | 2.14–2.34 | 11.7–12.2 | 2.8–2.9 |
| X500 + v0 harness, v1 darts | 3 | 2.33–2.53 | 10.2–10.8 | 2.5–2.6 |
| X500 + v0 harness, v1 darts | 4 | 2.52–2.72 | 9.1–9.7 | 2.2–2.3 |
| Printed TL-1, v1 darts | 2 | 1.76–1.96 | 15.6–15.9 | 3.7–3.8 |
| Printed TL-1, v1 darts | 3 | 1.95–2.15 | 13.3–13.8 | 3.2–3.3 |
| Printed TL-1, v1 darts | 4 | 2.15–2.35 | 11.6–12.1 | 2.8–2.9 |

**What this changes:**

- A unit's net takes about 22 darts and 7 sorties of up to 4 to lay, about 1.4 h with 6 packs and a 2-channel charger ([lay model]({{ site.baseurl }}{% link models/line-layout.md %}#laying-the-net)). With GPS jammed it is a daylight job: the optical-flow sensor needs to see the ground.
- Lines 2.5 mi out need the TL-1 with 2 darts, or a fixed-wing carrier. Printed fixed-wing airframes such as Eclipson's take off at 1.1–3.3 lb ([air-rc](https://www.air-rc.com/aircraft/Eclipson-Airplanes_Apex_apex)) but publish no payload or endurance, so a fixed-wing stays unscoped until T13 shows whether 1.9 mi is enough.
- T13 now has a prediction to beat: **X500, 4 v2 darts, about 11–12 minutes' hover.** The v2 rows use the model's masses: 4.4 oz per dart, 2.8 oz for the harness.

</details>

<details class="layer" id="6-parts-to-buy-v3-4-darts-and-the-harness" markdown="block">
<summary><span class="layer-title">6. Parts to buy: v3, 4 darts and the harness</span><span class="layer-sub">Every part with a checked price and an alternative, about $50</span></summary>

Every Amazon listing was opened in a browser on 2026-10-15 and showed Add to Cart at the price given. Electronics already on the [MVP list]({{ site.baseurl }}{% link mvp.md %}#shopping-list) (Heltec boards, INMP441) are not repeated.

| Qty | Part | Buy | Alternative | Price |
|---|---|---|---|---|
| 1 | PETG 0.069 in, 2.2 lb (plate, rotor and 4 darts use about 8.8 oz, est.) | [SUNLU, Amazon](https://www.amazon.com/dp/B0DJS3PJVX) | [Overture, Amazon](https://www.amazon.com/dp/B0991YSBDG), $17.99 | $13.99 |
| 1 | Solid fibreglass rod, 0.24 in × 20 in, 10-pack (one rod per dart) | [LLZZQQF, Amazon](https://www.amazon.com/dp/B0FNZQLH1P) | [0.24 × 17 in 10-pack, Amazon](https://www.amazon.com/dp/B0CGLMZSTG), $9.99; mic about 17 in | $11.00 |
| 1 | SG90 servo, 2-pack (one fitted, one spare) | [Amazon](https://www.amazon.com/dp/B0DFKPVRC2) | [Beffkkip 3-pack, Amazon](https://www.amazon.com/dp/B0G6R7ZZXH), $6.99 | $4.99 |
| 4 | 18650 cells (not on Amazon) | [Samsung 25R, 2,500 mAh, 18650 Battery Store](https://www.18650batterystore.com/products/samsung-25r-18650) | [Samsung 35E, 3,500 mAh](https://www.18650batterystore.com/collections/18650-batteries), $5.99; [Molicel P28A](https://www.18650batterystore.com/products/molicel-p28a), $5.99 | $4.99 each |
| | **Total** (CA glue assumed owned) | | | **≈ $50** |

**Where v2's $13 went:** the foam ($4.99), a cheaper spool of the same PETG ($4.00 less), and cheaper cells ($4.00 less for four). If T11 shows foam is needed: [Phinus 10-pack, Amazon](https://www.amazon.com/dp/B07X4VKKQ7), $4.99.

**Where v1's $76 went (v1 to v2):** the folding mast (pole kit $29.95, springs $10.99, M3 hardware $15.89), the steel spike ($9.99), three of four servos (a 2-pack replaces a 10-pack), and fur (foam instead). v1's list was PETG, a 10-pack of SG90s, the pole kit, stainless rod, springs, M3 hardware, fur and cells, ≈ $139.

</details>

<details class="layer" id="7-not-yet-designed" markdown="block">
<summary><span class="layer-title">7. Not yet designed</span><span class="layer-sub">Tip dart, solar on the pod, post, base box, edge receiver, custom board</span></summary>

- **Tip dart:** a dart body that also carries a spool of about 1.2 mi of FPV fibre and a small laser, about 10 oz (est.), from [the fibres and the base box]({{ site.baseurl }}{% link models/line-layout.md %}#the-fibres-and-the-base-box). The harness slot has to take its weight and let the fibre pay out freely from the first drop. It follows T21's bench version.
- **Solar on the head pod:** a 2.4 × 2.4 in epoxy panel lying flat on top of the pod, matte so it doesn't glint to a drone overhead, and a charger chip with a thermistor that stops charging below 32°F ([why]({{ site.baseurl }}{% link costs.md %}#keeping-it-up)). About 0.4 oz at the tail moves the balance point back, against the point-first fall, so `v3.py` has to place the hanger post again with it fitted, and T10 drops darts with it.
- **Post:** a stake mount for a dart's board, 4 cells, a 2 ft whip and a 1 W solar panel tilted toward the sun ([Guarding a road]({{ site.baseurl }}{% link models/route-guard.md %}#the-parts)).
- **Base box:** a small box for a receive-only Heltec, two light detectors with fibre connectors and an RS-485 module, on the unit's power.
- **Edge receiver mount,** only where fibre can't go: a pole-top box for a receive-only Heltec, an RS-485 module and a Yagi clamp, from the [edge receiver design]({{ site.baseurl }}{% link models/tripwire.md %}#getting-alerts-out-of-the-trees). It follows T17's bench version.
- **X500 leg extensions:** only for v1 darts; v2 darts ride high enough for stock legs.
- **TL-1 with the v2 plate:** the hull still carries v1's release blocks and tall legs.
- **A custom listener board:** it shrinks the head pod and fixes the sleep current (see [wake-on-sound]({{ site.baseurl }}{% link build-software.md %}#listener-firmware)).

</details>

<details class="layer" id="files" markdown="block">
<summary><span class="layer-title">Files</span><span class="layer-sub">Every CAD script and its STL, STEP and renders</span></summary>

| Model | Script | Printable outputs (STL and STEP) | Render |
|---|---|---|---|
| Dart | [`cad/dart.py`](https://github.com/paulrenzi/tripwire/blob/main/cad/dart.py) | `dart_body`, `dart_cap`, `dart_hinge`, `dart_pod` | `dart-deployed.png`, `dart-stowed.png` |
| **v3 dart** | [`cad/v3.py`](https://github.com/paulrenzi/tripwire/blob/main/cad/v3.py) | `v3_dart_body`, `v3_dart_pod` (harness: v2's `v2_plate`, `v2_rotor`) | `v3-harness.png`, `v3-body.png`, `v3-dart.png` |
| v2 dart and harness | [`cad/v2.py`](https://github.com/paulrenzi/tripwire/blob/main/cad/v2.py) | `v2_dart_body`, `v2_dart_clip`, `v2_dart_pod`, `v2_plate`, `v2_rotor` | `v2-harness.png`, `v2-rotor.png`, `v2-dart.png` |
| X500 harness v1 | [`cad/harness_simple.py`](https://github.com/paulrenzi/tripwire/blob/main/cad/harness_simple.py) | `harness_simple_plate`, `dart_cap` (notched) | `harness-simple.png`, `harness-simple-latch.png` |
| X500 harness v0 (fallback) | [`cad/harness.py`](https://github.com/paulrenzi/tripwire/blob/main/cad/harness.py) | `harness_plate`, `harness_saddle`, `harness_release_block` | `harness-x500.png`, `harness-x500-close.png` |
| TL-1 | [`cad/quad.py`](https://github.com/paulrenzi/tripwire/blob/main/cad/quad.py) | `quad_hull`, `quad_arm`, `quad_leg` | `quad-tl1.png` |
| Shared | [`cad/params.py`](https://github.com/paulrenzi/tripwire/blob/main/cad/params.py), [`cad/render.py`](https://github.com/paulrenzi/tripwire/blob/main/cad/render.py) | | |

STL and STEP files are in [`cad/out/`](https://github.com/paulrenzi/tripwire/tree/main/cad/out).

</details>
