paulrenzi/drone-detection-research/build-3d.md

---
title: "3D models and downloads"
nav_primary: 2
---

# 3D models and downloads
{: .no_toc }

<p class="vz-lede">Models of the hardware: one listener, the <strong>dart</strong>; the <strong>harness</strong> that drops four of them from an X500; and a <strong>stake</strong> for placing one by hand. Each model below plays its own assembly; drag to turn it.</p>

<div class="stats">
  <div class="stat"><p class="stat-num">5.9 oz</p><p class="stat-label">one dart, from the model's geometry</p></div>
  <div class="stat"><p class="stat-num">1.9 lb</p><p class="stat-label">four darts and the harness: the X500's payload</p></div>
  <div class="stat"><p class="stat-num">19.7 in</p><p class="stat-label">mic above the ground, dart or stake</p></div>
  <div class="stat"><p class="stat-num">0</p><p class="stat-label">printed, dropped or flown yet</p></div>
</div>

<details class="layer" markdown="block">
<summary><span class="layer-title">About these models</span><span class="layer-sub">How the viewer works, and what is computed rather than measured</span></summary>

The [tripwire]({{ site.baseurl }}{% link index.md %}) depends on a drone carrying listeners forward and dropping them so they stand up and listen. These are the models of that hardware: one listener (the **dart**), the **harness** that holds and releases four of them, both on a Holybro X500, and a **stake mount** for placing a listener by hand. Each model plays its assembly on its own: press **Pause** to stop it, then rotate, zoom, or drag the slider to take it apart by hand. Point at a part to name it; click it for its mass and what it does. Every printed part is [downloadable](#8-downloads) as STL and STEP.

{: .warning }
> **A computer model, not a tested design.** Nothing here has been printed, assembled, dropped or flown. The bought parts are the manufacturers' own CAD where it exists (the X500 frame, the Seeed XIAO ESP32S3 and Wio-SX1262 boards), and every other dimension comes from a datasheet or is flagged *measure*. Masses are computed from the model's geometry. The open question is whether a dart released sideways from the drone turns nose-down and sticks in soil with the microphone working, and no model answers it. The weighted [dummy](#5-the-drop-test-dummy) dropped from the drone does.

</details>

<script type="importmap">
{ "imports": {
  "three": "https://cdn.jsdelivr.net/npm/three@0.170.0/build/three.module.js",
  "three/addons/": "https://cdn.jsdelivr.net/npm/three@0.170.0/examples/jsm/"
} }
</script>
<script type="module" src="{{ site.baseurl }}/assets/js/cad-viewer.js"></script>

{% assign web = site.baseurl | append: "/cad/gpt61/web/" %}

## 1. One dart

**A rod, a body and a pod.** The cell sits near the tip, the board and mic in the pod at the top, and four fins steer it point-first as it falls.

<details class="layer" markdown="block">
<summary><span class="layer-title">The detail</span><span class="layer-sub">Parts, masses, the balance point, and why it should fall point first</span></summary>

A 0.24 × 20 in fibreglass rod is the spike, the spine and the mast. Three printed parts sit on it. The **body**, near the tip, holds the 18650 cell in snap fingers and carries the hanger post the harness grips. The **pod**, on the top end, is a small tray and a screwed lid. It holds the XIAO ESP32S3 with the Wio-SX1262 radio board plugged on top, the microphone behind a side port, and the kit's two flat antennas: the LoRa one on a strip that runs past the pod, the WiFi one inside. Between them, the **tail**: four thin fins on two collars glued to the rod, to make the dart fall point first. Two wires run along the rod from the cell to pads under the XIAO.

The pod has no screen and no status light. The listener reports by radio once a minute that it is alive. A small printed **cap** on the pod's end comes off to reach the USB-C port for flashing, and a pin through the same opening presses BOOT or RESET, so the lid stays shut.

The model lies flat, the way it is carried. Exploded, the body slides off toward the tip and the pod slides off the rod end. The cell and the lid lift away, and the screws, inserts, seals and foam pads separate so each can be seen.

- **Model mass: 5.9 oz,** of which the tail is 0.64 oz. The cell is 1.6 oz (datasheet maximum), the body 1.5 oz, the rod 0.93 oz, the pod tray, lid and cap 0.90 oz, the two boards 0.14 oz, and screws, wire, antennas and seals the rest. Printed masses assume solid PETG at 100% infill. Nothing has been weighed.
- **The hanger is at the model's balance point,** 10.9 in from the tip and offset 0.24 in toward the cell, because the cell sits beside the rod and not on it.
- **Standing in soil,** the tip goes in 2.8 in and the sound port is 19.7 in above the ground. The whole dart is 27 in from tip to antenna. The LoRa antenna's size is a placeholder until the real one is measured, and it is why the dart is longer than before.

### Why it should fall point first

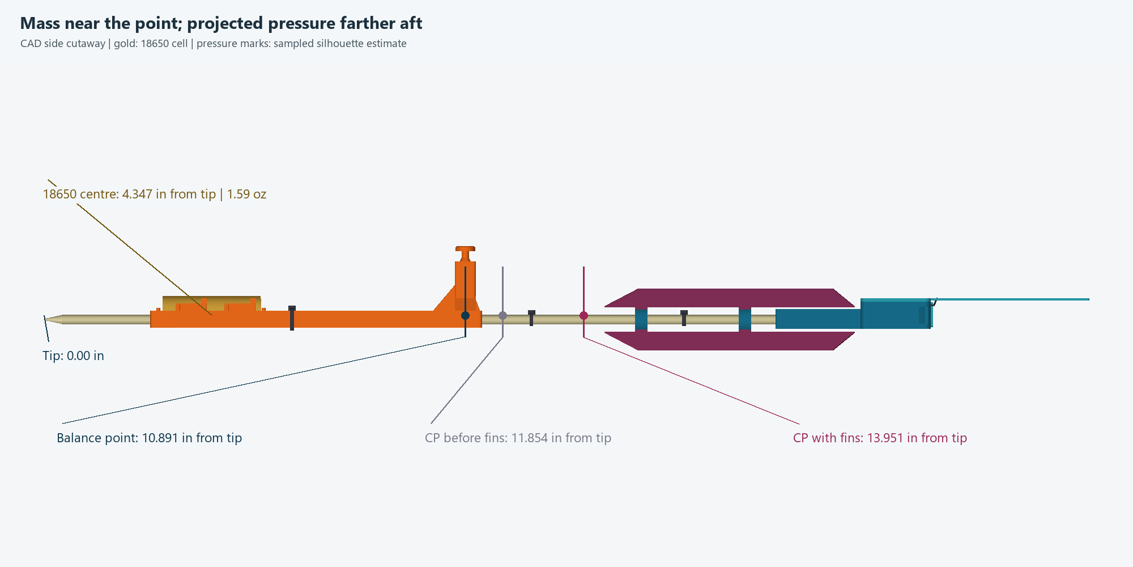
[picture p76: cad/gpt61/renders/dart_balance.png]
Side cutaway of the dart, tip on the left: the 18650 cell in gold near the tip, the balance point at 10.891 in, the centre of pressure at 11.854 in without fins and 13.951 in with them, and the four fins farther back toward the pod


A dart steers itself the way a lawn dart or a shuttlecock does. Its weight sits near the point, and the air pushes hardest on it farther back, so a tilted dart is turned point-first by the air it falls through. The farther back that push sits behind the balance point, the stronger the turn. Most of the weight is the 18650 cell, which sits in the body near the tip, 4.3 in from it.

| GPT-6.1's estimate | Without fins | With fins |
|---|---|---|
| Dart mass | 5.22 oz | 5.91 oz |
| Balance point, from the tip | 10.02 in | 10.89 in |
| Centre of air pressure, from the tip | 11.85 in | 13.95 in |
| Gap between them | 1.84 in, 1.25 body widths | 3.06 in, 2.08 body widths |

- **The fins:** four trapezoids, 6.46 in long and 0.59 in tall, 0.047 in thick, keyed into two printed collars and glued to the rod. They are long and low because there is no room for taller ones: the closest a fin comes to the next dart's pod during release is 0.056 in. They print flat, without supports. Being glued, they come off only by breaking the bond.
- **The target was 2 body widths** of gap, and the fins reach 2.08. That is a rule of thumb for a clear margin, not a proven requirement. The estimate treats the dart's side view as a cardboard cut-out with even pressure on it, not a wind-tunnel number.
- **The dart is still carried flat,** hung at its balance point. Hanging it off the balance point would start it tilted, but it would tilt the wrong way if hung toward the point: the point rises, not falls. Hung toward the tail, the point drops, but either offset jams the hanger's head against the release rotor. So it leaves level and the air has to turn it, and how soon is not known.

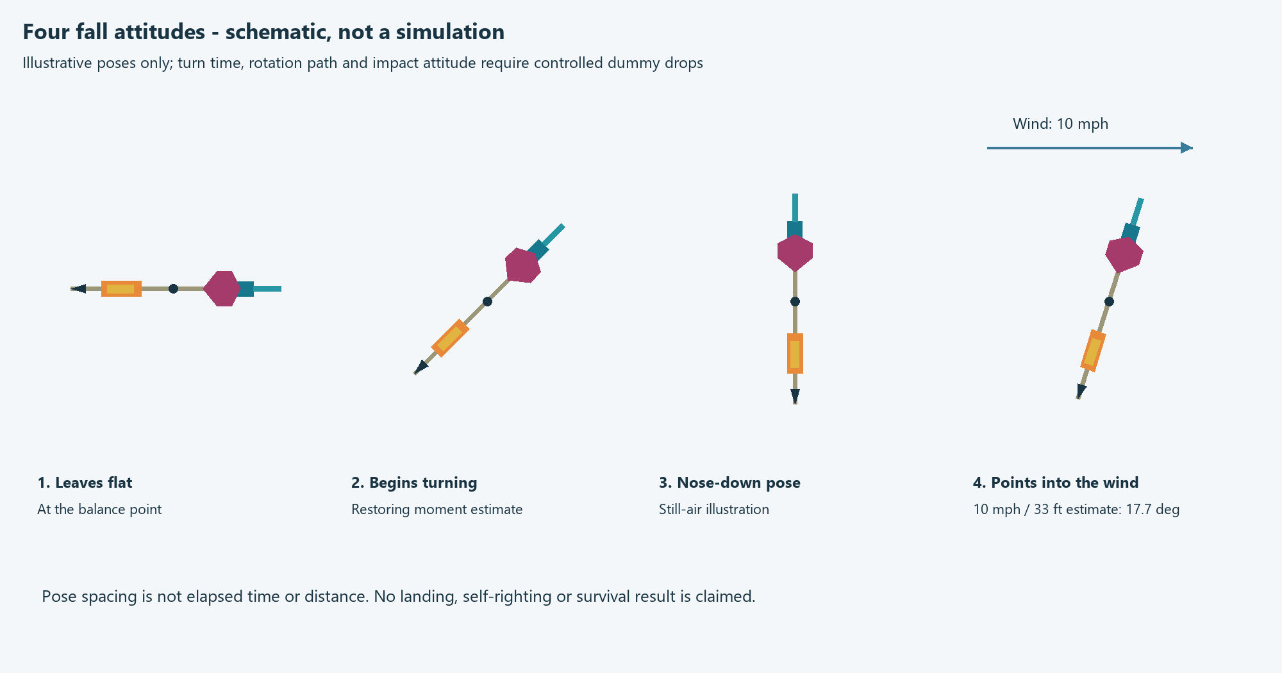
[picture p77: cad/gpt61/renders/dart_fall_sequence.png]
Schematic, not a simulation: the dart leaving flat, turning, nose-down in still air, and tilted about 18 degrees into a 10 mph wind


**In wind it lands tilted.** A finned dart points along the air it falls through, so in a crosswind the point leans upwind. Ignoring drag, the lean from vertical is about:

| Drop | 5 mph wind | 10 mph wind | 15 mph wind |
|---|--:|--:|--:|
| 16 ft | 13° | 25° | 34° |
| 33 ft | 9° | 18° | 26° |
| 49 ft | 7° | 15° | 21° |

That is arithmetic, not a test. Drag slows the fall, which steepens the lean, but it also carries the dart downwind, which reduces it, and which wins needs a real drop. The fins may also not finish turning the dart in a short drop. None of this shows that a dart lands upright or survives landing: the [dummy](#5-the-drop-test-dummy), with the same fins, is what will tell.

</details>

## 2. The harness, loaded with four darts

**One servo, one rotor.** Each 16° step lines a gap in the rotor up with one dart's head, and that dart drops.

<details class="layer" markdown="block">
<summary><span class="layer-title">The detail</span><span class="layer-sub">How it releases, masses, and what still has to be measured</span></summary>

One printed plate is zip-tied to the X500's two payload rails at four saddles. An SG90 servo hangs under the plate and turns a printed **rotor** on top of it. Each dart's hanger post comes up through a slot in the plate, and its round head rests on the rotor's rim. The rim has four gaps at different angles. Each 16° servo step lines one gap up with one head, and that dart drops: the inner pair first, then the outer pair.

The darts' weight bears on a ridge on the plate, faced with PTFE tape, not on the servo. A loose keeper washer above the rotor stops it lifting off. Exploded, the keeper lifts first, then the rotor and the servo horn. The servo drops below the plate and the four darts drop below that in two tiers. The harness itself did not change for the new board; its fits were rechecked against the finned darts and their moved hangers.

- **Model mass: 6.5 oz without darts**: plate 4.6 oz, rotor 1.4 oz, servo and horn about 0.32 oz (catalogue), plus fasteners and ties.
- **Four darts plus the harness: 1.9 lb** (1.88 lb), up from 1.7 lb before the fins. That is the payload the X500 has to carry on top of its own battery and avionics. Whether it carries it well is a flight test, not a model result.
- **The rotor's fit and the servo's torque are calculations.** The real breakaway torque has to be measured with the PTFE tape and all four darts loaded. Stall torque is not a torque a servo can hold continuously.

</details>

## 3. On the drone

**Nothing overlaps when carried.** The lowest dart rides 3.7 in above the ground on stock skids; the fall itself is untested.

<details class="layer" markdown="block">
<summary><span class="layer-title">The detail</span><span class="layer-sub">The clearance checks and what the model does not show</span></summary>

The Holybro X500 V2 is the manufacturer's own STEP model, simplified for the web. The translucent discs are the propellers' swept area, used for the clearance check, not blade models. Exploded, the whole payload lowers 16 in clear of the airframe, then opens as in the harness view.

- **In the carried state nothing overlaps:** darts, frame, rails, clamps, motors, prop discs, landing legs or each other, at the nominal dimensions. The lowest dart is 3.7 in above the ground plane of the stock skids.
- **The model checks a clear path out, not the fall.** It checks each dart, fins included, sliding 3.5 in straight down through its gap, and a nose-down rotation once a dart is 17 in below the drone. It does not show that a real dart waits that long before it tips, or that it lands upright. The fins' [estimate](#why-it-should-fall-point-first) is the only word on the fall so far.

</details>

## 4. The stake listener

**The same pod on a 48 in garden stake,** for placing a listener by hand with no drone.

<details class="layer" markdown="block">
<summary><span class="layer-title">The detail</span><span class="layer-sub">The stake adapter, cell holder and mass</span></summary>

For placing a listener by hand, with no drone. The same pod, board and cell go on a 48 in fibreglass garden stake from a hardware store. A printed **stake adapter** holds the pod: two V-shaped saddles and zip ties grip any stake from 0.31 to 0.51 in across, so the stake's exact size doesn't matter. A 1.6 in offcut of the dart rod plugs the adapter into the pod's usual socket. A separate printed **cell holder**, tied lower on the stake, holds the 18650, wired to the board as in the dart.

Push the stake in by hand, then slide the adapter until the microphone is 19.7 in above the ground; how deep the stake goes doesn't change that. Exploded, the pod pulls off its offcut.

- **Model mass: 10.9 oz** for the whole installation, stake and cell included. Nothing on the stake flies, so this is not drone payload.

</details>

## The details

Each section opens for the full reasoning, numbers and sources.

<button type="button" class="layer-toggle" data-layers-toggle>Open all sections</button>

<details class="layer" id="5-the-drop-test-dummy" markdown="block">
<summary><span class="layer-title">5. The drop-test dummy</span><span class="layer-sub">An inert dart ballasted to the real one's mass and balance, for the first drops</span></summary>

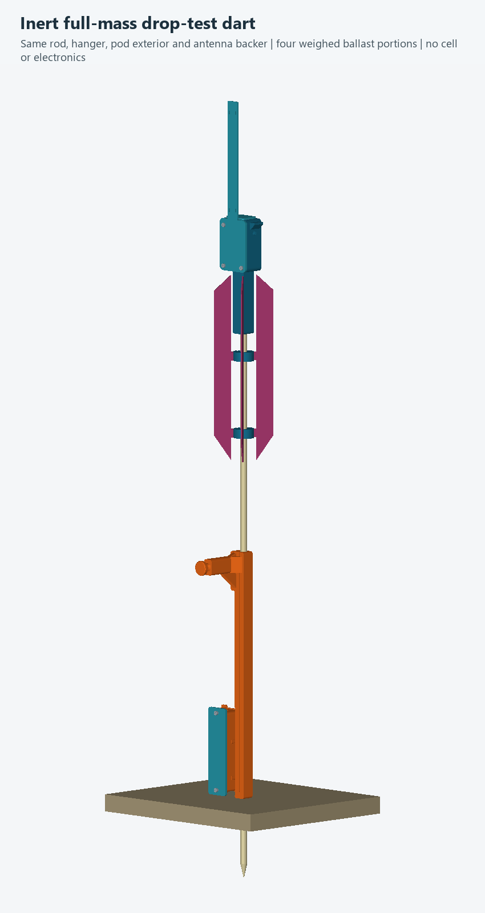
[picture p78: cad/gpt61/renders/dummy_assembled.png]
The inert dummy dart standing in soil: the same rod, hanger and pod as a real dart, with a ballast box where the cell would be


The first test is a drop, and a dummy is cheaper to break. It uses the same rod, hanger, fins, pod shell, lid, cap and antenna strip as a real dart, with no cell, board or microphone. Steel ballast in four printed pockets, two in the body and two in the pod, brings it to the real dart's mass and balance point.

- **Ballast: 1.3 oz of steel** in all, weighed out into four portions (nuts or washers work), held still with foam. The empty dummy is 4.6 oz; with ballast it matches the real dart's 5.9 oz and its balance point.
- **Weigh the printed dummy first,** then re-solve the ballast with the real numbers. The model's match is only as good as its estimates.
- **What the drops answer:** whether the dart turns nose-down, when it starts to turn, whether it sticks, and whether the snaps, post and rod survive.

</details>

<details class="layer" id="6-every-part" markdown="block">
<summary><span class="layer-title">6. Every part</span><span class="layer-sub">Each part, its material and its mass</span></summary>

Masses are the model's estimates. A dash means no separate figure: the servo and its horn share one 0.32 oz catalogue mass. **Bought** parts are the manufacturer's CAD where one exists and a datasheet build otherwise; **printed** parts are modelled from scratch.

**Per dart**

| Part | Printed or bought | Mass (oz) | Geometry from | What it does |
|---|---|---|---|---|
| Body, with cell snaps and hanger | printed | 1.50 | modelled | Holds the cell and the rod, and carries the dart's weight through its hanger post |
| Pod tray | printed | 0.67 | modelled | Holds the boards, the rod socket and the microphone cavity |
| Pod lid, with the antenna strip | printed | 0.20 | modelled | Closes the pod, holds the boards down through foam pads, and carries the LoRa antenna |
| USB cap | printed | 0.03 | modelled | Covers the end opening for USB-C and the BOOT and RESET buttons |
| Fibreglass rod, 0.24 × 20 in | bought | 0.93 | modelled to spec | Spike, spine and mast |
| Samsung INR18650-25R cell | bought | 1.59 | datasheet | Power |
| Seeed XIAO ESP32S3 | bought | 0.08 | Seeed STEP | Microcontroller, WiFi and battery charger |
| Seeed Wio-SX1262 for XIAO | bought | 0.06 | Seeed STEP; plug-in spacing *measure* | LoRa radio |
| INMP441 microphone breakout | bought | 0.04 | chip from datasheet; breakout board *measure* | Listens through the side port |
| LoRa and WiFi antennas, with leads | bought | 0.04 | *measure*: no dimensioned drawing found | The kit's two flat antennas |
| 3 heat-set inserts and 3 M2 × 6 screws | bought | 0.05 | Ruthex STEP; screws modelled | Hold the lid on |
| Lid seal cord, mic film and mic seal | bought | 0.01 | modelled to the TDK sealing note | Seal the pod; not tested for water or sound |
| 2 power wires, 5 mic wires, 2 cell tabs | bought | 0.05 | modelled | Power from the cell; microphone to the board |
| 3 zip ties | bought | 0.02 | HellermannTyton datasheet | Hold the wires to the rod |
| 4 foam pads | bought | 0.00 | modelled | Cushion the boards |
| 4 tail fins | printed | 0.49 | modelled | Move the air's push behind the balance point, so the dart falls point first |
| 2 tail collars | printed | 0.13 | modelled | Hold the fins at their angles on the rod |
| Glue for the tail | bought | 0.02 | allowance, *measure* | Bonds the collars and fin tabs to the rod |
| **Dart total** | | **5.91** | | |

**Harness**

| Part | Printed or bought | Mass (oz) | Geometry from | What it does |
|---|---|---|---|---|
| Plate with four rail saddles | printed | 4.64 | modelled | Carries the four darts and ties to the payload rails |
| Release rotor | printed | 1.36 | modelled | Holds the dart heads up and uncovers them one at a time |
| TowerPro SG90 servo and stock horn | bought | – | drawing and photo; spline *measure* | Turns the rotor; driven from Pixhawk AUX 1 |
| Keeper screw, spacer and washer | bought | 0.02 | modelled | Stop the rotor lifting off |
| 2 drive pins and 4 nuts | bought | 0.04 | modelled | Couple the servo horn to the rotor |
| 2 servo screws and 2 captive nuts | bought | 0.03 | modelled | Hold the servo under the plate |
| Servo lead and plug | bought | 0.02 | modelled | Servo power and signal |
| 4 rail zip ties | bought | 0.04 | HellermannTyton datasheet | Tie the saddles to the rails |
| PTFE film on the bearing ridge | bought | 0.01 | 3M datasheet | Low-friction face for the rotor |
| **Harness total** (with the servo's 0.32 oz) | | **6.47** | | |

</details>

<details class="layer" id="7-what-the-model-does-and-does-not-show" markdown="block">
<summary><span class="layer-title">7. What the model does and does not show</span><span class="layer-sub">What is computed, what is measured, and what only a test can say</span></summary>

**What it shows:** every part at a sourced or flagged size, fitting together without overlap in the carried, releasing and standing states, on the stake, and with the dummy's ballast in its pockets. Those are GPT-6.1's 164 generated checks, and they test the model against itself. It also shows the order the parts go together, and a mass for everything.

**What it does not show:**

- **That a dart lands upright.** The darts are carried flat. The fins come with an estimate of where the air pushes, not a model of the fall: nothing here shows the turn nose-down, how long it takes, or 2.8 in of rod going into real soil. This is the first test: print the [dummy](#5-the-drop-test-dummy) and drop it from the drone's release height again and again.
- **That the microphone hears a drone through the pod.** The side port, film and cavity are built from TDK's sealing guidance, but they have never been recorded through.
- **That the pod keeps water out.** It is a printed box with a cord seal and a sealed cap. The seal's squeeze is calculated, not tested.
- **That the X500 flies well with 1.9 lb under it.**
- **About 60 dimensions marked *measure*:** how far apart the two boards sit when plugged together, the antennas, the microphone breakout, the servo's spline and screw thread, and the print fits. They have to be checked with calipers on the bought parts and a printed fit coupon before the real print.
- **The animation is an assembly diagram.** It slides rigid parts apart. It does not show screws turning, ties being cut, inserts being heated in, or the servo's real release sequence.

</details>

<details class="layer" id="8-downloads" markdown="block">
<summary><span class="layer-title">8. Downloads</span><span class="layer-sub">STL, STEP and GLB files, with sources and provenance</span></summary>

<p><a class="cad-btn cad-download" href="{{ site.baseurl }}/cad/gpt61/out/print-kit.zip" download>Download the print kit (.zip, 2.4 MB)</a></p>

The print kit holds the STL and STEP for all fourteen printed parts, the print settings ([`print_manifest.json`](https://github.com/paulrenzi/tripwire/blob/main/cad/gpt61/out/print_manifest.json)), the design notes, the mass table and the 164 checks. **Print the fit coupon first** and check it against the bought parts with calipers: about 60 dimensions are still marked *measure*. Four darts and the harness take 42 printed pieces, 24 of them fins and collars; the stake and dummy parts are optional.

| Printed part | Mass (oz) | Print | Edit |
|---|--:|---|---|
| Dart body | 1.45 | <a href="{{ site.baseurl }}/cad/gpt61/out/body.stl" download>body.stl</a> | <a href="{{ site.baseurl }}/cad/gpt61/out/body.step" download>body.step</a> |
| Pod tray | 0.67 | <a href="{{ site.baseurl }}/cad/gpt61/out/pod_shell.stl" download>pod_shell.stl</a> | <a href="{{ site.baseurl }}/cad/gpt61/out/pod_shell.step" download>pod_shell.step</a> |
| Pod lid | 0.20 | <a href="{{ site.baseurl }}/cad/gpt61/out/pod_lid.stl" download>pod_lid.stl</a> | <a href="{{ site.baseurl }}/cad/gpt61/out/pod_lid.step" download>pod_lid.step</a> |
| USB cap | 0.03 | <a href="{{ site.baseurl }}/cad/gpt61/out/usb_cap.stl" download>usb_cap.stl</a> | <a href="{{ site.baseurl }}/cad/gpt61/out/usb_cap.step" download>usb_cap.step</a> |
| Tail fin (16 for four darts) | 0.12 | <a href="{{ site.baseurl }}/cad/gpt61/out/tail_fin.stl" download>tail_fin.stl</a> | <a href="{{ site.baseurl }}/cad/gpt61/out/tail_fin.step" download>tail_fin.step</a> |
| Tail collar (8 for four darts) | 0.07 | <a href="{{ site.baseurl }}/cad/gpt61/out/tail_collar.stl" download>tail_collar.stl</a> | <a href="{{ site.baseurl }}/cad/gpt61/out/tail_collar.step" download>tail_collar.step</a> |
| Harness plate | 4.64 | <a href="{{ site.baseurl }}/cad/gpt61/out/plate.stl" download>plate.stl</a> | <a href="{{ site.baseurl }}/cad/gpt61/out/plate.step" download>plate.step</a> |
| Release rotor | 1.36 | <a href="{{ site.baseurl }}/cad/gpt61/out/rotor.stl" download>rotor.stl</a> | <a href="{{ site.baseurl }}/cad/gpt61/out/rotor.step" download>rotor.step</a> |
| Fit coupon (print first) | 0.16 | <a href="{{ site.baseurl }}/cad/gpt61/out/fit_coupon.stl" download>fit_coupon.stl</a> | <a href="{{ site.baseurl }}/cad/gpt61/out/fit_coupon.step" download>fit_coupon.step</a> |
| Stake adapter (optional) | 0.47 | <a href="{{ site.baseurl }}/cad/gpt61/out/stake_adapter.stl" download>stake_adapter.stl</a> | <a href="{{ site.baseurl }}/cad/gpt61/out/stake_adapter.step" download>stake_adapter.step</a> |
| Stake cell holder (optional) | 1.08 | <a href="{{ site.baseurl }}/cad/gpt61/out/stake_cell_holder.stl" download>stake_cell_holder.stl</a> | <a href="{{ site.baseurl }}/cad/gpt61/out/stake_cell_holder.step" download>stake_cell_holder.step</a> |
| Dummy body (optional) | 1.83 | <a href="{{ site.baseurl }}/cad/gpt61/out/dummy_body.stl" download>dummy_body.stl</a> | <a href="{{ site.baseurl }}/cad/gpt61/out/dummy_body.step" download>dummy_body.step</a> |
| Dummy lid (optional) | 0.14 | <a href="{{ site.baseurl }}/cad/gpt61/out/dummy_lid.stl" download>dummy_lid.stl</a> | <a href="{{ site.baseurl }}/cad/gpt61/out/dummy_lid.step" download>dummy_lid.step</a> |
| Dummy head insert (optional) | 0.07 | <a href="{{ site.baseurl }}/cad/gpt61/out/dummy_head_insert.stl" download>dummy_head_insert.stl</a> | <a href="{{ site.baseurl }}/cad/gpt61/out/dummy_head_insert.step" download>dummy_head_insert.step</a> |

**Bought parts** as STEP, for checking fits: <a href="{{ site.baseurl }}/cad/gpt61/out/bought_xiao_wio_stack.step" download>XIAO + Wio stack</a> (11 MB), <a href="{{ site.baseurl }}/cad/gpt61/out/bought_SG90.step" download>SG90 servo</a>, <a href="{{ site.baseurl }}/cad/gpt61/out/bought_inmp441.step" download>INMP441</a>, <a href="{{ site.baseurl }}/cad/gpt61/out/bought_18650.step" download>18650 cell</a>, <a href="{{ site.baseurl }}/cad/gpt61/out/bought_rod.step" download>rod</a>. The X500 frame is Holybro's own STEP, too large to host here.

**Assemblies** as STEP: <a href="{{ site.baseurl }}/cad/gpt61/out/dart_stood.step" download>dart standing in soil</a> (24 MB), <a href="{{ site.baseurl }}/cad/gpt61/out/stake_assembled.step" download>stake listener</a> (24 MB), <a href="{{ site.baseurl }}/cad/gpt61/out/dummy_assembled.step" download>dummy</a> (10 MB).

**The 3D models on this page**, as glTF with the explode animation: <a href="{{ site.baseurl }}/cad/gpt61/web/dart.glb" download>dart.glb</a> (3.2 MB), <a href="{{ site.baseurl }}/cad/gpt61/web/harness.glb" download>harness.glb</a> (4.1 MB), <a href="{{ site.baseurl }}/cad/gpt61/web/aircraft.glb" download>aircraft.glb</a> (19 MB), <a href="{{ site.baseurl }}/cad/gpt61/web/stake.glb" download>stake.glb</a> (3.2 MB). Any glTF viewer opens them.

### Sources and provenance

- **Viewer models:** [`dart.glb`](https://github.com/paulrenzi/tripwire/blob/main/cad/gpt61/web/dart.glb), [`harness.glb`](https://github.com/paulrenzi/tripwire/blob/main/cad/gpt61/web/harness.glb), [`aircraft.glb`](https://github.com/paulrenzi/tripwire/blob/main/cad/gpt61/web/aircraft.glb) and [`stake.glb`](https://github.com/paulrenzi/tripwire/blob/main/cad/gpt61/web/stake.glb). Each is one file with an `explode` animation. Every part is a named node, with no errors or warnings from the Khronos glTF validator. The drone and the boards are simplified for the web, so measure from the STEP files, not these.
- **Part data:** [`manifest.json`](https://github.com/paulrenzi/tripwire/blob/main/cad/gpt61/web/manifest.json) lists every node's name, source, mass and what it does, plus the open uncertainties.
- **Still renders:** [dart exploded]({{ site.baseurl }}/cad/gpt61/renders/dart_exploded.png), [pod exploded]({{ site.baseurl }}/cad/gpt61/renders/dart_exploded_pod.png), [USB access]({{ site.baseurl }}/cad/gpt61/renders/pod_usb_access.png), [harness exploded]({{ site.baseurl }}/cad/gpt61/renders/harness_exploded.png), [on the drone]({{ site.baseurl }}/cad/gpt61/renders/aircraft_exploded.png), [stake]({{ site.baseurl }}/cad/gpt61/renders/stake_assembled.png), [dummy ballast]({{ site.baseurl }}/cad/gpt61/renders/dummy_ballast_detail.png), [balance]({{ site.baseurl }}/cad/gpt61/renders/dart_balance.png), [fins]({{ site.baseurl }}/cad/gpt61/renders/dart_fins_detail.png), [fall, schematic]({{ site.baseurl }}/cad/gpt61/renders/dart_fall_sequence.png), and all 38 in [`REVIEW.html`](https://github.com/paulrenzi/tripwire/blob/main/cad/gpt61/REVIEW.html). Every label is in inches and ounces; the STL and STEP files stay in millimetres, as slicers expect.
- **Print files and design notes:** STL and STEP for every printed part, and the print settings, sources and assembly steps, in [`cad/gpt61/`](https://github.com/paulrenzi/tripwire/tree/main/cad/gpt61). Start with [`DESIGN.md`](https://github.com/paulrenzi/tripwire/blob/main/cad/gpt61/DESIGN.md).
- **Who made it:** GPT-6.1, run as an agent through the Codex CLI on 2026-10-15 and 10-16 from a written brief, and again on 2026-10-21 to rebuild it round the XIAO kit ([brief](https://github.com/paulrenzi/tripwire/blob/main/cad/gpt61/BRIEF-xiao.md)). The CAD is CadQuery (Python). Rebuild the viewer models with `cad/gpt61/web_export.py`.
- **The older designs** (v1–v3, hand-built boxes and cylinders) are on [Build: hardware]({{ site.baseurl }}{% link build-hardware.md %}). This model replaces their geometry, not their concept.

</details>
