paulrenzi/drone-detection-research/assets/images/build/harness-x500-close.png

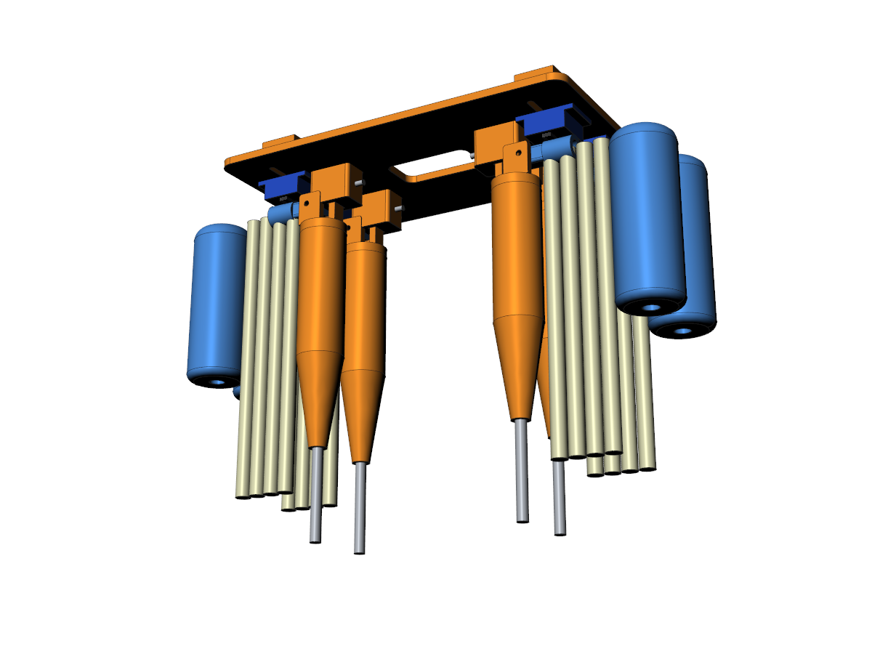
assets/images/build/harness-x500-close.png
