paulrenzi/drone-detection-research/assets/images/build/harness-x500.png

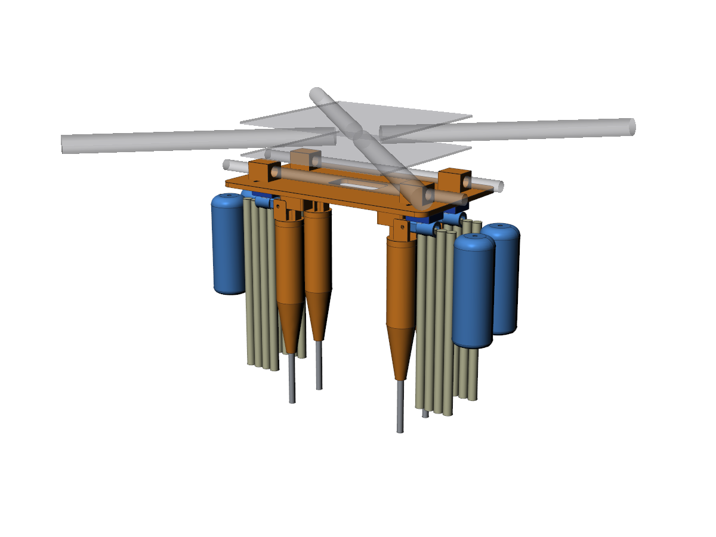
assets/images/build/harness-x500.png
