paulrenzi/drone-detection-research/cad/gpt61/renders/assembly_carried.png

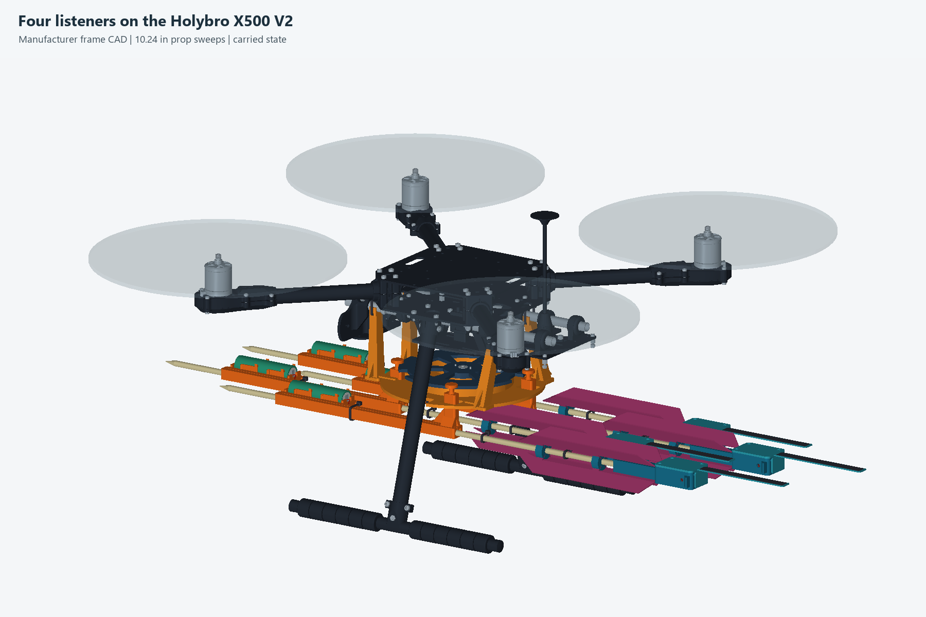
cad/gpt61/renders/assembly_carried.png
