paulrenzi/drone-detection-research/cad/gpt61/renders/assembly_mid_release.png

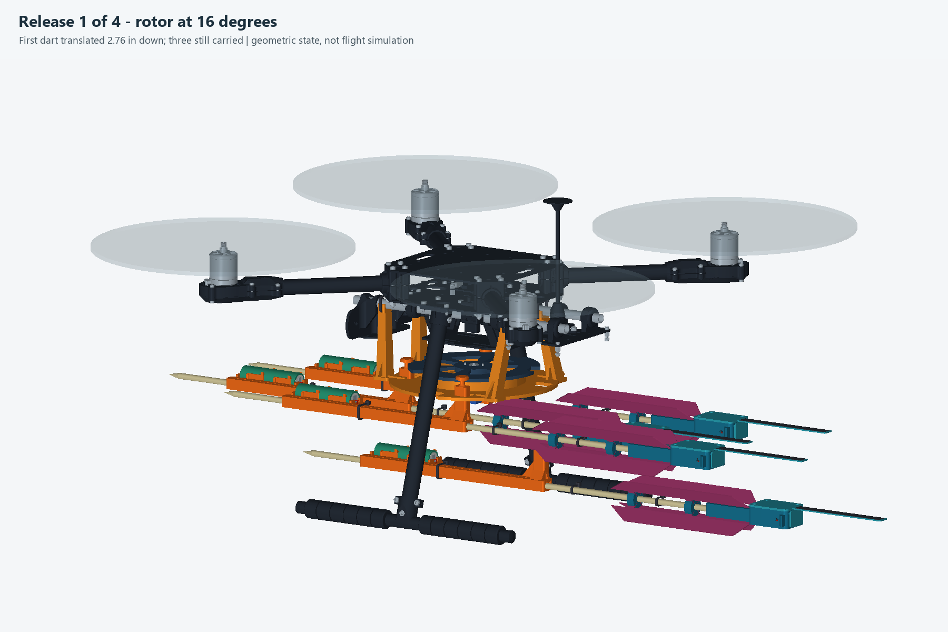
cad/gpt61/renders/assembly_mid_release.png
