paulrenzi/drone-detection-research/cad/gpt61/renders/assembly_stood.png

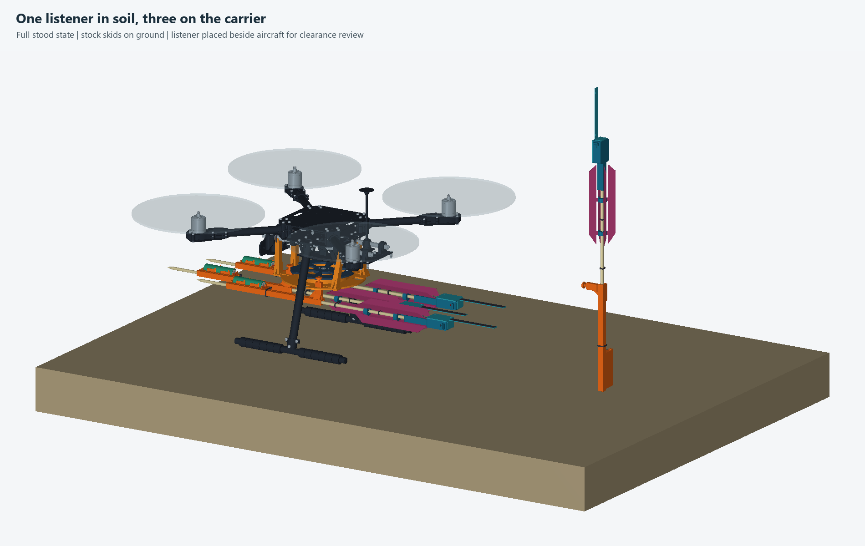
cad/gpt61/renders/assembly_stood.png
