paulrenzi/drone-detection-research/cad/gpt61/renders/print_body.png

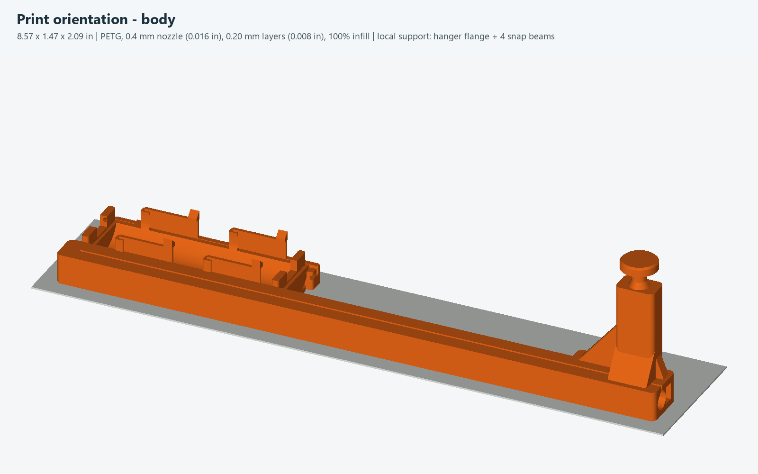
cad/gpt61/renders/print_body.png
