paulrenzi/drone-detection-research/cad/gpt61/renders/print_dummy_head_insert.png

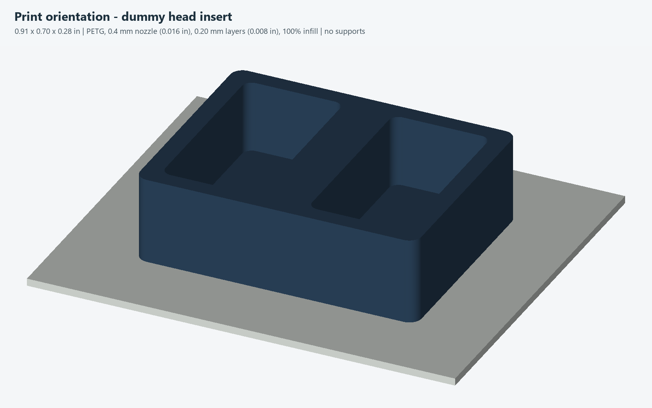
cad/gpt61/renders/print_dummy_head_insert.png
