paulrenzi/drone-detection-research/cad/gpt61/renders/print_dummy_lid.png

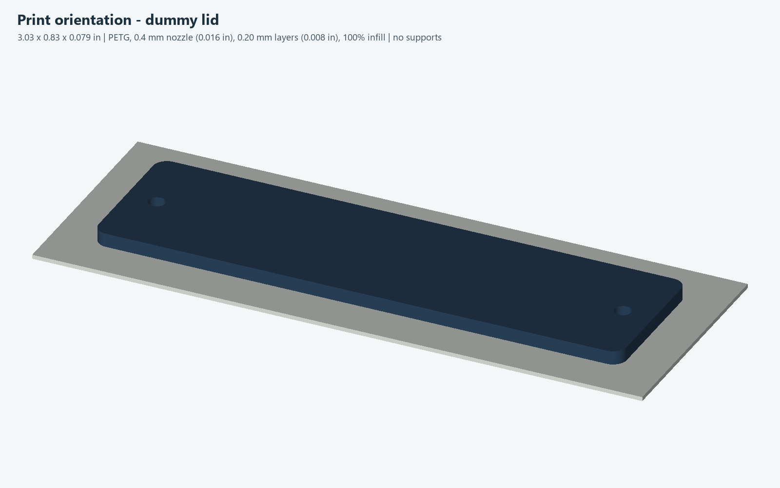
cad/gpt61/renders/print_dummy_lid.png
