paulrenzi/drone-detection-research/cad/gpt61/renders/print_fit_coupon.png

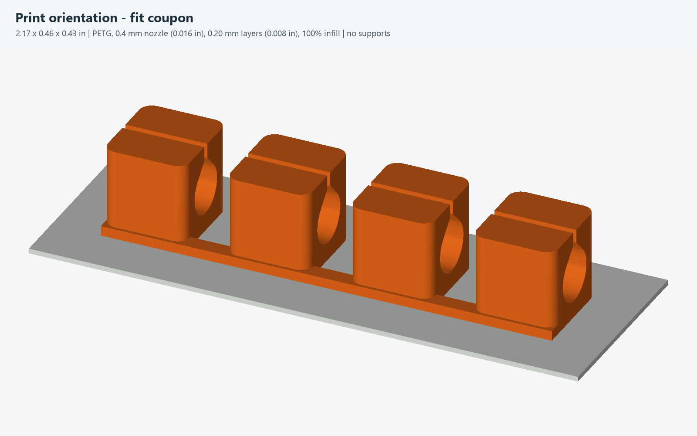
cad/gpt61/renders/print_fit_coupon.png
