paulrenzi/drone-detection-research/cad/gpt61/renders/print_plate.png

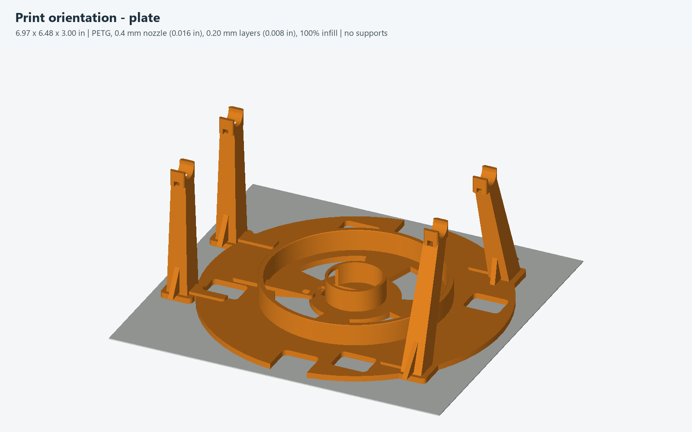
cad/gpt61/renders/print_plate.png
