paulrenzi/drone-detection-research/cad/gpt61/renders/print_pod_lid.png

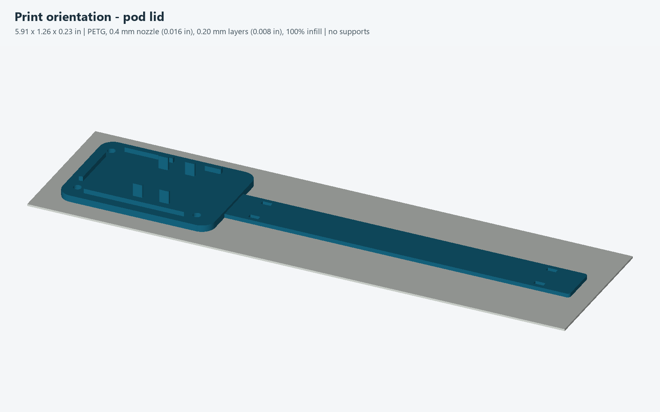
cad/gpt61/renders/print_pod_lid.png
