paulrenzi/drone-detection-research/cad/gpt61/renders/print_pod_shell.png

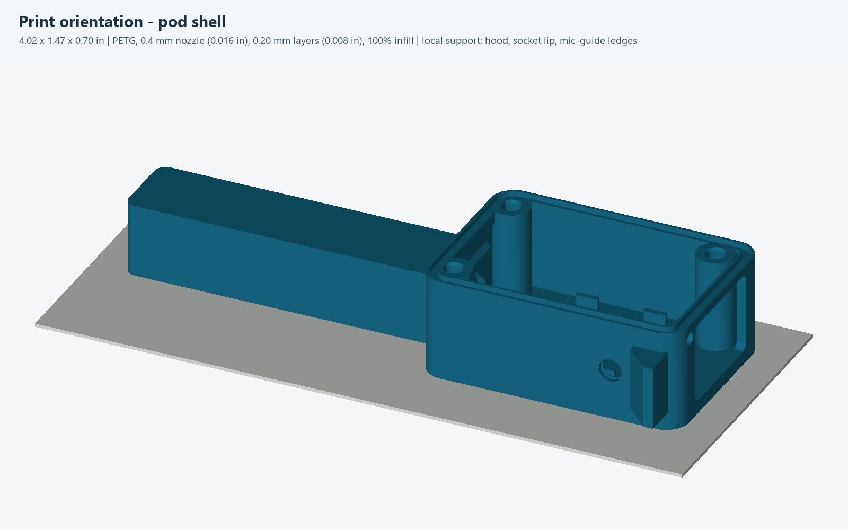
cad/gpt61/renders/print_pod_shell.png
