paulrenzi/drone-detection-research/cad/gpt61/renders/print_rotor.png

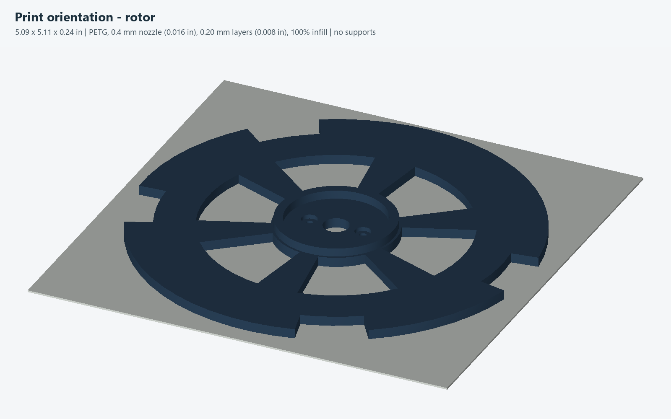
cad/gpt61/renders/print_rotor.png
