paulrenzi/drone-detection-research/cad/gpt61/renders/print_stake_adapter.png

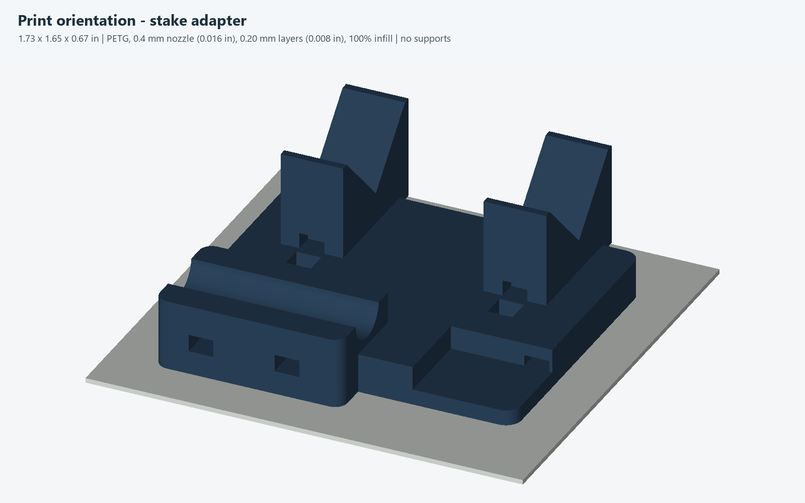
cad/gpt61/renders/print_stake_adapter.png
