paulrenzi/drone-detection-research/cad/gpt61/renders/print_stake_cell_holder.png

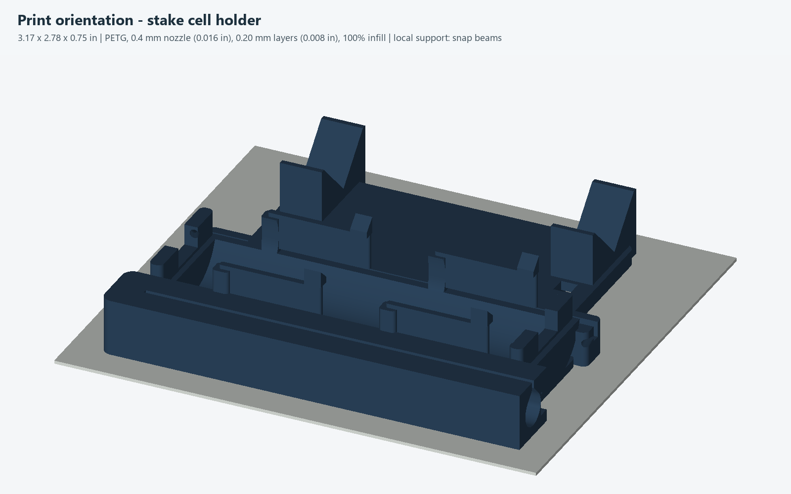
cad/gpt61/renders/print_stake_cell_holder.png
