paulrenzi/drone-detection-research/cad/gpt61/renders/print_tail_collar.png

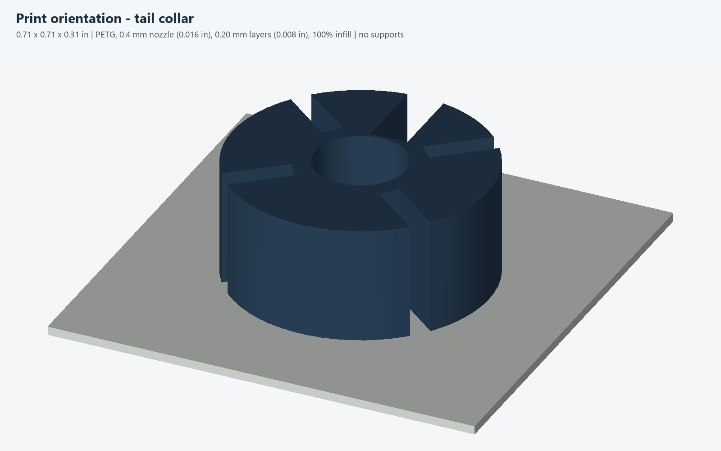
cad/gpt61/renders/print_tail_collar.png
