paulrenzi/drone-detection-research/cad/gpt61/renders/stake_assembled.png

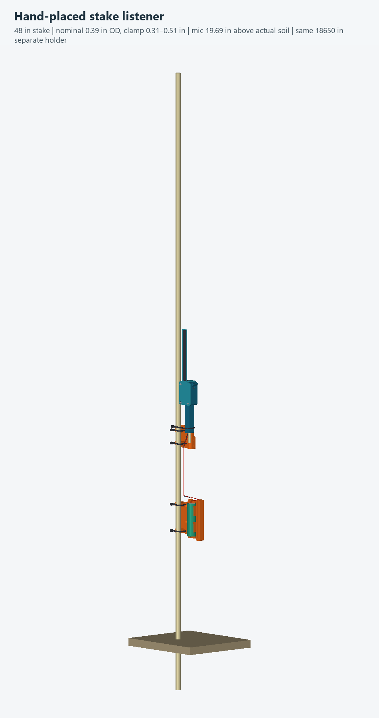
cad/gpt61/renders/stake_assembled.png
