paulrenzi/drone-detection-research/changelog.md

---
title: Changelog
nav_order: 4
---

# Changelog

| Date | Change |
|---|---|
| 2026-10-23 | **Countermeasures: a laser page, and Countermeasures moves into the main menu.** [The laser]({{ site.baseurl }}{% link countermeasures/laser.md %}) checks the claim that a laser can cut a fibre FPV's line "for a moment". It takes at least 0.1 J per mm, about 0.04 s for 100 W on a 0.08 in spot, and the slack line doesn't snap. It works only on a drone you can see, by tracing a loop around it: 40–200 s from a road post, at $2.4–6.3k a post (est.). Blinding the drone's camera with a $120 blue diode may be a cheaper first step. Feasibility 2/5, with tests L1–L3. New model: `tools/lasermodel/laser_model.py`. Countermeasures is now main topic 08, after Partners. |
| 2026-10-23 | **A new section, Countermeasures: cutting a fibre FPV's line.** <ul><li>[Countermeasures]({{ site.baseurl }}{% link countermeasures/index.md %}): why the line is the weak point (it breaks at about 2–13 lbf, and a drone with no radio backup goes dark when it's cut), and what troops already use: shotguns, scissors, a turning barbed wire, and Logika's Chaharnyk (330 ft a unit, 1 s, a claimed 95% of cuts).</li><li>[The fibre cutter]({{ site.baseurl }}{% link countermeasures/fibre-cutter.md %}): a 12.5 ga fence wire 3 ft up on 165 ft spans, with a trolley on each span and a ceramic blade in a V-notch at each end. The drone's line falls across the wire, and on a tripwire alert the trolley runs and cuts it, about 4 s on average and under 7 s at worst. Best beside a road, where it cuts the line of a drone parked to wait. About $3.6k a mile in parts in a small batch, $9.7–12.7k at our price, and about $600–1,100 a mile a year (est.). Set up by hand, about a mile a night for two people. Feasibility 3/5. New tests C1–C3. Model: [`cutter_model.py`](https://github.com/paulrenzi/tripwire/blob/main/tools/cuttermodel/cutter_model.py).</li></ul> |
| 2026-10-23 | **Feasibility 4, our markup, the mic array and a lower upkeep floor.** <ul><li>[The tripwire]({{ site.baseurl }}{% link models/tripwire.md %}#how-the-rating-changed): feasibility rises from 3 to 4. The 3 rested on reporting back 1.2–2.5 mi by radio; the fibres home took that link out. T10, T12, T18 and T21 can still drop it back.</li><li>[Projected costs]({{ site.baseurl }}{% link costs.md %}#pricing-our-cost-plus-markup): our own hardware (darts, tip darts, base box and wire) is priced at +200–300%, the off-the-shelf drone kit at +30%. The package sells for about $6,340–7,840 in a small batch, about $2,110–2,610 per position.</li><li>[Per component]({{ site.baseurl }}{% link costs.md %}#per-component): every dart now carries the 4-mic array (4 analog MEMS mics on the fins, an ES7210 audio chip and a compass) in place of one INMP441, about $5.50 more a dart in a small batch. A small-batch package is now about $2,900, and the road guard was re-run at the new prices: about $20–30k a year for 4 mi. Posts keep one mic.</li><li>[Keeping it up]({{ site.baseurl }}{% link costs.md %}#keeping-it-up): the yearly range now starts at the 2-re-lay case, about $1,600–6,300, and adds an option, a second cell in every dart, which on paper covers the winter shortfall and could cut winter re-lays to 0–1. Not yet checked in the lay model or the 3D model.</li></ul> |
| 2026-10-23 | **Every long page now opens with pictures, not paragraphs.** Each starts with a one-sentence summary, key numbers as cards, and a diagram or chart: the row seen from above, why it sits a mile out, the road guard, price against warning for every competitor, the MVP spend ladder, the software chain, the test board, the package and upkeep bars, the lives funnel, the kill zone by distance, and score meters on every sensor model. Everything else is in fold-outs below, word for word; nothing was deleted, and every link still lands. The visible text on the biggest pages fell from 4,000–7,000 words to 300–700. |
| 2026-10-23 | [The tripwire]({{ site.baseurl }}{% link models/tripwire.md %}#lines-not-coverage): direction at no hardware cost. The alert's dart ID and neighbours' loudness place the crossing to about ±5°; the moment each dart hears the drone pass closest gives its heading, about ±5° per second of timing error, if clocks agree to about 0.1 s. The second row stays an option, needed only if that fails. T11 now records raw audio on every mic with the test drone's GPS log, to measure it. |
| 2026-10-23 | [Competitors]({{ site.baseurl }}{% link research/competitors.md %}#the-priority-list): added VolAnti, the open-source four-mic detector (£50–80, 340 ft on a hovering quad, the author's test), to the priority list. It sits at the position like DroneAlert, so it gives seconds, not a minute. Corrected its row in the measured table to four summed mics. |
| 2026-10-23 | **Solar on every dart and post, and the 2026 fibre price.** <ul><li>[Projected costs]({{ site.baseurl }}{% link costs.md %}): every dart carries a 2.4 in solar panel lying flat on its pod (about $3), and every post a 1 W tilted panel (about $4). Cells now run flat only in midwinter, so a unit plans on 4 winter re-lays a year, not 13: about $3,100–4,800 a year, against $10,000–15,500 at four-week cells without solar. Fibre is now planned at $55–80 a mile, after the 2026 squeeze, so a tip dart is about $122, not $94; its laser can be a $5–9 fibre-to-the-home part. The package is about $2,760 in a small batch.</li><li>[Guarding a road]({{ site.baseurl }}{% link models/route-guard.md %}#cost): the route model reruns with solar and the new prices. A year for 4 mi is about $18.6–27.2k, $4,700–6,700 a mile, against $42.6–63.9k at four-week cells. Posts need no cell swaps, so posts alone cost about $940 a mile a year. Repairs from losses and cut fibres are now half the bill. Against nets, the fence pays back in about 5–17 years.</li><li>[MVP layer 4]({{ site.baseurl }}{% link mvp.md %}#layer-4-battery-and-cold-t12) and T12 add a winter outdoors with a dart's panel and a post's, and a charger that stops below 32°F; MVP layer 3 names the cheap laser. Overview, the tripwire, How it works, Build: hardware and the lives estimate carry the new figures.</li></ul> |
| 2026-10-23 | **Tests reframed around fibre home.** <ul><li>[MVP path]({{ site.baseurl }}{% link mvp.md %}): layer 3 is now the fibre link (T21), bench-tested with FPV fibre transceivers that carry serial data (prices listed, unconfirmed), then a real spool laid from the drone. The silent edge receiver (T17) is kept as the fallback. Layer 1 now tests dart-to-dart hops of 660–980 ft, not a 1.2–1.9 mi leg to the unit.</li><li>[Open questions]({{ site.baseurl }}{% link research/open-questions.md %}#t9-can-a-forward-line-report-back): T9 is now "do the hops along the row hold?", with node-to-node runs on open ground, across belts and in forest, and the long leg to a raised receiver kept as run E for the fallback. T17 is marked fallback only.</li><li>Fixed three links to tripwire-page sections removed in the last change.</li></ul> |
| 2026-10-23 | **The Overview catches up with fibre.** Alerts come home by fibre, so the old deciding question, whether radio can get out of the trees to the unit, is gone. <ul><li>[Overview]({{ site.baseurl }}{% link index.md %}): the open questions are now the hops along the row (T9) and light down the fibre (T21, new), with the jamming row reframed around enemy jammers near the row; the cards add How it works, Guarding a road, Projected costs and Partners; the dart stat is $29 a dart, $94 a tip.</li><li>[What the line gains in lives]({{ site.baseurl }}{% link research/lives-model.md %}#adding-a-guard-on-the-supply-road): a road guard roughly doubles the central guess, to about 5–8 of every 100 drone casualties on guarded roads, because posts catch drones waiting in ambush.</li><li>[The tripwire]({{ site.baseurl }}{% link models/tripwire.md %}): the long "Getting alerts out of the trees" section is now a short fallback, the edge receiver, for where fibre can't go.</li></ul> |
| 2026-10-23 | **Partners for the alert.** New research page, [Partners for the alert]({{ site.baseurl }}{% link research/partners.md %}): what troops on the move already carry that road alerts could ride on. Hrafit's Sova module, which already pushes FPV alerts to drivers' phones along their route from radio intelligence, is the first target. A TAK (CoT) output is the fallback and a way into Delta; Meshtastic handhelds and Chuyka are covered too. Linked from Guarding a road and Central API. |
| 2026-10-23 | **The road's trunks are fibre too.** On [Guarding a road]({{ site.baseurl }}{% link models/route-guard.md %}) the fence no longer comes home by radio relay trunks. Every 2 mi a tip dart in the fence sends its alerts down an FPV fibre to a post, as on the position net, and fibre that would cross the road ends at the near verge, joined to its post under the road. <ul><li>**Darts:** 35–58 air-dropped for 4 mi, against 60–93; 14–20 a mile with the posts, against 20–28. Every strike track still gets a minute (at least 60 s).</li><li>**Cost:** a package of about $5,700–6,800 and $37–56k a year at four-week cells, against $5,900–7,100 and $44–64k. Cut fibres (1% of days each, guessed) add about $2,000–2,800 a year.</li><li>**A cut fibre** costs no track in the model: the tip still relays by radio to the next tip.</li><li>**Jamming, worst case:** with the truck's jammer reaching the fence, 21–46% of tracks keep a minute, against 2–22%. The fence's own radio hops are what is left.</li></ul> `route_model.py` has a `FIBRE` switch; the old plan is a row in its cases. |
| 2026-10-23 | **Fibre home, and ±60° per position.** The net on [How it works]({{ site.baseurl }}{% link models/line-layout.md %}) no longer has relay trunks. Two **tip darts**, the second and second-last in the front row, each carry a spool of about 1.2 mi of FPV fibre that the drone pays out from home as it lays them, and flash alerts down it with a small laser. Both fibres end at a **base box** at the launch point, which writes the same serial line the radio receiver did and wires it to a phone or tablet at each position; nothing at the unit uses radio, so the unit's own jammers can't deafen it. Each tip checks in down its fibre every 10 s, which confirms it when it is laid and shows a cut within 30 s. Each position is now covered ±60°, not ±45°. **In the lay model** (now its defaults): 16 planned darts, about 22 used in 7 sorties and 1.4 h, against 35, 9 and 2.2 h on radio trunks; 98% of lays whole, 98% stay whole with a fibre cut. The fibres give the saving; ±60° costs about 3 front darts and does not absorb bad drops, because compass error opens gaps mid-row. All three animations and the video are redone. [Projected costs]({{ site.baseurl }}{% link costs.md %}): the package is 22 darts, 4 tip darts, a base box and wire, about $2,580 in a small batch; a re-lay costs us about $1,020 at prototype prices, against $1,290. The [jamming model](https://github.com/paulrenzi/tripwire/blob/main/tools/jamming/jam_model.py) now runs on the fibre net: with our own jammers on, the net stays whole on the main estimate. New test **T21**: a tip dart, a full spool and a base box. Untested throughout. |
| 2026-10-23 | **Every page brought in line with both models.** Pages that still said lines go 1.2–2.5 mi out, in two rows, now describe the modelled net: one row about 1 mi out (5,316 ft) with two trunks home, about 35 darts a lay, about 45–60 s of warning at an FPV's top speed and 1.3–1.8 min at its usual speed. A second row is now an option, not the design. Pages that said nothing warns of a drone waiting by a road now point to the road guard. The home page lists jamming (T19) as a fourth open question. |
| 2026-10-23 | **Jamming, modelled.** A link-budget model, [`tools/jamming/jam_model.py`](https://github.com/paulrenzi/tripwire/blob/main/tools/jamming/jam_model.py), and a new section on [How it works]({{ site.baseurl }}{% link models/line-layout.md %}#jamming). A jammer spreads its power over hundreds of our channels, so on our main estimate a 20 W trench jammer near the ground blinds a dart only within about 390 ft; in the worst case, where its signal crosses open ground without the losses that limit our own hops, about 1.1 mi. **The unit's own jammers are the first threat:** receivers at the positions go deaf whenever those are on. Proposed fix: a root dart about 1,000 ft forward at the foot of each trunk, each sending alerts home one way down FPV fibre (about $60–100 a unit, est.), which keeps the minute in the model on the main estimate. Fibre is not proposed for the whole net: an air-dropped row can't share one, and every cut would silence everything beyond it. [Field conditions]({{ site.baseurl }}{% link research/field-conditions.md %}#electronic-warfare) now has where jamming is and which bands it covers. T19 now measures at 300 ft to 1 mi from a jammer, and decides between the two cases. [Build or scrap?]({{ site.baseurl }}{% link research/build-or-scrap.md %}) says what result would scrap the radio. |
| 2026-10-23 | **Guarding a road.** New page, [Guarding a road]({{ site.baseurl }}{% link models/route-guard.md %}), on a route model, [`tools/routemodel/route_model.py`](https://github.com/paulrenzi/tripwire/blob/main/tools/routemodel/route_model.py), with an animation. Posts placed by hand along the road hear drones that land to wait; a fence of air-dropped darts about a mile out gives the minute. On two invented 4 mi roads: 21 posts and 60–93 darts, about 20–28 a mile. Every drone flying in within 60° of the enemy is heard at least 58 s out (posts alone give 4–9 s), and every landing within 300 ft of the road is heard. About $5,900–7,100 a package and $44–64k a year at four-week cells ([costs]({{ site.baseurl }}{% link costs.md %}#guarding-a-road)). Against the trucks' own jammers, posts on a cable with hooded lamps facing the road keep the warning in the model, for about $800 more. Zvook already pitches wired NW0 sensors for roads, so it is a direct rival there. New test T20: hearing a drone land beside a road. |
| 2026-10-22 | **Every page now matches the lay model.** Both animations on [How it works]({{ site.baseurl }}{% link models/line-layout.md %}) now run the end darts 300 ft past the 45° lines and route alerts through a hand-placed root dart, so the open-ground net is 22 darts (12 front, 10 relays) plus the root, not 20. The repair animation's closing dart is now relayed from one side only, as the model requires. The dart-count tables, the longest route home (11 hops), the failure table (a root-dart row) and the lay figures on the tripwire, delivery-drone, hardware, software, landscape, competitors and lives pages now use the model's numbers: about 35 darts and 9 sorties a lay, a $1.9–2.9k package, $10.5–17k a year at four-week cells, and daylight for a lay with GPS jammed. |
| 2026-10-22 | **A working lay model, with a video.** [How it works]({{ site.baseurl }}{% link models/line-layout.md %}#laying-the-net) now runs on a planner and simulator, [`tools/laymodel/lay_model.py`](https://github.com/paulrenzi/tripwire/blob/main/tools/laymodel/lay_model.py). It plans the net on a map (trees, a ravine, slope, the enemy edge, wind), checks each sortie against the battery, writes ArduPilot missions, and lays the net 1,000 times with drop errors, bad landings and radio fading. A video shows one lay from the model. **Findings:** on real ground the first 20-dart plan gets only 6 darts' alerts home. The new plan is 25 darts, and laying them takes about 35 darts and 9 sorties, about 2 hours with GPS jammed. Without confirming every link, only 5% of lays come out whole; with it, 99%. Darts at the ends of the row move 300 ft past the 45° lines, because a 3° compass error otherwise leaves one edge unheard. 14 holes are fixed in the model, among them: terrain-relative flight with a lidar, origin and declination set when GPS is jammed, a ground speed per leg with a gust margin, a tilt sensor and a microphone in every dart, relayer IDs, and a hand-placed root dart. The root dart also settles how P1 and P3 hear an alarm. [Projected costs]({{ site.baseurl }}{% link costs.md %}): the drone gains about $420 of kit, and the package is now 40 darts, about $2,620 in a small batch and $3,940 at 50% markup. A re-lay costs us about $1,190. |
| 2026-10-22 | **When it breaks.** [How it works]({{ site.baseurl }}{% link models/line-layout.md %}#when-it-breaks) adds what each failure costs and how it is fixed, with a second animation: a relay knocked out, found by a daily roll call and replaced, then a re-lay flown on a compass 3° off and caught by drop, then confirm. One dart on each trunk silences the net (36 of 190 pairs). Two design changes are proposed: a relayed daily roll call, and a receive-only radio on the drone that confirms each link before it moves on. A new subsection says what the drone knows (coordinates only). The vision row now names NGPS and gnss-denied-nav (both MIT) and notes WildNav's SuperGlue licence. [Projected costs]({{ site.baseurl }}{% link costs.md %}) adds repair costs. |
| 2026-10-22 | **Two trunks by default; prices are cost plus markup.** [How it works]({{ site.baseurl }}{% link models/line-layout.md %}) now shows only the two-trunk net (20 darts): no single dart can silence it. The single trunk is dropped because one dead relay would silence the whole net. [Projected costs]({{ site.baseurl }}{% link costs.md %}) now prices the whole package: 24 darts, 3 receivers, and the delivery drone with harness, two batteries and a charger. It costs us about $1,810 today, $1,710 in a small batch and $1,180 in production. The price is that cost plus our markup, shown at 30%, 50% and 100%. At 50% on small-batch cost the package is about $2,560 (about $855 per position) and a 20-dart re-lay about $775. This replaces the earlier $1,795 kit price, which left out the drone. |
| 2026-10-22 | **Two new sections: How it works and Projected costs.** The net page becomes [How it works]({{ site.baseurl }}{% link models/line-layout.md %}), listed after 3D models. It adds how a net is laid: planned on a map, 4 darts per sortie, trunks first so every new dart checks in, and spares dropped where one is missing. It covers how the drone finds drop points with GPS jammed: plain GPS, optical flow on short legs, then computer vision matching the camera to satellite maps. New requirement: **drop accuracy sets the dart count.** A dart that lands off its point can fall out of radio reach, so the 20-dart V needs 24 darts at ±66 ft and 30 at ±160 ft. Relay darts must keep their radio listening, so they may run down first. [Projected costs]({{ site.baseurl }}{% link costs.md %}) prices every component at prototype, small-batch and production scale. A unit's net is about $560 in parts today and about $400 in production. Re-lays cost $1,400–13,000 a year depending on unmeasured battery life. It suggests a $1,795 kit (24 darts, 3 receivers; about $600 per position, one Chuyka), $69 darts, $980 re-lay packs and $49 receivers. Corrects the dart price on the net page, which had used the Heltec board: the dart is built on the cheaper XIAO kit. |
| 2026-10-22 | **A net in front of a unit.** *12 darts in the field* is now [A net in front of a unit]({{ site.baseurl }}{% link models/line-layout.md %}), worked out from the drone's speed instead of a fixed 12 darts. It assumes a dart hears 656 ft (200 m) and drones fly at 60 mph, up to 165 ft up. The unit is three positions 1,640 ft across, after Kofman's "nine men in three defensive positions" 250 m apart. A minute's warning puts a front row of 10 listening darts 1.01 mi out, covering ±45° of each position. The radio, not the ear, sets their spacing. Relay darts with no mic carry the alert home: one trunk is 15 darts (about $550), a V of two trunks is 20 (about $700) and survives any one dead dart. The map animates three drones at 60 mph, all caught with 60–67 s of warning, and any dart can be tapped to knock it out. |
| 2026-10-22 | **12 darts as a relay chain.** [12 darts in the field]({{ site.baseurl }}{% link models/line-layout.md %}) (was *What a line looks like*) now draws the darts as a chain: each radios the one behind it, about 980 ft (300 m) per hop, back to the unit. The map switches between three layouts of the same 12 darts: a trail 2.2 mi long, a trail with a crossbar 1.3 mi out, and an arc 0.74 mi out. A table compares them. A trail gives about 3 minutes against a drone coming straight down it but a minute only within ±7°; the arc gives about a minute across ±60°. Adds chain spacing rules and the broken-chain risk. |
| 2026-10-22 | **What a line looks like.** New page, [What a line looks like]({{ site.baseurl }}{% link models/line-layout.md %}): an animated, to-scale map of 12 darts 1.2 mi in front of a unit. One drone crosses between two darts and is caught with about 1 min 40 s of warning; a second flies round the end and is heard only at the unit, about 7 s out. Adds spacing rules (one hearing range apart; how much front 12 darts cover at each hearing range), distances, and what a line misses. Explains why the darts are a tripwire, not a microphone array. |
| 2026-10-22 | **How fast and how high the drones fly.** New note, [The drones it has to hear]({{ site.baseurl }}{% link research/threat-profile.md %}): speed and height for FPVs, fibre-optic FPVs, Lancet, Molniya, night bombers and Geran. A loaded FPV usually flies at 37–50 mph, not its 67–89 mph top speed, so warning is about 1.5–2 times the worst-case figures, now shown beside them on the home page, the tripwire and [A minute against the alternatives]({{ site.baseurl }}{% link research/problem-check.md %}#how-much-warning-each-source-gives). Fibre-optic FPVs fly low (65–165 ft), so height barely costs range. New limit: a fibre-optic FPV parked in ambush is silent until seconds before it strikes, and a listener line can't warn of it. |
| 2026-10-21 | **The Saturday test starts with the kit at a glance.** [Saturday test]({{ site.baseurl }}{% link weekend-test.md %}#at-a-glance) now opens with what each item is for and where it sits on the day, including the laptop, which is only used at home. The steps are split into four at home and six in the park, each naming the boards, phones and speaker it uses, and checking the gateway is its own step, apart from setting the meter. |
| 2026-10-21 | **The dart gets tail fins.** GPT-6.1 added four long, low fins on two glued collars, so the air's push sits well behind the balance point and the dart should fall point first. By its cardboard-cut-out estimate the gap grows from 1.84 in to 3.06 in, about two body widths. The dart is now 5.91 oz, balanced 10.89 in from the tip, and four darts with the harness weigh 1.88 lb. It stays carried flat: hanging it off balance would jam the release. New renders show the cell and balance point in a cut-away, the fins, and a schematic of the fall, with a table of how far wind tilts the landing. The dummy gets the same fins. 164 of 164 checks pass. Nothing has been printed or dropped. [3D models]({{ site.baseurl }}{% link build-3d.md %}#why-it-should-fall-point-first). |
| 2026-10-21 | **Two phones, two ends.** The Saturday test now uses a mic phone and a logger phone. The mic phone stays at the mic with board 1 and the speaker: it measures, records and now plays the speaker too. The logger phone, the hotspot, goes with the gateway and gives the orders. **Start sequence** hands the whole sequence to the mic phone, which runs it on its own clock, so it carries on if the logger loses signal. The two ends are joined only by the LoRa link under test, so the sweep can be run again from any stop on the radio walk. One phone still works as a fallback. [The Saturday test]({{ site.baseurl }}{% link weekend-test.md %}#field-layout) and its layout are redrawn. Tested in two browser tabs with a test tone, not yet on phones in a field. |
| 2026-10-21 | **Watch the test from a second phone.** The logger has a new *Watch from a second phone* code. Scan it with the phone you carry, and that phone shows the alarm, the sound at the mic, the sequence countdown and the range table live, once a second, from behind the speaker. It only watches; everything is still started and stopped on the phone at the mic. [The Saturday test]({{ site.baseurl }}{% link weekend-test.md %}). |
| 2026-10-21 | **The field layout says how 330 ft fits in a yard.** The distances are played, not walked: the speaker stays 16 ft from the mic and plays the drone turned down, so Bluetooth only spans 16 ft. Only the LoRa link goes the distance. Each link is labelled where it runs, and the drawing says the two phones use their own mobile data, not each other. [Where everything goes]({{ site.baseurl }}{% link weekend-test.md %}#field-layout). |
| 2026-10-21 | **The logger phone gives the gateway its hotspot, in the park.** When the gateway can't reach a hotspot it knows, it opens its own WiFi network, *tw-… setup*. The logger phone joins it and types its hotspot into the page that opens, and the gateway joins that hotspot. So nothing about the phones is fixed at flashing, and the flasher's hotspot is now optional. Firmware built and its setup-page code tested off the board, not yet run on a real XIAO. |
| 2026-10-21 | **Either phone can be the logger phone.** The gateway is flashed with both phones' hotspots and joins whichever one is on, so the roles are picked in the park, and swapped by turning one hotspot off and the other on. It also no longer gives up when no hotspot is on yet: before, a gateway powered up first had to be unplugged and plugged back in. Firmware built in CI, not yet run on a real XIAO. |
| 2026-10-21 | **No codes to scan: the logger asks which phone this is.** Open the logger on each phone and tap *Logger phone*, *Mic phone* or *Just watching*. The logger phone lists gateways that are online and the mic phone lists open loggers, through the same public broker, so each joins with one tap. A mic phone that joined before the logger picked its gateway follows it. The flasher's QR code is gone. Checked in a browser with a simulated gateway, not yet on the boards. [What each phone shows]({{ site.baseurl }}{% link weekend-test.md %}#screens). |
| 2026-10-21 | **The detector is the sound meter; no meter app.** Over USB it now reports its A-weighted level once a second, from its INMP441's rated sensitivity, and the laptop logger sets the mic phone's meter from it with one tap. Its silence gate drops from about 57 dB at the mic, louder than a quiet field, to about 37 dB, so a distant drone is no longer skipped as silence ([firmware](https://github.com/paulrenzi/tripwire-firmware)). The flasher carries the new build. Checked in a browser with a simulated detector and a fake microphone, not yet on the boards. [Set the meter]({{ site.baseurl }}{% link weekend-test.md %}#phone-meter). |
| 2026-10-21 | **The Saturday test can now reach a verdict.** The sweep plays each distance three times, about 21 minutes, because the logger only rules on a distance with 3 or more plays; one pass of single plays could never say pass or fail. 200 ft joins the ladder, so the fail line is tested, not straddled. [The Saturday test]({{ site.baseurl }}{% link weekend-test.md %}). |
| 2026-10-21 | **The speaker sweep takes 10 minutes.** It now gives you 60 s to walk away before the first play, plays each distance once for 30 s, and records 4 minutes of background, instead of an hour of repeats. [Run the speaker test]({{ site.baseurl }}{% link weekend-test.md %}#speaker-test). |
| 2026-10-21 | **One phone runs the Saturday test.** The logger phone now sits beside the mic and is the sound meter and recorder too, playing to the speaker by Bluetooth from 16 ft away. The second phone and its QR code are gone, and the phone's meter is set once at home against a meter app on the same phone. A second phone stays as a fallback for speakers that drop to call quality while the mic is on. The [Saturday test]({{ site.baseurl }}{% link weekend-test.md %}#field-layout) gains a drawn field layout.
| 2026-10-21 | **The 3D models use the XIAO board.** GPT-6.1 rebuilt [Build: 3D models]({{ site.baseurl }}{% link build-3d.md %}) round the Seeed XIAO ESP32S3 + Wio-SX1262 kit we bought, from Seeed's own CAD. The pod is smaller, with a cap that comes off for USB-C flashing, and has no screen. The dart is now 5.2 oz (was 5.6), and four darts plus the harness 1.7 lb. New: a stake mount for placing a listener by hand, with its own 3D model, and an inert dummy with 1.3 oz of steel ballast that matches a real dart's mass and balance, for the first drop tests. 140 model checks pass; nothing printed yet. |
| 2026-10-21 | **Feet, miles and ounces everywhere.** Every page and the logger now use US units: inches, feet, yards and miles for distance, ounces and pounds for mass, mph for wind and speed, °F for temperature. The cost model is per square mile. The logger takes distances in feet and mic height in inches, its exported columns are `distance_ft`, `altitude_ft` and `mic_height_in`, and sessions saved earlier in metres convert when they load. Quotations that gave metric figures are now paraphrased with the converted figure. Bought parts keep their trade names (M3 screws, 18650 cells). |
| 2026-10-21 | **The logger explains its numbers.** Its readings have plain names (*loudness at mic*, *detector hears*, *radio signal*), and a *What the numbers mean* section explains decibels, dB(A), the raw level, setting the meter, emulated distance and the radio numbers, with everyday sounds for scale. It shows on the mic phone too. The mic phone now works with no board connected, so the speaker test can be tried at a desk with a computer and a phone. |
| 2026-10-21 | **The logger runs the whole test from one screen.** The second phone opens the logger's [mic page]({{ site.baseurl }}{% link weekend-test.md %}#phone-meter) from a QR code and becomes the sound meter (A-weighted, set once against a meter app) and the recorder. The logger shows its level live, fills in both calibration readings with **Measure at the mic**, and starts and stops its recording with the speaker sequence. Each run keeps the level it aimed for, the level measured at the mic and the detector's own level, which the [firmware](https://github.com/paulrenzi/tripwire-firmware) now sends with every once-a-minute check-in. The clip cutter's `--mic` lines the recording up without a clap. Tested in a browser with a test tone in place of a microphone, not yet on phones in a field. |
| 2026-10-21 | **The site is now trip/wire, and the logger saves online.** The repository is renamed `tripwire`, so the site moves to paulrenzi.github.io/tripwire. The logger saves each session online as it goes, so nothing is exported and the results can be read from anywhere. **Start sequence** now records the 30 minutes of background itself, after the speaker sweep. The second phone's recording and the Sync clap are optional, only for training clips, and the clip cutter reads the saved session with `--session latest`. |
| 2026-10-21 | **The Saturday test needs no drone.** The speaker covers every distance; the flight step is gone, and a real flight moves to layer 2. The flasher makes up the gateway ID and shows a QR code that opens the logger on the phone with that ID and connects, so nothing is typed twice. The XIAO detector checks in once a minute, which shows it is alive before any sound plays and gives the radio walk something to count without a second sound source. The parts line gains a second power bank, windscreens and soldering, and steps 1–3 move to the day before. |
| 2026-10-21 | **The XIAO kits we bought are now the test boards.** [tripwire-firmware](https://github.com/paulrenzi/tripwire-firmware) gains the Seeed XIAO ESP32S3 + Wio-SX1262 kit, with pins taken from Meshtastic's map for it. A new [flasher]({{ site.baseurl }}/tools/flasher/) installs the detector and gateway in the browser, replacing the Meshtastic firmware the kits ship with. It writes one random network key to both boards and gives the gateway the hotspot and the logger's gateway ID. The [Saturday test]({{ site.baseurl }}{% link weekend-test.md %}) and kit lists now use these boards. The images are built in CI and not yet run on a real board. |
| 2026-10-21 | **The Saturday test has its own page.** [Saturday test]({{ site.baseurl }}{% link weekend-test.md %}): pass and fail, a parts line, ten steps and the logger button, with the layout, phone setup, speaker test and downloads folded below. The MVP page is now the MVP path and keeps the speaker reasoning. |
| 2026-10-21 | **Where everything goes.** The Saturday test gains a field layout: speaker 16 ft from the mic, with the logger phone and gateway on the speaker's chair, and you 66 ft behind. No house WiFi is needed. New steps: Do Not Disturb and Auto-Lock off, since a notification would play through the speaker. The sound meter is used before the second phone starts recording. Calibration drops from 65–75 to 60–65 dB(A) to keep a small speaker from distorting, and the logger warns above 70. Volume is set once with any button, because many phones tie their volume to the speaker's. Now ten steps. |
| 2026-10-21 | **The speaker test moved into the logger.** The logger's new *Speaker test* panel plays a drone sound through a Bluetooth speaker paired with the phone. It sets each level from one meter reading, plays the distances in a pattern, and logs every play as a *Speaker* run. The sounds are a DJI Mini 4 Pro and a 5-inch FPV from batear-datasets (MIT), or your own recording. `make_playback.py` is removed. Tested in a desktop browser, not yet with a real speaker or phone. |
| 2026-10-21 | **One Saturday test.** The weekend test is now the [Saturday test]({{ site.baseurl }}{% link mvp.md %}#weekend-test): nine numbered steps in one day, setup included. The speaker sweep covers the distances; the drone flies only 160, 330 and 490 ft to check it. Training a model is optional afterwards, not a test day. The kit page's separate Friday–Sunday plan is replaced by a pointer, keeping the mic wiring and the train/test split advice. |
| 2026-10-21 | **Speaker test tooling.** `make_playback.py` writes level-matched speaker files for each emulated distance from one drone recording and one meter reading; the logger has a *Speaker* run type, kept apart from real flights in the range table, and `cut_clips.py` labels its clips `speaker_<distance>m`. See [run the speaker test]({{ site.baseurl }}{% link mvp.md %}#speaker-test). Not yet used with a real speaker or meter. |
| 2026-10-21 | **Weekend test, simplified.** The [weekend test]({{ site.baseurl }}{% link mvp.md %}#weekend-test) is now a short plan with the logger embedded, running on demo data, and the detail folded away. The logger is mobile-first and reads the gateway over WiFi through a public MQTT broker, so it works on a phone. A new section asks whether a [speaker can stand in for the drone]({{ site.baseurl }}{% link mvp.md %}#speaker-test): yes for the threshold sweep, with a real flight at two or three distances to check propagation. |
| 2026-10-21 | **Weekend test tools.** Added a [downloads section]({{ site.baseurl }}{% link mvp.md %}#weekend-logger) to the weekend test: a browser logger that reads the Batear gateway and detector over USB, tags readings by run and exports CSV, and `cut_clips.py`, which cuts recordings into labelled training clips aligned on a clap. Tested in demo mode and on synthetic audio, not yet on real boards. |
| 2026-10-21 | **Refocused the site on the drone-laid tripwire.** The [overview]({{ site.baseurl }}{% link index.md %}) is now the tripwire concept, and the sidebar leads with four sections for assessing it: overview, [3D models and downloads]({{ site.baseurl }}{% link build-3d.md %}) (the viewer now plays the assembly on a loop; STL, STEP, glTF and a print-kit zip), [competitors]({{ site.baseurl }}{% link research/competitors.md %}), and [weekend test and MVP]({{ site.baseurl }}{% link mvp.md %}), which now opens with the weekend test. The old overview moved to [the wider field]({{ site.baseurl }}{% link research/landscape.md %}); the other sensor models and remaining research notes are folded away in the sidebar. No ratings or findings changed. |
| 2026-10-19 | Added [Build: software plan]({{ site.baseurl }}{% link build-software-plan.md %}): the open-source projects to build each of the six programs from, checked for licence and activity, and a seven-phase build plan tied to the MVP layers. Relays now wait by signal strength (weakest relays first, as Meshtastic does) instead of at random. The radio's own duty-cycled receive can run the relay windows while the processor sleeps. Android reading a wired serial adapter in the browser is flagged as untested. **Correction:** the Al-Emadi drone audio set is licensed for non-commercial academic use only, not "public"; two shippable sets were added to [Training data]({{ site.baseurl }}{% link research/datasets.md %}). |
| 2026-10-16 | Added [Build: 3D models]({{ site.baseurl }}{% link build-3d.md %}): GPT-6.1's dart, harness and X500 assembly in a 3D viewer you can rotate and slide between assembled and exploded, with every part named, its mass and what it does. Bought parts use the manufacturers' CAD where it exists (X500 frame, Heltec V3) and datasheets otherwise. Model masses: 5.6 oz per dart, 6.5 oz harness, 1.8 lb for four darts and the harness. Never printed or dropped; whether a dart lands upright is still the first test. |
| 2026-10-15 | [Hardware v3]({{ site.baseurl }}{% link build-hardware.md %}#1-v3-three-parts-per-dart): each dart is now a rod, one printed body and a head pod. The body is nose, snap-in cell cradle, sleeve and hanger in one print, so v2's clip, zip tie and foam are gone. It hangs on v2's harness unchanged. 15 parts against 27; parts to buy about $50 against $63. Cells are now 40% of the cost: per 4-dart re-lay about $26.50 against $33, and about $16.50 if EVE cells come back in stock. |
| 2026-10-15 | [Hardware v2]({{ site.baseurl }}{% link build-hardware.md %}#2-v2-one-rod-one-servo): one fibreglass rod is the dart's spike, spine and mast, carried flat; one servo turns a printed rotor whose rim gaps drop the darts one by one. 27 parts against 61, no moving joints in the dart, parts to buy about $63 against $139. Darts are lighter (~4.4 oz est.), so an X500 with 4 hovers an estimated 11.3–11.8 min. New open question for T10: does a flat-carried dart turn point-down as it falls? |
| 2026-10-15 | [X500 harness v1]({{ site.baseurl }}{% link build-hardware.md %}#4-v1-harness-four-servos-superseded-by-v2): the servo horn is now the latch. A side-open notch on each dart tongue hangs on the horn arm; 90° of servo turn swings the arm out. One printed plate, zip-tied to the rails, replaces 13 printed parts, 4 pins and 4 pushrods. The model shows no interference latched or anywhere in the sweep. v0 is kept as the fallback. Parts total now about $139. |
| 2026-10-15 | Added [Build: hardware]({{ site.baseurl }}{% link build-hardware.md %}) and [Build: software]({{ site.baseurl }}{% link build-software.md %}), the designs the site argued for but never had. <ul><li>**Hardware**, modelled in CadQuery (`cad/`, STL, STEP and renders), all fitting the Anycubic Vyper's bed: a ~6.9 oz listener dart with a steel spike, a 4-section folding mast and a head pod that puts the mic and antenna at ~31 in; a 4-pin release harness for the X500's 0.39 in rails on Pixhawk AUX 1–4; and TL-1, a printed carrier with the dart bay in its hull.</li><li>**Estimate:** an X500 with 4 darts hovers ~9–10 min and reaches a line ~1.4 mi out; TL-1 ~1.7 mi. Lines 1.9–2.5 mi out need 2–3 darts per sortie. The model also shows the X500 needs ~2.4–3.1 in leg extensions to carry darts.</li><li>**Software:** six components, five interfaces, and Batear's coverage. Batear's LoRa nonce is a 16-bit counter that restarts at 0 on every boot and is shared across detectors, so GCM nonces repeat across devices, and a rebooted detector is rejected as a replay. A fix is specified. A per-hop age field replaces clock sync for telling which line tripped first.</li></ul> Parts for 4 darts and the harness, about $145; every Amazon listing was checked in a browser. |
| 2026-10-15 | T18 is no longer a gate. Earlier warning of fibre-optic FPVs, which nothing else detects, at lower cost, is taken as worth having. Interviews now only size the lives estimate and shape placement; the build-or-scrap kill criterion is removed and T9 is the next real test. |
| 2026-10-15 | Added the [MVP path]({{ site.baseurl }}{% link mvp.md %}): five gated layers from an $80 radio test (T9) to a six-listener line with a silent edge receiver, each with parts links checked that day and alternatives. T9 gains a cheapest-version note and a margin method; the tripwire and overview link to it. |
| 2026-10-15 | Condensed and brought every page in line with the lives estimate and the front-line inventory. <ul><li>The [problem check]({{ site.baseurl }}{% link research/problem-check.md %}) drops its two overlapping tables (what units do today, what a minute buys) for a short summary, the [inventory]({{ site.baseurl }}{% link research/frontline-kit.md %}) and one timing comparison. T18 now asks what kit units have and trust, and how many casualties come from drones waiting by the road.</li><li>The overview, tripwire, competitors and build-or-scrap pages now carry the central guess (about 1–4 of every 100 drone casualties averted) and the front-line findings: jamming is failing, and AI turrets carry their own sensors.</li><li>The overview no longer says the network gives only "seconds to tens of seconds" of warning.</li></ul> |
| 2026-10-15 | Added [What troops have, and what listening adds]({{ site.baseurl }}{% link research/frontline-kit.md %}): the anti-drone kit Ukrainian front-line troops actually use, item by item, and what a listener adds to each. <ul><li>Against fibre-optic FPVs the baseline is still ears, eyes and a firearm.</li><li>Radio detectors are the most common warning device and can't hear fibre-optic drones.</li><li>A brigade EW commander says "Jamming no longer works", so cueing jammers (the MEDUSA pairing) is a fading benefit.</li><li>Interceptor drones are the most-ordered category on Brave1 Market in 2026, but we found no verified interception of an attacking FPV.</li><li>An AI turret that tracks fibre-optic drones is in more than 10 units and is the nearest rival at a position.</li><li>A forward line's minute of warning of fibre-optic drones is offered by nothing else found.</li></ul> No source ranks these measures or says what share of units has each. |
| 2026-10-15 | Added [What the line gains in lives]({{ site.baseurl }}{% link research/lives-model.md %}): a Fermi estimate of what a minute of warning saves against ~10 seconds, with partner systems. Central guess about 1–4 of every 100 drone casualties averted in a unit that uses the line (range 0.3–14), almost all among people about to move: rotation, resupply, evacuation. At a fixed position a minute adds little over seconds. Against fibre-optic FPVs, jammers do nothing and the line's minute is the only early warning. Each input is marked measured, claimed or guess; T18, T11 and T9/T17 decide where in the range it lands. |
| 2026-10-15 | Added CERBAIR MEDUSA, a site jammer, to [partners]({{ site.baseurl }}{% link research/competitors.md %}#partners-and-the-budget-we-compete-for) as a component our network could cue: it is built to be switched on by a detector, and an acoustic cue hears drones whatever their radio link. It does nothing against fibre-optic FPVs. The [jamming row]({{ site.baseurl }}{% link research/problem-check.md %}#a-minute-against-the-alternatives) now credits warning for switching jammers on against radio FPVs. |
| 2026-10-15 | Added [A minute against the alternatives]({{ site.baseurl }}{% link research/problem-check.md %}#a-minute-against-the-alternatives): how much warning each known defence needs, compared at 0 s, ~5 s, ~15 s and ~1 min. <ul><li>Weapons need seconds: a net-gun, shotgun or rifle has about 1–4 s of the drone's flight in range, so a minute adds little over a sensor at the position.</li><li>The minute buys a go/no-go call on movement (vehicle runs, resupply pickups, walkers), which only a forward line gives against fibre-optic FPVs. Russia's roadside drone "traffic lights" already do this job for roads.</li><li>A radio detector already gives a minute or more, but only against radio-controlled FPVs.</li><li>Evacuations already wait hours for night, fog or rain; whether a minute would change that is a T18 question.</li></ul> The tripwire no longer pitches a minute as a cue for shooters. |
| 2026-10-15 | Added [Build or scrap?]({{ site.baseurl }}{% link research/build-or-scrap.md %}) after a fresh sweep of competitors, FPV acoustics, forward sensors, enemy counters and whether warning helps. Verdict: don't scrap, but narrow. <ul><li>Warning time is distance over speed: any sensor at the position gives seconds even on its maker's best range, and only a line 1.2–2.5 mi forward gives a minute.</li><li>At equal range on every row, our listeners are about 4–12x cheaper than DroneAlert and 17–56x cheaper than NW0 per 1.9 mi line.</li><li>New: DroneAlert, a ~$211 LoRa acoustic module on a battery (seller's claims), so our hand-placed node is no longer cheaper than the market; SKANER 2.1, Arcani HARK, Sound Shield and ZVOOK Tracking added to the [priority list]({{ site.baseurl }}{% link research/competitors.md %}#the-priority-list).</li><li>No measured FPV sound level or controlled FPV range test exists anywhere; a first-principles estimate gives about 330 ft in wind, 490–820 ft calm, so plan 20–30 listeners per 1.9 mi line.</li><li>New risk and test T19: common jammers already cover LoRa bands, and a LoRa-hunting jammer prototype is described.</li><li>T18 now asks about drivers, medics and resupply: about half of casualties are in the rear.</li></ul> |
| 2026-10-15 | **Correction: we are much cheaper than Zvook NW0 per sensor.** The previous entry said price per position was no longer our edge. That was wrong. It gave NW0 its maker-claimed 490–1,500 ft range and gave us our cautious measured-literature range: a competitor's best case against our worst. Per sensor, a tripwire listener is $17–50 and a hand-placed node about $125–300, against $834–950 for an NW0, which also needs 15–18 W of power not in its price: roughly 3–50x cheaper. Cost per position depends on real range, which nobody has measured for either; T11 and any independent NW0 test decide it. Corrected on the [competitor analysis]({{ site.baseurl }}{% link research/competitors.md %}) and the [overview]({{ site.baseurl }}{% link index.md %}). Checked the rest of the site for the same mistake: <ul><li>[M1]({{ site.baseurl }}{% link models/m01-ground-array-mesh.md %}) no longer claims a firm "4–8× cheaper" than Sky Fortress; ours is a parts estimate, theirs a reported field cost.</li><li>The overview labels the $60–120 node as a parts estimate and Squarehead's range as a claim.</li><li>The [tripwire comparison]({{ site.baseurl }}{% link models/tripwire.md %}#compared-with-the-alternatives) now says its warning times are estimates and that every acoustic row assumes an unmeasured FPV range.</li><li>The [problem check]({{ site.baseurl }}{% link research/problem-check.md %}) no longer says NW0 has no price.</li></ul> |
| 2026-10-15 | Rebuilt the [competitor analysis]({{ site.baseurl }}{% link research/competitors.md %}) as a [priority list]({{ site.baseurl }}{% link research/competitors.md %}#the-priority-list) ranked by cost against what each option is shown to achieve, after reading research papers, RUSI reports, procurement sources and competitor listings in full. Findings: <ul><li>Zvook NW0 is on sale at about $834–950 per sensor, the same as a radio detector, so price per position is no longer our edge over it. Battery power and forward placement are.</li><li>New competitors: RADD GLADIUS (US, soldier-worn), Komodo (Denmark, with a drone-droppable variant), Russian phone and helmet detectors, and fibre catchers competing for the same budget.</li><li>A new table of [what is actually measured]({{ site.baseurl }}{% link research/competitors.md %}#what-is-actually-measured). The only measured cheap-microphone range is about 160–200 ft against a consumer drone. People in a quiet field heard a Mavic-class drone faintly at 490 ft. No study has flown an FPV at distance. The tripwire and range pages now flag that a line may need about 30 listeners, not 12.</li><li>The problem check now cites RUSI: warning is argued for but never measured, and about half of casualties happen in the rear.</li><li>Chuyka 3.0's price is corrected to $584–701 from the maker's page.</li></ul> |
| 2026-10-15 | Repositioned around [two markets]({{ site.baseurl }}{% link research/competitors.md %}#two-markets-only-one-of-them-ours). Cheap acoustic networks (Sky Fortress, Zvook stations, FENEK) are proven against Shaheds over the rear, not against FPVs at the front. The US Army's March 2026 review claims FPV detection, but its sources are about Shaheds. Changes: <ul><li>Our competition at a position is now named: a soldier's own ears (unmeasured), the radio detector as partner ("the second box"), and Zvook NW0.</li><li>NW0 is now marked maker's claims only: no price, test or deployment.</li><li>New tagline on the overview and competitors page.</li><li>Added the tripwire's [running cost]({{ site.baseurl }}{% link models/tripwire.md %}#the-running-cost-lines-are-ammunition) (estimated $5–16k a year in re-lays), which the kit price left out.</li></ul> |
| 2026-10-15 | [Front-line conditions]({{ site.baseurl }}{% link research/field-conditions.md %}#where-infantry-actually-sit-tree-lines): no published figure gives how far positions sit from a tree-line edge; added the sourced context (belt widths, burrows, watched belts, real forest) and labelled the distance estimates as inference. T18 now also asks what terrain a position is in and how far it is from the tree edge. The tripwire notes the wire to the edge works in every terrain; the open risk is the listener-to-edge radio leg (T9 run E). |
| 2026-10-15 | Added [What a minute buys]({{ site.baseurl }}{% link research/problem-check.md %}#what-a-minute-buys): what troops can actually do with warning against fibre-optic FPVs. Mostly avoidance (cover, holding movement), plus readying shotgun teams and cueing the AI turrets now in front-line units; nets and cable traps don't benefit. T18 now asks which moments matter. Corrected the tripwire's claim that a minute lets a unit launch an interceptor. |
| 2026-10-15 | Put the front-line evidence where readers see it first: a **What the front tells us** summary on the [overview]({{ site.baseurl }}{% link index.md %}), a **Why it matters** section on the [tripwire]({{ site.baseurl }}{% link models/tripwire.md %}), and a line in the [competitor positioning]({{ site.baseurl }}{% link research/competitors.md %}). The tripwire's payoff of 5 is now backed by sources; feasibility stays at 3 until T9, T17 and T18 report. |
| 2026-10-15 | Added [Is the problem worth solving?]({{ site.baseurl }}{% link research/problem-check.md %}): drones cause about 80% of casualties, troops survive mainly by staying underground, and radio detectors miss fibre-optic FPVs. Anduril's WISP is not in use at the front. No source says how much warning troops need. Zvook's NW0 acoustic FPV sensor (Jan 2026) added to competitors. New test T18: ask front-line users before building more. |
| 2026-10-15 | Tripwire: treated the radio problem as engineering. New section [Getting alerts out of the trees]({{ site.baseurl }}{% link models/tripwire.md %}#getting-alerts-out-of-the-trees): windbreak belts are 10–49 ft wide and cost a few dB each on paper, so a listen-only receiver placed by hand at the edge of the unit's tree line, raised and wired back to the dugout, may carry what a receiver under the trees can't, with nothing at the unit transmitting. Added [Questions we've weighed]({{ site.baseurl }}{% link models/tripwire.md %}#questions-weve-weighed) (hands or a drone, whether it's worth it, retrieving listeners, a central anchor, predicting radio range), a [simulation method and nearest research]({{ site.baseurl }}{% link research/open-questions.md %}#predicting-it-before-the-field-test) for T9, a windbreak run to T9 and test T17. |
| 2026-10-15 | Considered a reader's suggestion: anchor nodes to one central node instead of GPS on every node. Added a [short note]({{ site.baseurl }}{% link models/tripwire.md %}#solving-the-field-limits-at-no-extra-cost) to the tripwire (it already works this way and doesn't need ranging), a GPS-jamming risk to [M1]({{ site.baseurl }}{% link models/m01-ground-array-mesh.md %}) and [M3]({{ site.baseurl }}{% link models/m03-single-mic-tdoa.md %}), and test [T16]({{ site.baseurl }}{% link research/open-questions.md %}#t16-positions-and-clocks-without-gps) with published SX1280 ranging results. T15 now lists a time beacon as a sync option. |
| 2026-10-15 | Reorganised the [tripwire]({{ site.baseurl }}{% link models/tripwire.md %}) page into layers: a one-screen summary, the front-line problems and fixes in plain terms, then fold-out sections for the full detail. Listeners are now costed without GPS throughout. |
| 2026-10-15 | Tripwire: [solved the field limits at no extra cost]({{ site.baseurl }}{% link models/tripwire.md %}#solving-the-field-limits-at-no-extra-cost). Nodes drop GPS (about $17–50 each instead of $25–65), friend and foe are sorted by which line trips first plus the unit's flight windows, and alerts carry sound, battery and temperature summaries, so each line becomes a record of drone traffic, jamming, radio range and winter battery life. Proposed, not tested; T12 and T15 updated. |
| 2026-10-15 | Added two research notes: [Front-line conditions in Ukraine]({{ site.baseurl }}{% link research/field-conditions.md %}) (tree lines, seasons, the kill zone, jamming, what infantry use to hear drones) and [Delivery drone]({{ site.baseurl }}{% link research/delivery-drone.md %}) (airframes, ArduPilot missions with drop steps, open-source software, flying under GPS jamming). Fed both into the tripwire and M7, and added tests T14 (laying a line without GPS) and T15 (ignoring friendly drones). |
| 2026-10-15 | Reviewed published ground-level LoRa range measurements for the tripwire's deciding question (T9): likely to work in open ground, unproven in forest. Added the evidence and a field test with pass/fail criteria to Open questions, and updated the tripwire's limits. Tripwire part photos now also show on the tripwire page. |
| 2026-10-15 | Added a Components and MVP section to the drone-laid tripwire: a per-node parts table and a five-step MVP path, linked to the weekend test kit. |
| 2026-10-15 | Added a weekend test kit (parts with photos, an ~$80–90 MVP and a weekend plan) to Open-source projects. Corrected the claim that VolAnti's four-mic board could give bearings. |
| 2026-10-15 | Added a landscape summary to the overview: what exists, what works, what failed and why, and the routes still open. |
| 2026-10-15 | Added a **Payoff** score next to feasibility on the matrix and every model page; added the tripwire to the matrix. Added a research note on open-source projects to build on (Batear, VolAnti, AcousticPrint) and linked it from range, training data and the tripwire. |
| 2026-10-15 | Added the drone-laid tripwire use case: cheap throwaway listeners dropped 1.2–2.5 mi forward by a 3D-printed delivery drone, compared honestly against phones and other sensors. Added tests T9–T13. |
| 2026-10-15 | Sharpened positioning: passive sets us apart from radar, not from cameras like WISP; the real gap is hearing low, non-transmitting drones they can't see, as a short-range early-warning perimeter. |
| 2026-10-15 | Dropped models rated below 3 (M6 perch-and-listen, M8 flying swarm, M11 fibre DAS). Added the passive-only constraint (no radar, nothing emits while listening) and Anduril Lattice as the first integration target. |
| 2026-10-15 | Added competitor analysis (Anduril, DroneShield, Echodyne, Squarehead, Microflown, Sky Fortress, Zvook, MyDefence, Chuyka) and positioning for base/unit protection. |
| 2026-10-15 | Site created. 11 sensor models rated; research notes on existing systems, range/cost model, localization, hardware, datasets, integration, regulation/funding, and a field-test plan. |
