paulrenzi/drone-detection-research/cad/gpt61/document.py

"""Generate current XIAO design notes and a gallery from authoritative reports."""
from pathlib import Path
import json,html,re
from parameters import *
from display_units import us_text,inch,length,mass,volume,density,pressure
R=Path(__file__).resolve().parent;O=R/'out'
m=json.loads((O/'mass_properties.json').read_text());c=json.loads((O/'checks.json').read_text())
old=json.loads((R/'sources/legacy-mass-properties.json').read_text())
pm=json.loads((O/'print_manifest.json').read_text())
def table(head,rows):return '| '+' | '.join(head)+' |\n| '+' | '.join('---' for _ in head)+' |\n'+''.join('| '+' | '.join(str(v) for v in row)+' |\n' for row in rows)
def massrow(n,group='dart'):return next(r for r in m[group] if r['name']==n)
def check(n):return next(r for r in c['checks'] if r['check']==n)
sources=[
 ('S1','Holybro X500 V2 official frame CAD and assembly','https://holybro.com/collections/multicopter-kit/products/px4-development-kit-x500-v2','Unscaled OEM STEP: centre plates, arms, motors, skids, payload rails and clamps; duplicate solids removed, original indices retained. Rail spacing60 mm, CAD OD9.4 mm; design clearance uses catalog10 mm.'),
 ('S2','Holybro motor and prop drawing','https://cdn.shopify.com/s/files/1/0604/5905/7341/files/X500MotorSpec.png?v=1678791632','Conservative260 mm prop swept diameter; fitted plane and4 mm slab thickness remain MEASURE. Translucent swept discs are clearance volumes, not propeller blades.'),
 ('S3','TowerPro SG90 drawing','https://towerpro.com.tw/product/sg90-7/','22.7 x12.2 x27 mm case,32.3 mm tab span,9 g catalog mass and1.8 kg.cm stall torque. Horn, spline, mounting holes and exact batch remain MEASURE.'),
 ('S4','Seeed kit wiki: both OEM STEP archives, schematic and XIAO DXF','https://wiki.seeedstudio.com/xiao_esp32s3_&_wio_SX1262_kit_for_meshtastic/','Native XIAO ESP32S3 STEP and Wio-SX1262-for-XIAO STEP used without scaling. B2B kit connection, USB flashing and underside battery-pad connection are documented here. sources/xiao-manifest.json records exact download URLs and SHA256.'),
 ('S4a','Seeed XIAO ESP32S3 dimensions and pin map','https://wiki.seeedstudio.com/xiao_esp32s3_getting_started/','21 x17.8 mm PCB nominal; D3=GPIO4, D4=GPIO5, D5=GPIO6. Native STEP includes USB-C, BOOT/RESET and WiFi U.FL. Archive top/bottom images identify BAT pads and castellated pins.'),
 ('S4b','Seeed bare kit SKU102010611 and included FPC antenna','https://www.seeedstudio.com/Wio-SX1262-with-XIAO-ESP32S3-p-5982.html','Manufacturer identifies separate WiFi and LoRa antennas and included FPC. No dimensioned antenna drawing was found. Both antenna envelopes, masses and coax lengths are MEASURE. The kit FPC is not the optional195 mm SMA antenna.'),
 ('S4c','Wio-SX1262 radio-module datasheet','https://files.seeedstudio.com/products/SenseCAP/Wio_SX1262/Wio-SX1262_Module_Datasheet.pdf','Bare radio module11.6 x11 x2.95 mm is NOT the complete extension board. Extension outline comes from its kit-specific OEM STEP, not this module envelope.'),
 ('S4d','Rokland XIAO ESP32S3 + Wio-SX1262 kit','https://store.rokland.com/products/seeed-studio-xiao-esp32s3-wio-sx1262-kit-for-meshtastic-lora','Retailer identifies SKU102010611 and links the same kit-specific Seeed Wio STEP and schematic. It supplies no additional antenna dimensional drawing; confirm the actual shipped antenna batch.'),
 ('S5','Samsung INR18650-25R manufacturer specification mirror','https://files.dcpower.eu/datasheets/samsung/INR18650-25R-datasheet.pdf','18.33 +/-0.07 mm diameter,64.85 +/-0.15 mm length,45 g maximum. Keep flat-top cell and existing cradle. Terminal/insulator details and actual mass MEASURE.'),
 ('S6','TDK INMP441 outline','https://product.tdk.com/en/search/sw_piezo/mic/mems-mic/info?part_no=INMP441','Bare IC4.72 x3.76 x1 mm, bottom port0.25 mm. Generic breakout14 x16 x1 mm and its hole/pads/mass remain MEASURE.'),
 ('S6a','TDK AN1124 microphone sealing guidance','https://invensense.tdk.com/wp-content/uploads/2015/02/Recommendations-for-Sealing-InvenSense-Bottom-Port.pdf','Prototype soft film and0.8 mm acoustic cavity are design assumptions; acoustic transfer and water resistance untested.'),
 ('S7','HellermannTyton T18R UV-stable tie','https://www.hellermanntyton.com.br/produtos/abracadeiras-com-serrilhado-interno/t18r/111-01711','100 x2.5 x1 mm strap,80 N catalog minimum loop strength; installed closed loops reconstructed.'),
 ('S8','3M5490 PTFE film tape','https://multimedia.3m.com/mws/media/2522949O/3m-ptfe-extruded-film-tape-5490.pdf','0.09 mm total thickness. Friction coefficient0.12 is an engineering assumption, not a manufacturer specification.'),
 ('S9','Ruthex RX-M2x4 insert CAD','https://www.ruthex.de/products/ruthex-gewindeeinsatz-m2-70-stuck-rx-m2x4-messing-gewindebuchsen','Actual knurled manufacturer STEP.3.6 mm OD,4 mm long;3.2 mm pilot and5.2 mm pocket are design fit choices.'),
 ('S10','M2 hex nut dimensions','https://www.accu.co.uk/hexagon-nuts/655596-HPN-M2-PCN','DIN934 envelope4 mm across flats x1.6 mm height; metal nuts modelled. Dummy traps have side-loading slots.'),
]
support={
 'tail_fin':('Entire broad face down, tabs coplanar','None; constant-thickness panel. Print 16 for four darts.'),
 'tail_collar':('Axial end face down, rod bore vertical','None; open vertical bore and keyways. Print eight for four darts.'),
 'body':('Flat sole down; post and snaps up','Local only: hanger flange and four snap beams. Clear the flexure reliefs.'),
 'pod_shell':('Tray floor/neck flat down, opening up','Local only: rain hood, socket lip and mic guide ledges. Block teardrop ducts.'),
 'pod_lid':('Outside face and FPC backer together on bed','None. Backer top is coplanar with lid outside face.'),
 'usb_cap':('Outside flange face down, skirt up','None.'),
 'plate':('Deck underside down, four towers up','None; hollow towers and tie bridges are designed in CAD.'),
 'rotor':('Head-support face down, hub up','None.'),
 'fit_coupon':('Four linked block bases down','None; bores5.9/6.0/6.1/6.2 mm increase inX.'),
 'stake_adapter':('Flat bracket base down; V saddles up','None; small tie-channel bridges; offcut saddle is open.'),
 'stake_cell_holder':('Flat cradle sole down, snap arms up','Local only under snap beams, as on body.'),
 'dummy_body':('Flat sole down, pockets up','Local only under hanger flange; nut slots bridge4.3 mm.'),
 'dummy_lid':('Outside face down','None.'),
 'dummy_head_insert':('Floor down, ballast pockets up','None.'),
}
compare=[('Dart, g',old['dart_total_g'],m['dart_total_g']),('Harness, g',old['harness_total_g'],m['harness_total_g']),('Four darts + harness, g',old['carried_payload_g'],m['carried_payload_g']),('Hanger from tip, mm',old['hanger_x_mm'],m['hanger_x_mm'])]
compare.insert(0,('Populated processor/radio boards, g',next(r['mass_g'] for r in old['dart'] if r['name']=='Heltec_with_OLED'),M.xiao_mass+M.wio_mass))
compare.insert(1,('Printed pod shell/lid/cap, g',sum(r['mass_g'] for r in old['dart'] if r['name'] in ('pod_shell','pod_lid')),sum(r['mass_g'] for r in m['dart'] if r['name'] in ('pod_shell','pod_lid','usb_cap'))))
doc='# XIAO listener and X500 release harness: first-print revision\n\n'
doc+='## Changes from the Heltec version\n\n'
doc+='The incorrect Heltec/OLED package has been replaced throughout the current assemblies, renders and web models by the owned Seeed XIAO ESP32S3 + Wio-SX1262 kit. The original brief and downloaded legacy sources are retained as history. Old model outputs have been removed.\n\n'
doc+=table(['Model estimate','Old Heltec package','New XIAO package'],[(n.rsplit(', ',1)[0],length(a,3) if n.endswith(', mm') else mass(a),length(b,3) if n.endswith(', mm') else mass(b)) for n,a,b in compare])
doc+='\nPer the firmware brief, the listener reports alive by radio once per minute. That heartbeat replaces a visual status indication. Native OEM CAD may retain inactive onboard component bodies; no added LED, display or battery-divider circuit is fitted. A smaller cell could reduce nose mass, but its runtime and impact retention need testing; the specified18650 remains in the real listener models.\n'
doc+='\nThe electronics tray is now46 x32 mm rather than82 x36 mm, with a narrow socket neck that preserves the500 mm rod and raises the sound port to500 mm above soil (previously470 mm). There is no display window, added status LED or voltage-divider part. A removable end cap exposes USB-C and pin access to both BOOT/RESET buttons. Three lid screws replace four; the kit LoRa FPC sits on a light integral top backer. Five mic wires and direct underside BAT connections replace the old board wiring. A stake adapter, separate18650 stake cradle and an inert ballasted dummy are included.\n\n'
doc+='**Nothing has been printed, drop-tested or flown.** These are nominal geometry and mass estimates, not measured hardware qualification. The actual kit stack spacing, microphone breakout, antenna dimensions, printed fits and filament properties still require measurement. No self-righting, soil penetration, waterproofing, acoustic or radio range result is claimed.\n\n'
doc+='## Files and reproduction\n\n[REVIEW.html](REVIEW.html) indexes all current renders. `out/` contains twelve printed STEP/STL pairs, current bought-part CAD, carried/mid-release/stood aircraft assemblies, a stood dart, stake and dummy assemblies, mass/check reports, print manifest and `print-kit.zip`. All STLs are already placed onZ0 in the intended Vyper print orientation; STEP files retain assembly datums. Eighteen functional printed pieces make four real darts and one harness; the coupon, stake and dummy parts are optional alternatives/tools.\n\n'
doc+='```powershell\n'
for script in ['fetch_sources.py','fetch_xiao.py','build.py','validate_exports.py','web_export.py','document.py','record_visual_review.py --reviewed','validate_package.py','package.py']:
 doc+=f"& 'C:\\Users\\paulm\\.venvs\\cad\\Scripts\\python.exe' cad/gpt61/{script}\n"
doc+='```\n\nInspect every newly generated PNG before running `record_visual_review.py --reviewed`; that command records an explicit inspection attestation and cannot perform visual review itself. All scripts write only in this package. `build.py --render-only`, `--exports-only` and `--verify-only` reuse its generated cache. Rebuild normally after any dimension/mass/source change. `sources/manifest.json` and `sources/xiao-manifest.json` retain source URLs, sizes and hashes.\n\n'
doc+='## Primary source register\n\n'
for key,title,url,details in sources:doc+=f'- **{key}: [{title}]({url}).** {details}\n'
doc+='\nNative CAD inspection reports are `sources/xiao-cad-inspection.json` and `sources/wio-cad-inspection.json`. XIAO PCB envelope in its original model is20.955 x17.780 mm; USB projection makes the full length22.482 mm. Wio extension PCB envelope is21.440 x17.780 x1.6 mm, including its outline tab; its supplied model spans7.3 mm vertically including the underside connector. Neither CAD has been scaled to make the nominal21 mm dimension fit. The source XIAO model lacks a resolved mating B2B connector, so its envelope is reconstructed and flagged MEASURE.\n\n'
doc+='## Pod, wiring and service\n\nThe46 x32 mm rounded tray has1.6 mm walls and floor,17 mm seam height and2 mm lid. Its narrow13.6 mm socket neck extends fromX480 to539; the rod enters20 mm and stops atX500. The hollow riser carries the two power wires from the rod to the shorter electronics tray, which begins atX536. This axial neck is needed because a500 mm rod buried70 mm ends only430 mm above soil, while the mic must be at500 mm. Reducing tray length without this offset would lower the microphone.\n\n'
doc+='The XIAO rests on four underside edge supports. The Wio extension plugs into the kit B2B connector above it; the model places Wio PCB bottom atZ10.5, with an11.55 mm overall stack envelope. The7.5 mm mating offset is MEASURE; verify it before printing. Lid fingers compress four1 mm foam pads against Wio PCB edges, away from the RF can. No soldered tall pin headers are fitted. Locating fences have about0.3 mm clearance outside the XIAO edges.\n\n'
doc+='The mic board stands along the negativeY wall, with its bottom port atX570,Z8. Its actual port is500 mm above the body soil stop. A4 mm cavity,0.8 mm annular silicone spacer and0.05 mm soft prototype film connect it to the side opening under an integral45degree rain hood. Breakout dimensions and pad/hole placement are MEASURE. Do not assume the waterproof/acoustic performance of this untested membrane.\n\n'
doc+=table(['INMP441 connection','XIAO pad','GPIO'],[('SCK / BCLK','D3','4'),('WS / LRCLK','D4','5'),('SD / data','D5','6'),('VDD','3V3','Supply'),('GND and L/R select','GND','Ground')])
doc+='\nFive short insulated wires are modelled; the microphone L/R select is a local solder bridge to ground, not a sixth long wire. Wire dress and exact solder points remain MEASURE. The long cell pair runs in the original body gutter and along the rod, enters the socket neck through relieved ducts and terminates at the XIAO underside BAT+/BAT- pads. Sourced bottom-view images identify these pads; their small copper envelopes/centres are reconstructed. The XIAO charger does not provide a mechanical battery connector. Use factory-welded insulated cell leads, never solder directly to the can. Verify the actual cell protection arrangement; charger presence alone does not establish pack protection.\n\n'
doc+='The kit LoRa FPC has an explicitly unmeasured100 x10 x0.3 mm nominal envelope; its separate U.FL coax exits a2.2 mm gland above the microphone. A1.2 mm PETG backer extends from the lid, with small tape/tie slots; its outer face is coplanar with the lid so both print flat together. The socket neck floor is also coplanar with the tray base; its teardrop duct has at least1.7 mm roof thickness. Strain-relieve the coax before it reaches U.FL, and seal the gland with removable neutral-cure silicone. The separate WiFi/BLE FPC is on the positiveY wall. Do not replace these with the optional195 mm SMA antenna without recomputing mass, balance and clearance. The default overall dart length is686 mm; the larger figure than the old644 mm package comes from the deliberately provisional FPC envelope.\n\n'
doc+='A19 x14 mm end opening gives access to USB-C and a0.7 mm pin path to either button with the printed cap removed. The cap has0.3 mm skirt clearance and a1.2 mm overlapping flange. Seal its perimeter with a removable thin silicone bead or weather tape; it is a prototype service closure, not a tested IP seal. The full pod lid need not be removed to flash. Cable overmould envelope11 x6.2 mm is MEASURE. The lid perimeter has a1.5 x0.9 mm gland for1.2 mm cord (25% nominal compression); three RX-M2x4 inserts and M2x6 screws clamp it. RTV, solder and service tape are not resolved as exact solids or weighed consumables.\n\n'
doc+='## Body, balance and harness\n\nThe body retains the specified6 x500 mm fibreglass spine,70 mm nose/soil stop, flat-top18650 open snap cradle, axial sleeve, integral post and wire gutters. Three short5.95 mm nominal press lands sit in a6.35 mm relieved teardrop bore; the coupon determines the actual fit. Four1.2 mm thick,18 mm long cantilevers retain the cell through a16.8 mm throat with lead-in ramps. Axial end walls take impact load rather than the flexible latch tips. The rod tip is a12 mm cone with a0.6 mm blunt point for the nominal CAD envelope.\n\n'
doc+=f"The mass solver moves the post and its sleeve until its X/Y axis agrees with the recomputed dart centre of mass. The nominal CG is **({', '.join(inch(v,3) for v in m['dart_cg_mm'])}) in**; the hanger is **X {length(m['hanger_x_mm'],3)}, Y {length(m['hanger_y_mm'],3)}** from the tip/rod datum. Residual X error is {m['balance_residual_mm']/25.4:.6f} in. This numerical residual is not a real assembly tolerance; weighed stock and printed mass control actual balance.\n\n"
doc+='The existing harness geometry is retained after rechecking the finned darts and their moved hangers:83 mm deck radius,3.2 mm deck,48..51 mm bearing ridge,64.9 mm rotor radius,3.2 mm rotor web and20degree release gaps. Slots are20.4 x15.4 mm for13 mm heads and5 mm necks. The pilot has0.25 mm radial clearance. Payload rail centres are60 mm apart; saddles use10.6 mm seats and four T18R ties. Tall towers are explicitly hollow CAD geometry, not a density multiplier.\n\n'
doc+='The load path remains head -> rotor rim -> PTFE-covered bearing ridge -> plate -> saddles/rails. The SG90 stock horn drives two18 mm-spaced M2 studs with axial slip; a keeper washer has0.4 mm running gap and does not clamp the rotor onto the servo shaft. The model checks the case, horn, nuts, pilot and rotor throughout the release sequence. Dart1 releases at16degrees, dart3 at32, dart2 at48 and dart4 at64. Servo travel, torque under friction, creep and shock remain physical qualification items.\n\n'
doc+='## Masses and print settings\n\n**Recommended prototype infill is100% for every printed part, including the plate.** This is intentional: load-carrying skins/ribs and small fit features should be solid for the first test; large lightening pockets and tower cores are already removed in CAD. The plate estimate is its actual model volume times1.27 g/cm3 PETG, with no hidden35% or other infill multiplier. A lighter slicer profile would require a fresh sliced/printed mass and structural assessment. No slicer has been run and no part has been weighed; actual extrusion width, perimeter overlap, holes and filament density will change the result.\n\n'
printed_rows=[r for r in m['dart']+m['harness'] if r['name'] in ('body','pod_shell','pod_lid','usb_cap','plate','rotor')]+m['auxiliary_printed']
doc+=table(['Printed design','Mass at 100%','CAD volume'],[(r['name'],mass(r['mass_g']),volume(r['volume_mm3'])) for r in printed_rows])
doc+='\n'+table(['Assembly','Nominal mass'],[('One real dart',mass(m['dart_total_g'])),('Harness including servo/hardware/ties',mass(m['harness_total_g'])),('Four real darts + harness',mass(m['carried_payload_g'])),('Inert dummy with ballast',mass(m['dummy']['total_g']))])
doc+=f"\nComplete stake installation, including the full1219.2 mm nominal10 mm stake and18650: **{m['stake']['total_g']:.3f} g**. Stake density and all small-stock masses are unmeasured; this total is separate from flight payload.\n"
doc+='\nFull per-component grams, volumes, assumptions and XYZ centroids are in [out/mass_properties.csv](out/mass_properties.csv) and [out/mass_properties.json](out/mass_properties.json), including auxiliary printed and dummy parts. Board masses2.2 g XIAO/1.8 g Wio,1 g mic,0.8 g LoRa antenna and0.35 g WiFi antenna are unmeasured estimates; the45 g cell figure is a datasheet maximum. Hardware uses nominal material density and shape centroids. Solder, final adhesive, tape and small protection/connector additions require a weighed allowance before qualification.\n\n'
doc+='Four-dart kit bought hardware:\n\n'+table(['Item','Quantity'],[('6 x500 mm fibreglass rods','4'),('XIAO ESP32S3 + Wio-SX1262 kits, with both FPC antennas','4'),('INMP441 breakouts','4'),('Flat-top18650 cells with factory-welded insulated leads','4'),('SG90 positional servo and supplied double horn','1'),('RX-M2x4 heat-set inserts','12'),('M2x6 pod screws + servo tab screws','12 +2'),('M2 drive studs, nominal10 mm; nuts for drive and servo','2 studs;6 nuts'),('Measured-thread keeper screw, spacer and washer','1 each'),('T18R ties: body/rod + rails','12 +4'),('1.2 mm cord, mic film/cavity seals and foam pads','4 pod sets'),('PTFE bearing film','1 annular strip'),('Power pair and5 short mic wires','4 wired sets')])+'\nStake option adds one40 mm fibreglass offcut and five installation ties; it reuses one complete pod and one cell. Dummy option adds two M2x8 screws, two M2 nuts and the four weighed ballast portions. `out/kits.json` lists printed quantities separately for each option.\n\n'
doc+='Use the Anycubic Vyper245 x245 x260 mm, dry PETG,0.4 mm nozzle,0.20 mm layers, four perimeters, six top/bottom layers and100% infill. Start within the filament manufacturer temperature range (typically235C nozzle/80C bed), then tune adhesion and fit. Use slow external walls and first layer; do not let supports lock snap reliefs or fill teardrop ducts. All supplied orientations fit the bed.\n\n'
doc+=table(['Part','Kit/optional qty','Print bounds in','Orientation','Supports'],[(r['part'],r['quantity'], ' x '.join(inch(v) for v in r['print_bbox_mm']),*support[r['part']]) for r in pm])
doc+='\n## Hand-placed stake adapter\n\nUse a48 in (1219.2 mm) fibreglass garden/driveway stake. `Measurements.stake_d` is the single unmeasured OD parameter, default10 mm. Two90degree V saddles with independent zip ties accept8..13 mm without reprinting; the circle axis rises as radius*sqrt(2), and all three nominal/end-point sizes are intersected against the clamp. No nominal10 mm closed bore is being passed off as an adjustable clamp. A short5.8..6 mm fibreglass offcut (40 mm long) joins the adapter sleeve to the same pod socket; the external bracket stays clear of the pod neck.\n\n'
doc+='Place the pod midway up the stake, not on its1.2 m top. Insert the stake by hand, then slide/tie the adapter until the actual mic port is500 mm above the actual soil. The depicted burial is100 mm only; insertion depth does not determine port height. A separate retaining tie goes around the pod neck and stake through its own adapter tunnel; the offcut is a locator, not a friction-only restraint. Two additional ties hold the separate printed18650 snap cradle lower down (five stake-installation ties total). This retains the owned cell and direct BAT wiring rather than assuming a USB power bank stays awake at the listener load. The stake battery holder is an optional replacement for the flying body, not extra flight mass. Its cell/cable configuration is shown in stake_assembled.step and stake.glb.\n\n'
doc+='## Inert drop-test dummy\n\nThe dummy uses the same6 x500 mm rod, hanger location, pod shell/lid/service cap and external FPC backer. A closed twin-pocket ballast cassette replaces the cell cradle inside the dummy body; there is no cell, microphone or electronic stack. A small two-pocket printed head insert replaces the boards. The external backer is retained for approximate shape, while the flexible FPC itself is omitted; matching mass/CG does not match exact aerodynamic flexibility or inertia. Two M2x8 screws and side-loaded M2 captive nuts close the body ballast lid. Foam and adhesive retain the four weighed ballast portions; include their mass within the listed target portions.\n\n'
d=m['dummy']
doc+=f"Empty dummy assembly estimate: **{mass(d['baseline_mass_g'])}**. Add **{mass(d['ballast_total_g'])}** total steel ballast to target **{mass(d['total_g'])}** and CG **({', '.join(inch(v,3) for v in d['cg_mm'])}) in**. All three model moment residuals are below 0.00004 in.\n\n"
doc+=table(['Pocket','Weighed steel + fixative','Required centre XYZ in','Equivalent solid-steel block in'],[(b['name'],mass(b['mass_g']),', '.join(inch(v,3) for v in b['centroid_mm']),' x '.join(inch(v,3) for v in b['equivalent_solid_steel_bbox_mm'])) for b in d['ballast']])
doc+='\nSteel density7.85 g/cm3 sets only the equivalent CAD blocks. Steel nuts, washers or shot can be used if their combined weighed mass and packed centre match the table. Locate each portion with foam spacers; immobilise it so impact cannot move the balance. Avoid loose shot. Pocket clearance and positive capacity are checked from the model. Weigh the actual empty print, solve again with measured values, and compare to the actual real dart target; the numerical nominal match alone is insufficient. Use the dummy for controlled bench release and soil drops to determine whether it turns nose-down, when rotation begins, whether it sticks and whether the snaps/post/rod survive. No model result demonstrates these behaviours.\n\n'
doc+='## Checks, limits and assembly\n\n'
doc+=f"Current run: **{len(c['checks'])-len(c['failed'])}/{len(c['checks'])} checks pass**. [checks.md](out/checks.md) and [checks.json](out/checks.json) retain every value and scope; STEP/STL round trips and topology are in [export_validation.json](out/export_validation.json).\n\n"
doc+='Local board/mic/lid/cap/wire/ballast fits use actual B-rep intersection volumes with a0.02 mm3 threshold. Rod press lands, inserts, threads/solder and compressed soft seals have declared intended contact. Frame/prop/leg/ground checks use current exterior parts including the long FPC backer. Vehicle distance numbers are conservative AABB lower bounds; zero does not mean a measured zero gap. Rotor/head contact uses0.5degree samples, rotor/body sweep2degree, extraction0..90 mm in5 mm steps, and prescribed later pitch0..90degrees in5degree steps. These are discrete geometric checks, not a continuous or aerodynamic proof.\n\n'
doc+=table(['State','Scope'],[('Carried','Four changed darts against frame/rails,260 mm prop sweeps, skids, harness, ground and each other.'),('Mid-release','Rotor16degrees; dart1 translated70 mm down, three carried. Included in extraction sweep.'),('After extraction','Pitch begins only after430 mm downward translation with aircraft1500 mm above stock ground. No claim that real fall timing follows this path.'),('Stood','70 mm rod penetration, body soil stop atZ0, microphone500 mm up. Parked aircraft and three carried darts are offset650 mm from the stood dart for end-state review.'),('Stake','Adapter at8/10/13 mm stock diameters; mic500 mm above soil; separate cell holder.'),('Dummy','Mass and all three moments matched; all four ballast blocks fit their pockets.')])
doc+='\nAssembly order:\n\n'
steps=[
 'Measure the actual XIAO/Wio stack, kit FPC antennas, mic breakout, servo, cell and rod. Confirm the aircraft rail/clamp arrangement against the OEM model. Print the fit coupon and tune rod_fit_bore before the long body.',
 'Print in supplied STL orientations. Remove local supports and deburr; verify every snap flexes independently and the cell wrap cannot touch a sharp edge. Dry-fit with an inert cell-sized gauge.',
 'Heat-set three M2 inserts per pod. Seat the mic film and annular seal, install the breakout with port facing the hood and add its soft preload pad. Do not fill the acoustic cavity with rigid adhesive.',
 'Solder BAT wires to underside pads before installing the XIAO. Connect INMP441 to D3/D4/D5/3V3/GND and bridge L/R to ground for the selected channel. Keep headers off; inspect solder for shorts. Plug in Wio via B2B and connect the correct LoRa and WiFi U.FLs.',
 'Seat the stack on edge supports, dress all five short wires and route cell leads through the neck/gutter strain reliefs. Fit the supplied FPC to the backer without creasing its feed. Seal gland/rod entry with removable neutral-cure silicone.',
 'Slide body until its nose is70 mm from the sharpened tip. Snap the factory-wired flat-top18650 into the retained cradle; insulate terminals, fit strain relief/body tie and two rod ties. Press the pod onto the final20 mm of rod.',
 'Fit perimeter cord and foam pads, close the lid with three M2x6 screws and install/seal the USB cap. Remove only the cap for flashing; use a pin for BOOT/RESET if needed. Check actual plug/pin reach before final sealing.',
 'Weigh and balance a completed dart. Update the model if the real balance differs materially from the integral hanger; source estimates are not permission to ignore that difference.',
 'Mount SG90 below the plate using two M2 nuts/screws. Fit stock horn, two round M2 drive studs and locking nuts, PTFE bearing film, rotor and loose axial keeper. Match replacement screw thread to the actual servo; never clamp payload load into its shaft.',
 'Tie four saddles to the rails. Route servo cable through the fixed gutter; use Pixhawk AUX1 signal, regulated servo supply and common ground. Calibrate0/16/32/48/64degree positions with inert loads. Load in reverse release order.',
 'For stake use, fit a40 mm offcut between adapter and pod, tie V saddles to the stake, set the actual mic height to500 mm, and fit the lower cell holder and insulated leads.',
 'For dummy use, fit/immobilise each weighed ballast portion, side-load the two nuts, screw the body lid down and retain head weights under the pod lid. Confirm actual total mass and balance before release tests.',
 'Record bench cycling, proof load, vibration, water/acoustic tests and controlled dummy drops before any field release qualification. The present package has completed none of these physical tests.',
]
for i,step in enumerate(steps,1):doc+=f'{i}. {step}\n'
doc+='\n## Open MEASURE inputs\n\nThe central Measurements dataclass includes sourced stock nominals requiring incoming inspection as well as fully unmeasured estimates. Highest-priority unknowns are B2B spacing, exact kit antenna envelopes/weights, microphone breakout/port, BAT pad location, wire dress, cell/rod/filament mass and printed friction/fit. The garden stake OD is one parameter; clamp geometry spans8..13 mm.\n\n'
def measure_display(key,value):
 if key.endswith('_mass'):return mass(value)
 if key.endswith('_density'):return density(value)
 if key=='petg_modulus':return pressure(value)
 if key in ('printed_allowable_strain','sg_spline_teeth'):return str(value)+(' (strain)' if key=='printed_allowable_strain' else ' teeth')
 return length(value,3)
doc+=table(['Parameter (internal name unchanged)','Nominal input, US display'],[(k,measure_display(k,v)) for k,v in measure_dict().items()])
doc+='\n## Exploded web models and visual review\n\n`web_export.py` writes dart, harness, aircraft and stake GLBs in metres withY up, using named physical-part nodes and an8-second `explode` clip. Dart/harness/aircraft views expose the populated board stack, mic, cap, lid, seals, wiring and hardware; aircraft first lowers its loaded harness400 mm. The stake clip withdraws the retained pod subassembly100 mm from the offcut. This is an illustration: disconnect wires, cut disposable ties and unscrew hardware in actual service. Motion does not simulate threads, flexures, cables, falls or continuous collision-free disassembly.\n\n'
doc+='The current mass report supplies per-node mass estimates and source/uncertainty facts in `web/manifest.json`. Servo/horn share the9 g catalog mass; aircraft solid masses remain null. `validation-readback.json` checks every sampled animation translation and loads each GLB with trimesh; `validation-khronos.json` holds Khronos results. `exploded_checks.json` checks independent endpoint subassemblies for overlap. Full-resolution STEP/STL files remain the manufacturing geometry.\n\n'
doc+='Every final PNG is listed in REVIEW.html. Visual inspection covers all assembled, sectioned, exploded and print orientations; a per-file review receipt is stored in `out/visual_review.json` after inspection. No visual claim replaces a physical fit test.\n'
doc=re.sub(r'\b(now|than|the|preserves|to|separate|nominal|at|about|from|with|one|four|two|three|full|into|by|below|above|is|original|actual|all|use|per|includes|diameter|only|around|and|before|after|ends|begins|every)(?=\d)',r'\1 ',doc)
for a,b in [('onZ0','on Z0'),('withY up','with Y up'),('positiveY','positive Y'),('negativeY','negative Y'),('negativeY','negative Y'),('along +X','along +X')]:doc=doc.replace(a,b)
# Legacy coordinate literals had an implicit model unit; make it explicit before
# converting prose. Datum labels such as Z0 elsewhere remain named references.
for a,b in [('fromX480 to 539','from X 480 mm to X 539 mm'),('atX500','at X 500 mm'),('atX536','at X 536 mm'),('atZ10.5','at Z 10.5 mm'),('atX570,Z8','at X 570 mm, Z 8 mm')]:
 doc=doc.replace(a,b)
doc=doc.replace('Use a48 in (1219.2 mm)','Use a 48 in').replace('its1.2 m top','its 48 in top')
doc=doc.replace('Full per-component grams, volumes','Full per-component machine-unit masses, volumes')
doc=doc.replace('full1219.2 mm','full 48 in')
source_start=doc.index('## Primary source register')
source_end=doc.index('## Pod, wiring and service')
doc=us_text(doc[:source_start])+us_text(doc[source_start:source_end],quote_metric=True)+us_text(doc[source_end:])
unit_note='''## Display and file units

All dimensions in these notes and render labels use decimal inches; most dimensions use two decimals, and fits, clearances, tolerances and thin walls/film use three. Numerical solver residuals retain extra digits to avoid hiding the nominal match. Mass is in ounces to two decimals, or pounds for totals above one pound; small volumes retain significant digits. Densities are in lb/in³ with the original g/cm³ reference. Source metric figures appear in parentheses only in the source register; nozzle and layer settings retain the explicitly requested metric labels. Sold part names M2, M2x6, M2x8, M3, RX-M2x4, 18650, INR18650-25R, SG90, T18R and DIN934 are unchanged. Source and history files retain their original wording.

**The model and manufacturing units have not changed.** STEP and STL files stay in millimetres; slicers read STL as mm, so rescaling would break printing. GLBs stay in metres, as required by glTF. Machine-readable JSON/CSV field names and values stay unchanged, including `mass_g` in `web/manifest.json`. `parameters.py` and the build code still compute in millimetres internally. `display_units.py` converts captions and human reports only. Geometry, cameras and colours are preserved.

'''
unit_note=unit_note.replace('field names and values stay unchanged','field names and unit conventions stay unchanged; numeric values follow the revised geometry').replace('Geometry, cameras and colours are preserved.','The tail-fin revision changes geometry and recomputes its dependent numeric values.')
doc=doc.replace('twelve printed STEP/STL pairs','fourteen printed STEP/STL pairs').replace('Eighteen functional printed pieces','Forty-two functional printed pieces')
doc=doc.replace('The dummy uses the same','The dummy includes the same four fins, two collars and cured bond allowance, and uses the same')
doc=doc.replace('Press the pod onto the final','Fit and bond the tail collars and fin tabs as described above, keeping the wire relief clear; then press the pod onto the final')
from tail_notes import section as tail_section
ta=json.loads((O/'tail_analysis.json').read_text())
doc=doc.replace('## Body, balance and harness',tail_section(ta,m,c)+'## Body, balance and harness')
doc=doc.replace('## Files and reproduction',unit_note+'## Files and reproduction')
doc=doc.replace('## Changes from the Heltec version','The current tail-fin revision adds four flat-print panels and two keyed collars per dart, moves the hanger to the new balance point and re-solves the inert dummy. Pressure and wind figures below are estimates; no fall has been tested.\n\n## Changes from the Heltec version')
(R/'DESIGN.md').write_text(doc,encoding='utf-8')
images=sorted((R/'renders').glob('*.png'))
gallery=''.join(f'<figure><a href="renders/{html.escape(p.name)}"><img loading="lazy" src="renders/{html.escape(p.name)}" alt="{html.escape(p.stem.replace("_"," "))}"></a><figcaption>{html.escape(p.stem.replace("_"," "))}</figcaption></figure>' for p in images)
page=f'''<!doctype html><html lang="en"><meta charset="utf-8"><meta name="viewport" content="width=device-width"><title>XIAO listener CAD review</title><style>body{{font:16px system-ui;margin:0;background:#edf2f5;color:#193443}}header{{padding:30px 5%;background:#102d3b;color:white}}a{{color:#08738c}}header a{{color:#9de7ee}}main{{max-width:1600px;margin:auto;padding:24px}}.grid{{display:grid;grid-template-columns:repeat(auto-fit,minmax(420px,1fr));gap:20px}}figure{{margin:0;background:white;border-radius:10px;overflow:hidden}}img{{width:100%;height:430px;object-fit:contain}}figcaption{{padding:14px;font-weight:600}}.note{{padding:18px;background:#fff9e6;margin-bottom:24px}}@media(max-width:500px){{.grid{{display:block}}figure{{margin-bottom:18px}}}}</style><header><h1>XIAO listener · prototype mechanical review</h1><p>{m['dart_total_g']:.2f} g/dart · hanger{m['hanger_x_mm']:.2f} mm from tip · {m['harness_total_g']:.2f} g harness · {m['carried_payload_g']:.2f} g four-dart payload</p><a href="DESIGN.md">Design, sources and assembly</a> · <a href="out/checks.md">Geometry checks</a> · <a href="out/print-kit.zip">Print kit</a> · <a href="web/manifest.json">Web models</a></header><main><div class="note">Seeed XIAO ESP32S3 + Wio-SX1262. Mic500 mm above soil. Stake adapter and inert ballast dummy included. Nominal CAD only: nothing printed, dropped or flown; antenna/stack/fit measurements remain open.</div><div class="grid">{gallery}</div></main></html>'''
(R/'REVIEW.html').write_text(us_text(page),encoding='utf-8')
print('DESIGN.md and REVIEW.html generated;',len(images),'current renders')
