paulrenzi/drone-detection-research/(commit log)

2026-10-15 Initial research notebook: low-cost acoustic drone detection
    11 sensor models with feasibility ratings, research notes, field-test plan.
2026-10-15 Restyle the site in the light owners-update look
    Warm paper ground, ink rules, rust accent, Inter + IBM Plex Mono, square
    corners; dark hero on the overview and score chips on the matrix. Done with
    Just the Docs' own hooks: a custom color scheme, custom.scss, head_custom
    and title includes.
2026-10-15 Build the site to the canvas design, not just recolor the theme
    Own default layout: full-width masthead (wordmark, search, repository),
    framed page on the paper ground, in-flow section nav with mono labels, and
    a collapsible menu on phones. Overview gets the hero tag, stat strip,
    numbered kickers, design headlines, score chips by rating and the
    competitor-analysis button. Search, breadcrumbs, heading anchors and
    child-page lists still come from Just the Docs.
2026-10-15 Add drone-laid tripwire use case page
2026-10-15 Add weekend test kit for training audio to open-source builds
    Parts list with photos, what each part is for, an ~$80-90 MVP built on
    Batear and Heltec V3 boards, and a Friday-to-Sunday recording and
    training plan. Corrects the claim that VolAnti's 79 mm four-mic board
    could give bearings.
2026-10-15 Kit photos: pad the camera-drone photo, drop an unused image
2026-10-15 T9: review published LoRa range evidence and design the field test
    Published near-ground measurements show over 4 km in open line of
    sight (antennas at 1.5 m) but 1 km or less in forest, mostly 50-250 m.
    Open-ground reporting looks likely; the forest case is unproven. Adds
    the evidence, the field test and pass/fail criteria to Open questions,
    updates the tripwire's limits and rating history (still 3).
2026-10-15 Tripwire: solve the field limits at no extra cost
    Drop the node GPS, sort friend from foe by line order and flight
    windows, and carry sound, battery and temperature summaries in
    existing packets so each line records drone traffic, jamming, radio
    range and winter battery life. Proposed, not tested; T12 and T15 updated.
2026-10-15 Tripwire: reorganise the page into layers
    One-screen summary and the front-line problems in plain terms up top,
    then fold-out sections for the full detail. A small script opens the
    section holding any linked anchor, plus an open/close-all button.
2026-10-15 Tripwire: get alerts out of the trees with a wired edge receiver
    Treats the radio problem as engineering: windbreak belts are 3-15 m wide
    and cost a few dB each on Weissberger's model, so a listen-only receiver
    placed by hand at the edge of the unit's tree line, raised and wired back
    over RS-485, may carry what a receiver under the trees cannot, with
    nothing at the unit transmitting. Adds a Questions we've weighed section
    (hands or a drone, worth it, retrieval, central anchor, predicting
    range), a simulation method and nearest research for T9, a windbreak
    run E with a pass line, and test T17.
2026-10-15 Add what a minute of warning buys against fibre-optic FPVs
    Sourced table of the defences troops use (cover, shotgun teams,
    net-guns, AI turrets, nets, cable traps, interceptors, lasers) and
    whether warning helps each. Mostly it buys avoidance and readiness.
    T18 now asks which moments matter; the tripwire no longer claims a
    minute lets a unit launch an interceptor.
2026-10-15 Add tree-edge distance gap, T18 terrain questions, wired-leg note
    No published figure gives how far positions sit from a tree-line edge;
    field-conditions now says so with the sourced context and labelled
    inference. T18 asks terrain and distance to the edge. The tripwire notes
    the wire works in every terrain and the open risk is T9 run E.
2026-10-15 Rebuild competitor page as cost-vs-achievement priority list
    Read research papers, RUSI reports, procurement sources and competitor
    listings in full. Zvook NW0 is on sale at ~$834-950 per sensor; added
    RADD, Komodo, Russian detectors and fibre catchers; added a table of
    measured ranges (cheap mics ~50-60 m on consumer drones, no FPV data)
    and flagged the impact on tripwire listener counts.
2026-10-15 Correct false "not cheaper than NW0" claim; fix asymmetric comparisons
    9375b42 compared NW0 at its maker-claimed range against our cautious
    measured range. Per sensor we are roughly 3-50x cheaper ($17-50 listener,
    ~$125-300 hand-placed node vs $834-950 NW0 plus 15-18 W of power).
    Cost per position is open until range is measured on both sides.
    Site audit for the same asymmetry: M1 "4-8x cheaper" than Sky Fortress
    (parts estimate vs field cost), overview node price and Squarehead range
    labels, tripwire comparison assumptions note, stale "no price" for NW0.
2026-10-15 Add build-or-scrap review; DroneAlert, new entrants, jamming risk T19
    Fresh sweep of competitor cost and capability, FPV acoustics, forward
    sensors, counters and the value of warning. Verdict: keep the forward
    tripwire, drop the hand-placed node as a product (DroneAlert lists a
    LoRa acoustic module at ~$211), and settle the rest with T18, T11, T19.
2026-10-15 Compare a minute of warning against the alternatives
    New section on the problem check: how much warning each known defence
    needs (net-guns, shotguns, turrets, smoke, cover, holding movement,
    evacuation, interceptors, lasers, nets), at 0 s, ~5 s, ~15 s and ~1 min,
    with warning per source. Weapons need seconds; a minute buys go/no-go
    calls on movement, which only a forward line gives against fibre-optic
    FPVs. Tripwire no longer pitches a minute as a shooter cue.
2026-10-15 Add CERBAIR MEDUSA as a jammer our network could cue
    Partner component, not a competitor: built to be switched on by a
    detector's cue. Jamming row now credits warning against radio FPVs.
2026-10-15 MVP page: cut to tables and steps, no filler
2026-10-15 MVP page: open Amazon shopping list up top; Amazon first in every layer
    Every Amazon link was opened and checked for an Add to Cart button and a
    price on 2026-10-15. Other shops stay as alternatives. Cells and the PPK2
    stay off Amazon (not sold there / twice the price).
2026-10-15 Handoff: printed hardware and software, the missing half
2026-10-15 Build pages: printed dart, X500 harness, TL-1 carrier, software layout
    - CadQuery models in cad/ with STL, STEP and renders; all parts fit the Vyper bed.
    - Payload/flight estimate: X500 + 4 darts reaches a line ~2.2 km out, TL-1 ~2.8 km.
    - Software: six components, five interfaces, Batear coverage, and its
    shared-key 16-bit nonce defect with a fix.
    [dart_body.step, dart_body.stl, dart_cap.step, dart_cap.stl, dart_hinge.step, dart_hinge.stl, dart_pod.step, dart_pod.stl]
2026-10-16 X500 harness v1: servo horn as the latch, one printed plate
    [dart_cap.step, dart_cap.stl, harness_simple_plate.step, harness_simple_plate.stl]
2026-10-16 Hardware v2: one-rod dart, one-servo rotor harness, half the cost
    The dart is a 6 mm fibreglass rod with three printed parts (cell body, balance
    clip, head pod): no hinge, spring, bolt, pole sections or shock cord. Darts ride
    flat. One SG90 turns a printed rotor; each dart's clip head rests on the rim
    and drops through its own gap at its own 16-degree step. Model checks: every
    dart held until its step and free at it, zero clash at every angle.
    27 parts against 61, parts to buy ~$63 against ~$139, dart ~126 g against
    ~195 g, X500 hover with 4 darts ~11.3-11.8 min (est.). v1 kept, superseded.
    [v2_dart_body.step, v2_dart_body.stl, v2_dart_clip.step, v2_dart_clip.stl, v2_dart_pod.step, v2_dart_pod.stl, v2_plate.step, v2_plate.stl]
2026-10-16 v2 harness render: tighter framing
    [v2_dart_body.step, v2_dart_clip.step, v2_dart_pod.step, v2_plate.step, v2_rotor.step]
2026-10-16 Hardware v3: three parts per dart
    One printed body is the nose, a snap-in cell cradle, a sleeve and the
    hanger, so v2's clip, zip tie and foam are gone. Hangs on v2's harness
    unchanged; the model reruns v2's release and clash checks. 15 parts
    against 27, parts to buy about $50 against $63.
    [v3_dart_body.step, v3_dart_body.stl, v3_dart_pod.step, v3_dart_pod.stl]
2026-10-16 GPT-6.1 CAD brief and handoff
    Paul rejected the Claude-built CAD models; GPT-6.1 (Codex agent) is
    redoing the 3D model from cad/gpt61/BRIEF.md with the concept fixed.
    Run in progress at handoff; sources and run logs are gitignored.
2026-10-16 GPT-6.1 CAD: listener darts and X500 release harness
    Codex (gpt-6.1-sol, xhigh) output from cad/gpt61/BRIEF.md: scripts,
    DESIGN.md, 17 renders, printed-part STEP/STL and checks. The three
    full-assembly STEPs and the X500 reference are over GitHub's 100 MB
    limit; they are gitignored and rebuilt by build.py.
    [body.step, body.stl, bought_18650.step, bought_SG90.step, bought_heltec_v3.step, bought_inmp441.step, bought_rod.step, dart_stood.step]
2026-10-17 Build: 3D models page with an assembled/exploded 3D viewer
    GPT-6.1 (Codex agent, brief in cad/gpt61/BRIEF-exploded.md) added
    exploded views of the dart, the harness and the X500 assembly, and
    web glTF models with an explode animation and named part nodes
    (cad/gpt61/web/, Khronos validator: 0 errors, 0 warnings). Part
    geometry is unchanged.
    New page build-3d.md: a three.js viewer (assets/js/cad-viewer.js)
    to rotate each model, scrub between assembled and exploded, and name
    any part with its mass and function from web/manifest.json; parts
    tables and what the model does not show. build-hardware.md points
    to it; changelog entry added.
    [exploded.py, web_export.py]
2026-10-20 Build: software plan, open-source stack per layer and phased build
    Relay wait is now signal-weighted (Meshtastic rule). Flags Android
    wired Web Serial as untested. Corrects the Al-Emadi dataset licence
    (non-commercial only) and adds two shippable datasets.
2026-10-20 Phase 0 built: I1 tag bytes, hop cap 63, handoff
    Relays re-encrypt under their own nonce, so I2 dedup can't key on the
    origin's nonce; two spare plaintext bytes become the alert tag. The relay
    simulator shows 15 hops is too few for a 30-listener dense-forest line.
    Handoff records the three private repos, what passed, and the open
    cancel-rule decision.
2026-10-20 Add the drone detection playbook and a handoff for the next session
    The playbook is the current authority for the tripwire software:
    architecture, findings, how to run and debug. docs/ is excluded from the site.
2026-10-20 I2 rule 3: cancel a relay only after two duplicates
    Paul's decision 2026-10-19. Spec, plan phase 4 and the playbook updated;
    playbook findings rewritten from the regenerated relay report
    (tripwire-tools 2nd commit of the day on main).
2026-10-21 Refocus the site on the tripwire
    The overview is now the tripwire concept. The sidebar leads with four
    sections: overview, 3D models and downloads, competitors, and weekend
    test and MVP, then the tripwire detail pages. Other sensor models and
    the remaining research notes fold away under collapsed groups.
    - Old overview moved to research/landscape.md
    - 3D viewer gains a looping Play control, on by default unless the
    reader prefers reduced motion
    - 3D page gains a downloads section: print kit, STL, STEP, glTF
    - MVP page opens with the weekend test
2026-10-21 Weekend test: logger page, clip cutter and downloads section
    logger.html reads the Batear gateway and detector over Web Serial, tags
    readings with the current run, tallies range by distance and exports
    runs.csv, events.csv and the raw serial log. cut_clips.py aligns a
    recording on a Sync clap (or a start time) and cuts labelled 1 s clips
    with a manifest, Batear's alarm state per clip and run-level folds.
2026-10-21 Weekend test: embed the logger on demo data, phone mode, speaker analysis
    The weekend section is now a short plan with the logger embedded
    (logger.html?embed=1 runs a scripted demo through the weekend
    distances), a link to the standalone page, and the detail folded into
    collapsible blocks. The logger is mobile-first and can read the gateway
    over WiFi: the gateway publishes to a public MQTT broker from the phone's
    hotspot and the page subscribes over WebSocket, so it works on iPhone
    and Android. Adds the case for a speaker standing in for the drone.
2026-10-21 Speaker test: make_playback.py, a Speaker run type, speaker clip labels
    make_playback.py writes cal.wav from a drone recording, then one 60 s
    looped file per emulated distance (or per level, for a threshold sweep),
    turned down from a single meter reading by the free-field spreading loss
    from the drone's sound power or a measured level. It corrects the reading
    for background, refuses a file that would need more than the calibration
    level, and dithers to 16-bit. The logger gets a Speaker run type reported
    apart from real flights, and cut_clips.py labels those clips
    speaker_<distance>m.
2026-10-21 Saturday test: field layout and the practical fixes
    Speaker 5 m from the mic, logger phone and gateway on the speaker's chair,
    you 20 m behind; no house WiFi. Do Not Disturb and Auto-Lock off; the meter
    is used before the second phone records; calibration 60-65 dB(A) with a
    logger warning above 70; volume set once with any button.
2026-10-21 The Saturday test gets its own page
    weekend-test.md holds the steps, logger button and folded details; the MVP
    page becomes the MVP path and keeps the speaker reasoning. Links updated.
2026-10-21 Flash the XIAO kits from the site
    A one-page flasher installs the tripwire detector and gateway on the
    Seeed XIAO ESP32S3 + Wio-SX1262 kits we bought, replacing Meshtastic.
    It writes one random network key to both, and the hotspot, broker and
    the logger's gateway ID to the gateway. Images built by tripwire-firmware
    CI at 0ebd868. The Saturday steps, kit card and kit tables use the XIAO.
2026-10-21 Saturday test without a drone; QR from flasher to logger
    The test is speaker-only, so the flight step is gone and a real flight
    moves to layer 2. The flasher makes up the gateway ID and shows a QR code
    that opens the logger with it and connects. The XIAO detector now checks
    in every minute (tripwire-firmware 879da1e), which the radio walk counts.
    Parts line gains a second power bank, windscreens and soldering.
2026-10-21 trip/wire: logger saves sessions online; sweep records background
    The logger PUTs each session to a small Worker (worker/, KV) as it goes,
    so nothing is exported and results can be read from any session. Start
    sequence now records 30 min of background after the speaker sweep. The
    Sync clap is optional, for training clips; cut_clips.py reads a saved
    session with --session latest. Site and links renamed to trip/wire.
2026-10-21 Header wordmark: trip/wire
2026-10-21 Header wordmark in lower case, as written
2026-10-21 Logger runs the whole test: mic phone as meter and recorder
    The second phone opens the logger's mic page from a QR code. It measures
    A-weighted level (set once against a meter app) and records, and the logger
    reads it live over the broker, fills both calibration readings with
    Measure at the mic, and starts/stops the recording with the speaker
    sequence. Runs keep the aimed level, the measured level and the detector's
    own level. cut_clips.py --mic aligns on the logged recording start.
2026-10-21 Logger: plain labels, a built-in guide, and a mic phone with no board
    The readings get plain names, and a "What the numbers mean" section
    explains dB, dB(A), dBFS, setting the meter, emulated distance, RSSI and
    SNR, with everyday sounds for scale. It shows on the mic page too.
    The logger now listens for the mic phone on load, so the speaker test can
    be tried at a desk without a gateway.
2026-10-21 Use US units on every page and in the logger
    Distances in inches, feet, yards and miles; mass in ounces and pounds;
    wind and speed in mph; temperature in F; cost per square mile. The
    logger takes feet and inches, exports distance_ft, altitude_ft and
    mic_height_in, and converts sessions saved in metres on load;
    cut_clips.py reads both and labels clips drone_<n>ft. The 3D viewer
    shows part masses and sizes in ounces and inches. Quotations that gave
    metric figures are paraphrased with the converted figure.
2026-10-21 Drop the demo button and the tested-on note from the weekend test page
2026-10-21 Rebuild the 3D models round the XIAO ESP32S3 + Wio-SX1262 kit
    GPT-6.1 (Codex, 2026-10-21) replaced the Heltec pod with the XIAO kit
    from Seeed's CAD: smaller pod with a USB service cap, no screen, plus a
    stake mount (with its own GLB) and a ballasted drop-test dummy. 140
    checks pass. Build: 3D models is rewritten for it, in US units, with the
    stake viewer, the dummy and the new downloads.
    [body.step, body.stl, bought_18650.step, bought_SG90.step, bought_heltec_v3.step, bought_inmp441.step, bought_rod.step, bought_xiao_wio_stack.step]
2026-10-21 Label every CAD render and the design notes in US units
    GPT-6.1 re-rendered all 33 PNGs and rewrote DESIGN.md, README.md,
    web/README.md, REVIEW.html and checks.md in inches and ounces, and fixed
    the missing spaces in the captions. Geometry, STL/STEP (mm), GLB (m) and
    every json key are unchanged; 140 geometry and 12 export checks still pass.
    Adds the tail-fin brief for the next run.
    [display_units.py, document.py, record_visual_review.py, refresh_stake_wiring.py, render_us_units.py, validate_us_units.py]
2026-10-21 Saturday test: explain the two boards and redraw the layout
    The page called the second XIAO board "the gateway" without saying it
    was a board, and the layout diagram drew only the detector. Add a short
    explanation of the detector, gateway and phone and why the data takes
    the long way round; redraw the diagram with board 1 and board 2, the
    phone and the three links (LoRa, WiFi, Bluetooth); reword the 30 ft
    bullet, which said "all day".
2026-10-21 Two phones, two ends: the mic phone plays the speaker
    The mic phone now stays at the mic with board 1 and the speaker, and plays
    the speaker as well as measuring and recording. The logger phone (the
    hotspot) goes with the gateway and only sends orders. Start sequence hands
    the whole plan to the mic phone, which runs it on its own clock, recording
    included, so it carries on if the logger loses signal. One phone remains a
    fallback. The Saturday test page and its layout diagram are redrawn as a
    sound end and a receiving end, joined only by the LoRa link under test.
2026-10-21 Tail fins for the dart, with balance and fall renders
    GPT-6.1 (codex exec, xhigh) carried out BRIEF-tail-fins.md: four long, low
    PETG fins on two bonded collars move the estimated centre of pressure from
    11.85 to 13.95 in from the tip, a static margin of 3.06 in (2.08 body
    widths, up from 1.25). Dart 5.91 oz, balance point 10.89 in; four darts and
    harness 1.88 lb; dummy re-solved with 1.30 oz ballast. Flat carriage kept,
    since an offset hanger jams the head against the rotor. New renders:
    dart_balance, dart_fins_detail, dart_fall_sequence (schematic). 164/164
    checks pass. build-3d.md gains a fall-point-first section with the margin
    and wind tables, and every mass and count is updated.
    Co-Au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
    [body.step, body.stl, bought_18650.step, bought_SG90.step, bought_inmp441.step, bought_rod.step, bought_xiao_wio_stack.step, dart_stood.step]
2026-10-21 Saturday test: show what each phone's screen looks like
    One page, two screens: trip/wire logger on the logger phone, trip/wire
    mic on the mic phone. The gateway has no screen; the laptop runs the
    logger screen for the meter step only.
2026-10-21 Logger: ask which phone this is; phones find each other, nothing to scan
    The first screen offers Logger phone, Mic phone and Just watching. The
    logger lists gateways online on the broker, the mic phone and watchers
    list open loggers, each joined with one tap. A mic phone that joined
    before the logger picked its gateway follows it. The flasher's QR code
    is gone; the page and screenshots follow the new flow.
2026-10-22 Logger phone gives the gateway its hotspot in the park
    Firmware 599ccac: a gateway that can't reach a hotspot it knows opens its
    own setup network, and the logger phone types its hotspot into the page
    that opens. Nothing about the phones is fixed at flashing any more, so the
    flasher's hotspot is optional (one slot again), and the logger's Connect
    steps and the Saturday page say how to do it from the field.
    Built locally with ESP-IDF v6.0; the setup page's DNS and form code tested
    on a host build, not yet on a XIAO.
2026-10-22 Saturday test: the kit at a glance, and steps split home vs park
    Each item says what it's for and where it sits on the day (the laptop
    stays home). Steps are 1-4 at home and 5-10 in the park, each tagged
    with the devices it uses; the gateway check is its own step.
2026-10-23 12 darts in the field: redraw as a relay chain, compare trail, crossbar, arc
    Darts pass the alert back hop by hop (~980 ft). Map toggles three layouts
    of the same 12 darts; table weighs depth against width.
2026-10-23 New sections: How it works and Projected costs
    The net page becomes How it works, listed after 3D models: adds how a
    net is laid (planning, sorties, trunks first, check-in, spares), finding
    drop points with GPS jammed (optical flow, map-matching vision), and the
    placement requirements, including that drop accuracy sets the dart count
    (20 darts at none, 24 at +-66 ft, 30 at +-160 ft). Projected costs prices
    each component at prototype, small-batch and production scale, the net
    and its re-lays, and suggests pricing for the proposal.
2026-10-23 Two trunks by default; price the whole package at cost plus markup
    How it works shows only the two-trunk net; the single trunk is dropped
    as too fragile. Projected costs now totals the whole package, drone,
    batteries and charger included, and prices it as our cost plus a 30%,
    50% or 100% markup.
2026-10-23 How it works: when it breaks, with a repair animation
    Failure table and repair costs, a daily relayed roll call, drop-then-confirm
    with a receive-only radio on the drone, what the drone knows, and the open
    vision-navigation options (NGPS, gnss-denied-nav).
2026-10-23 How it works: a working lay model, with a video of one lay
    tools/laymodel/lay_model.py plans the two-trunk net on a sector map (trees,
    a ravine, slope, the enemy edge, wind), checks every sortie against the
    battery with a gust margin, writes terrain-relative ArduPilot missions, and
    lays the net 1,000 times with drop errors, bad landings and radio fading.
    The page's video replays one simulated lay. Findings and the 14 holes it
    closed are on How it works; Projected costs is repriced to match: a lay
    takes about 35 darts and 9 sorties, and the drone gains about $420 of kit.
2026-10-23 Bring every page and both older animations in line with the lay model
    The top net and repair animations now place the end darts 300 ft past
    the 45-degree lines and route alerts through a hand-placed root dart:
    22 darts plus the root on open ground. Tables, hop counts, the failure
    table and the cost and lay figures on other pages use the model's numbers.
2026-10-23 Guarding a road, a jamming model, and every page in line with both
    A route model (tools/routemodel) and a new page, Guarding a road: posts
    along the road hear drones that land to wait, and a fence of air-dropped
    darts about a mile out gives the minute. On two invented 4 mi roads,
    about 20-28 darts and posts a mile, at least 58 s for every drone flying
    in, and every landing within 300 ft heard. Costs and a new test, T20.
    A jamming model (tools/jamming): on the main estimate a jammer near the
    ground blinds a dart only within a few hundred feet, about a mile in the
    worst case. The unit's own jammers deafen receivers at the positions and
    in trucks, so the position gets forward roots on fibre an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
2026-10-23 Lay model: fibre trunks and +/-60 coverage as options, and a comparison run
    lay_model.py gains COVER_DEG, JUDGE_DEG, FIBRE, TIP_G and P_SNAG. The
    defaults reproduce the page's numbers. fibre_cases.py lays each case
    1,000 times and writes out/fibre-summary.md.
2026-10-23 Fibre home and +/-60 per position: the plan, the animations and every page
    The net loses its relay trunks. Two tip darts in the front row carry
    FPV fibre paid out by the drone to a base box at the launch point,
    which wires alerts to each position; a heartbeat down each fibre
    confirms a tip when laid and shows a cut within 30 s. Each position is
    covered +/-60.
    lay_model.py now defaults to this plan (16 planned, about 22 darts and
    7 sorties a lay, 98% whole, 98% whole after a fibre cut) and compares
    the last plan; jam_model.py runs on the fibre net. The lay video, the
    net map and the repair animation are redone. How it works, Projected
    costs, Build: software and hardware, the tripwire page an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
2026-10-23 Road guard: fence trunks on FPV fibre, as on the position net
    Every 2 mi a tip dart in the road's fence sends its alerts down an FPV fibre
    to a post, replacing the radio relay trunks. route_model.py gains a FIBRE
    switch (old plan kept as a case), tip-first sorties launched from the post,
    fibre snags while laid, fibre cuts between repairs and their cost. The
    jamming model lets light down a fibre reach a deaf post.
    35-58 air-dropped darts for 4 mi (was 60-93), every strike track still
    gets a minute, no single fibre cut costs a track, worst-case truck jamming
    keeps 21-46% (was 2-22%). Page, animation, costs and changelog updated.
2026-10-23 Road page: per-mile comparison against nets, Zvook, interceptors, detectors
    Posts first: about $1,600 a mile a year, and nothing on sale hears a
    fibre-optic FPV land to wait. The fence costs about as much as netting a
    road and pays where roads won't be netted, matter for weeks, or have cover
    within a minute. Break-even and what would break the case.
2026-10-23 Tripwire page: visual top (pilot)
    Diagram of the row, warning-time bars, step cards, test chain and
    three cards. The old text moves into a fold-out, nothing deleted.
2026-10-23 Build: software: chain diagram, coverage bars, sections folded
2026-10-23 Flow diagram: white title on the dark node
2026-10-23 Open questions: test board by what each test decides, table folded
2026-10-23 Software plan: findings as cards, phase board, sections folded
2026-10-23 Lives estimate: the chain as a funnel, sections folded
2026-10-23 Overview: diagram, step cards and test chain; long text folded
2026-10-23 Sensor models: score meters, verdict lede, cost cards; history folded
2026-10-23 Feasibility 4, split markup, the mic array in costs, a lower upkeep floor
    - The tripwire's feasibility rises from 3 to 4: the fibres home took out the
    long radio link the 3 rested on. Rating history says what drops it back.
    - Pricing: our own hardware at +200-300%, the off-the-shelf drone kit at +30%.
    - Every dart carries the 4-mic array (4 analog MEMS mics, ES7210, compass)
    instead of one INMP441. Road guard re-run at the new dart and tip prices;
    only its cost lines changed. Posts keep one mic.
    - Upkeep range now starts at the 2-re-lay case, with a second cell per dart
    as an unchecked option.
2026-10-23 Countermeasures section: the fibre cutter
    A new nav section. Countermeasures covers why the fibre is the weak
    point and what is already fielded (scissors, a rotating barbed wire,
    Logika's Chaharnyk). The fibre cutter is a fence wire on 165 ft spans
    with a trolley on each span that cuts the line lying over it, on a
    tripwire alert. It covers parts, cost a mile, laying, power and upkeep,
    and adds tests C1-C3. The numbers come from tools/cuttermodel/cutter_model.py.
2026-10-23 Countermeasures: the laser page and its model
    Checks the claim that a laser can cut a fibre FPV's line in a moment:
    the energy per mm, the dwell by power and spot, a loop around a parked
    drone from a road post, the camera-blinding option, cost, safety, the
    treaty, and tests L1-L3.
2026-10-23 The laser: run the fibre in the figure all the way to the drone
2026-10-24 Add rotor model: a turning barbed wire that winds up fibre lines
    Torque, twist, power, solar and parts per mile for a slow, always-on
    rotating barbed-wire cutter built from farm and hobby parts. No page yet.
2026-10-24 Rotor model: halve the cost a mile, to about $1.1k
    One motor turns a whole 1,320 ft roll from its middle, so there are 4
    motors a mile, not 16, and swivels only between rolls. Lighter 15.5 ga
    high-tensile barbed wire, 132 ft spans, 3 rpm all the time.
2026-10-24 Band cutter: cost and speed model, and the 3D brief for GPT-6.1
    Strap loops between T-posts, every other post a small solar drive, hooks
    carrying a fibre into fixed utility blades. About $7.1k a mile at 33 ft
    spans and a 15 s worst-case cut; cut force and loop drag are untested.
2026-10-24 Band cutter: redesign to under $1k a mile
    Nylon monofilament loops, 660 ft each, on 3/8 in fibreglass rods every
    50 ft with snapped-off blade segments; printed TPU catchers every 3 ft;
    one car window-motor drive post per 1,320 ft. About $900 a mile and a
    17 s worst-case cut. Brief updated for GPT-6.1.
